simenrostad/Bachelor-Nordic_Semi/Misc/Pichures/Bilder av 3dprintene/bakknapKopi.jpg

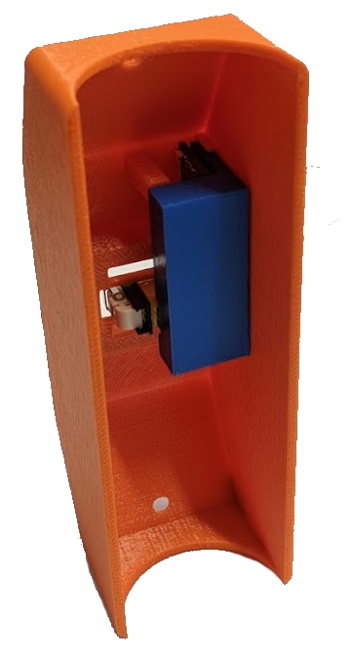
Misc/Pichures/Bilder av 3dprintene/bakknapKopi.jpg
