simenrostad/Bachelor-Nordic_Semi/Misc/readme.md

This folder contains all miscellaneous files and literature used during this project, 
including pictures of tests, 3D print files, flowcharts and links to various web pages that we found useful.
