simenrostad/Bachelor-Nordic_Semi/Hardware/Litteratur/Altium litratur/linker.txt

https://www.ece.ufl.edu/content/altium-designer-video-tutorials

https://altiumvideos.live.altium.com/#Detail/1226

youtube vidioer
-------------------------------------------------
https://www.youtube.com/watch?v=NXB1lSWvcCs

https://www.youtube.com/watch?v=Det_Jr88dBY

https://www.youtube.com/watch?v=TWcL0OF_eQI

https://www.youtube.com/watch?time_continue=5&v=ggVu_U-CsAk

vidioer
-------------------------------------------------
https://www.fedevel.com/academy/portfolio-items/tip-052-in-power-supply-placement-place-output-capacitors-close-to-the-power-output/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
