simenrostad/Bachelor-Nordic_Semi/Misc/Useful links/https.docx

https://devzone.nordicsemi.com/f/nordic-q-a/7597/nrf51-power-management-for-energy-harvesting-applications
