simenrostad/Bachelor-Nordic_Semi/Hardware/simulations/LTC simulering skarakteristikk for effektivitet.xlsx

Voltage mode | Load | Load Ohm |  | 5V | 6V | 7V | 8V | 9V | 10V
1.8V | 100mA | 18 Ohm | 1V8 | 65 | 48 | 39 | 33.6 | 29.2 | 26 | mA
2.5V | 100mA | 25 Ohm | 2V5 | 90 | 65 | 52.5 | 44.1 | 38.4 | 33.9 | mA
3.3V | 100mA | 33 Ohm | 3V3 | 0 | 87 | 68.4 | 56.8 | 49.2 | 43.2 | mA
3.6V | 100mA | 36 Ohm | 3V6 | 0 | 90 * | 74.4 | 62 | 53.2 | 46.8 | mA
 |  | * = not continius suply
