simenrostad/Bachelor-Nordic_Semi/Misc/Measurements and calculations/Energy/Design spesification and energy budget 1.2.xlsx

21 bytes
20ms advertising interval
DCDC
0dBm TX power
ble_app_beacon
BLE event PPK 10 event average values
Voltage | Time in ms | Average current in μA | Work in μWs | percent difference to OPP
2.85 | 25 | 500 | 35.6 | 95.42%
ble_app_pwr_profiler |  |  |  |  | ehsb_nordic_b
BLE event OPP |  |  |  |  | Estimated Work
Voltage | Time in ms | Average current in μA | Work in μWs |  | Work in μWs
1.7 | 25 | 739 | 31.4 |  | 24.0
1.8 | 25 | 713 | 32.1 |  | 24.5
1.9 | 25 | 684 | 32.5 |  | 24.8
2 | 25 | 661 | 33.0 |  | 25.2
2.1 | 25 | 640 | 33.6 |  | 25.6
2.2 | 25 | 621 | 34.2 |  | 26.1
2.3 | 25 | 603 | 34.7 |  | 26.5
2.4 | 25 | 586 | 35.2 |  | 26.8
2.5 | 25 | 570 | 35.6 |  | 27.2
2.6 | 25 | 555 | 36.1 |  | 27.5
2.7 | 25 | 542 | 36.6 |  | 27.9
2.8 | 25 | 530 | 37.1 |  | 28.3
2.85 | 25 | 524 | 37.3 |  | 28.5
2.9 | 25 | 519 | 37.6 |  | 28.7
3 | 25 | 508 | 38.1 |  | 29.1
3.1 | 25 | 497 | 38.5 |  | 29.4
3.2 | 25 | 485 | 38.8 |  | 29.6
3.3 | 25 | 478 | 39.4 |  | 30.1
3.4 | 25 | 471 | 40.0 |  | 30.6
3.5 | 25 | 465 | 40.7 |  | 31.0
3.6 | 25 | 460 | 41.4 |  | 31.6
 |  |  |  |  | percent change 2,85 to 1,8
 |  |  |  |  | 0.86
Best measurements are at DK voltage 2,85V
ehsb_nordic_b
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
