simenrostad/Bachelor-Nordic_Semi/Hardware/Litteratur/Impedanc calculator 1.PNG

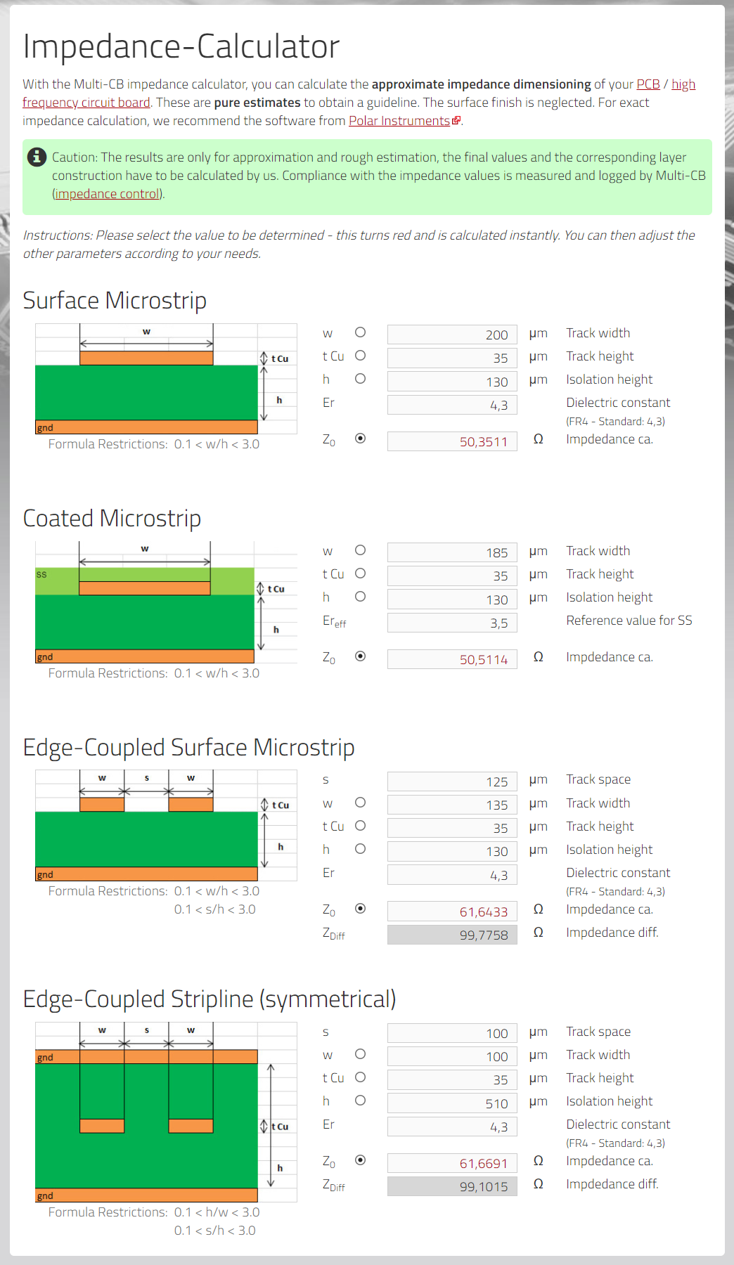
Hardware/Litteratur/Impedanc calculator 1.PNG
