simenrostad/Bachelor-Nordic_Semi/Hardware/Litteratur/Impedanc calculator 2.PNG

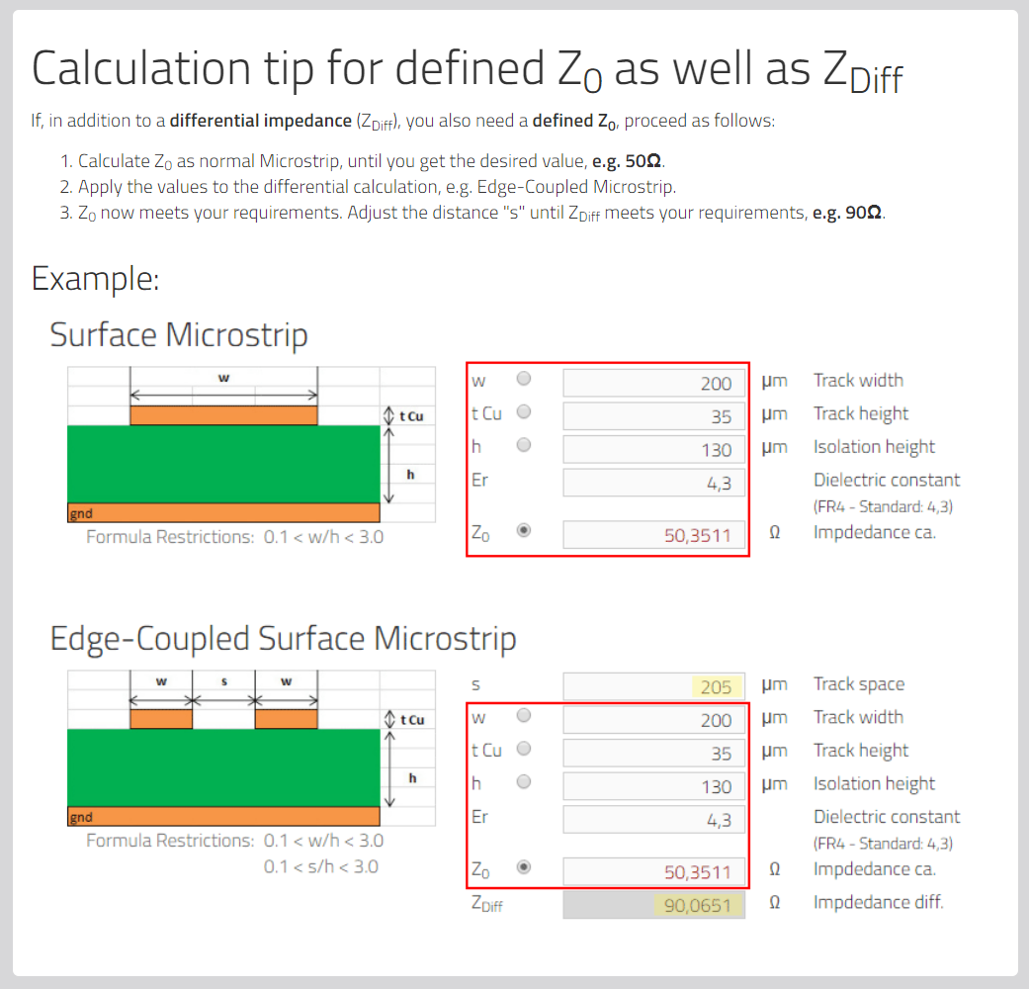
Hardware/Litteratur/Impedanc calculator 2.PNG
