simenrostad/Bachelor-Nordic_Semi/Hardware/System Block Diagram.png

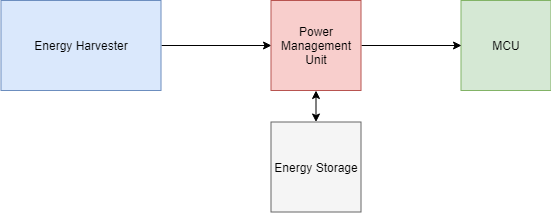
Hardware/System Block Diagram.png
