simenrostad/Bachelor-Nordic_Semi/Misc/Pichures/Bilder av 3dprintene/bakknap.jpg

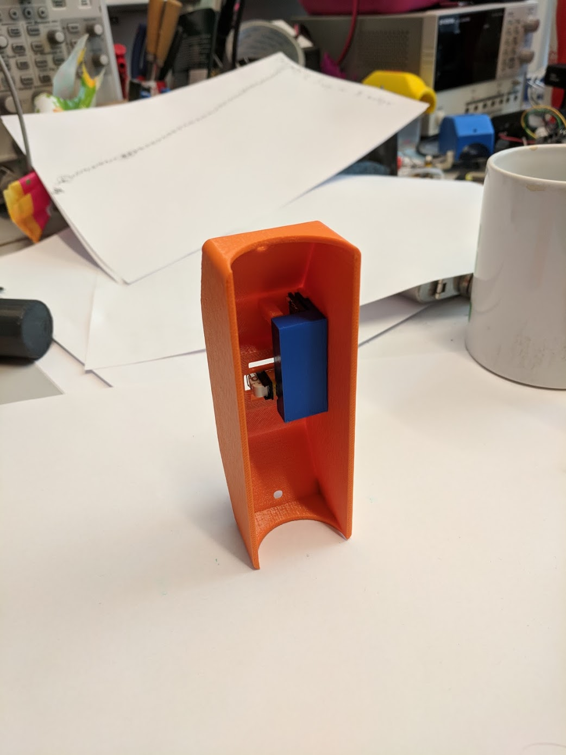
Misc/Pichures/Bilder av 3dprintene/bakknap.jpg
