simenrostad/Bachelor-Nordic_Semi/Misc/Pichures/Bilder av 3dprintene/blodknapp – Kopi.jpg

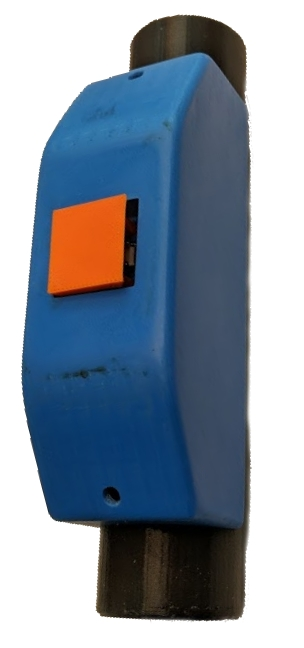
Misc/Pichures/Bilder av 3dprintene/blodknapp – Kopi.jpg
