simenrostad/Bachelor-Nordic_Semi/Misc/Pichures/Bilder av 3dprintene/blodknapp.jpg

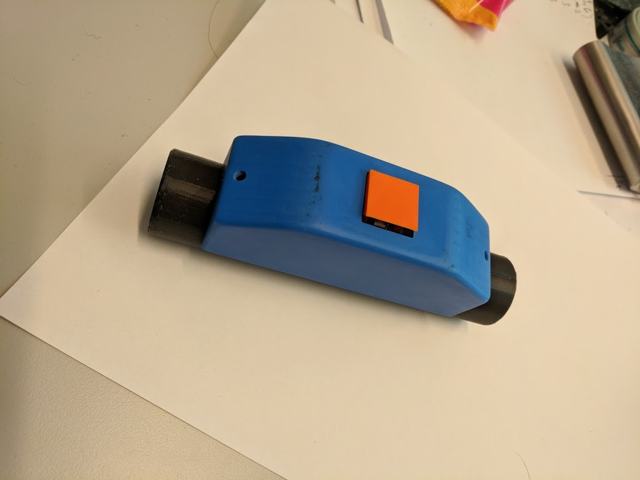
Misc/Pichures/Bilder av 3dprintene/blodknapp.jpg
