simenrostad/Bachelor-Nordic_Semi/Misc/Pichures/Bilder av 3dprintene/Realayer.jpg

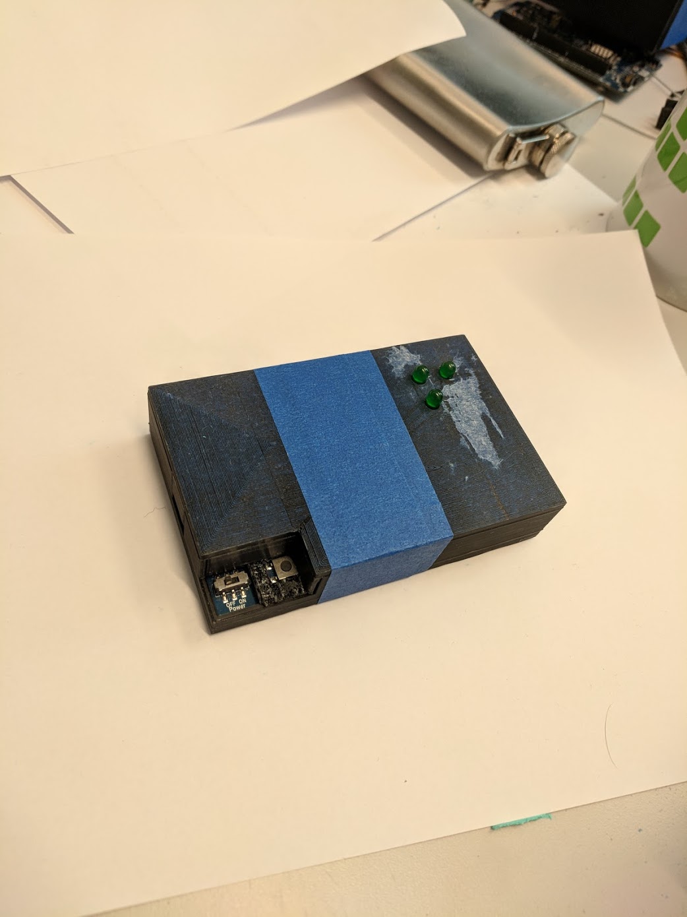
Misc/Pichures/Bilder av 3dprintene/Realayer.jpg
