simenrostad/Bachelor-Nordic_Semi/Misc/Pichures/Bilder av 3dprintene/RealayerKopi.jpg

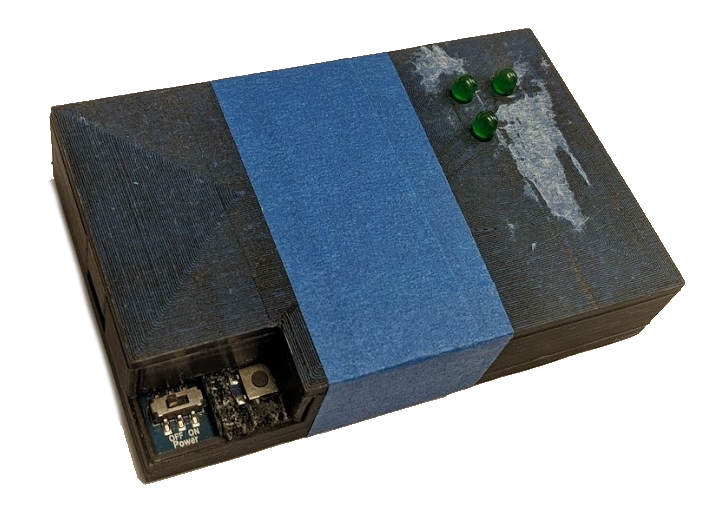
Misc/Pichures/Bilder av 3dprintene/RealayerKopi.jpg
