simenrostad/Bachelor-Nordic_Semi/Misc/Pichures/Bilder av 3dprintene/rodsknap.jpg

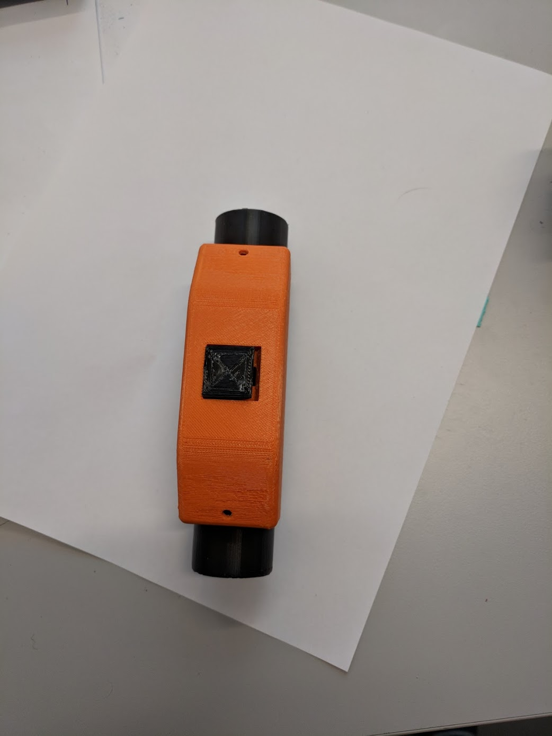
Misc/Pichures/Bilder av 3dprintene/rodsknap.jpg
