simenrostad/Bachelor-Nordic_Semi/Misc/Pichures/Bilder av 3dprintene/rodsknapKopi.jpg

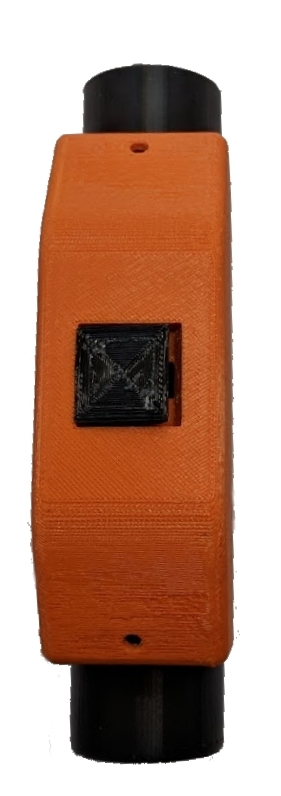
Misc/Pichures/Bilder av 3dprintene/rodsknapKopi.jpg
