simenrostad/Bachelor-Nordic_Semi/Misc/Pichures/Bilder av 3dprintene/STOPsighn.jpg

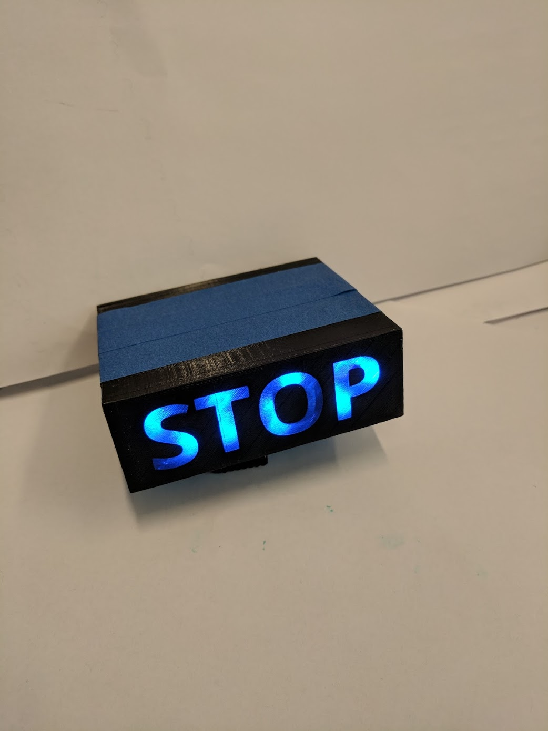
Misc/Pichures/Bilder av 3dprintene/STOPsighn.jpg
