simenrostad/Bachelor-Nordic_Semi/Misc/Pichures/Bilder av 3dprintene/STOPsighnKopi.jpg

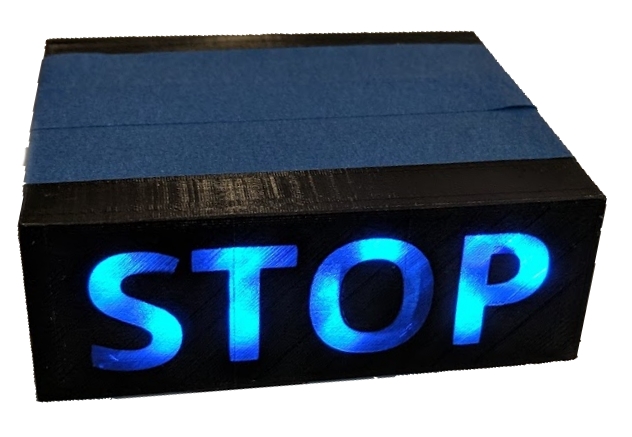
Misc/Pichures/Bilder av 3dprintene/STOPsighnKopi.jpg
