simenrostad/Bachelor-Nordic_Semi/Misc/Pichures/Bileter av 3D-ting/knapp_allerfyrste_front.png

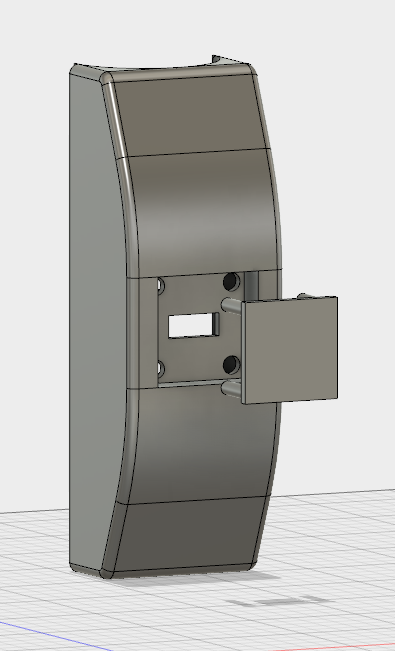
Misc/Pichures/Bileter av 3D-ting/knapp_allerfyrste_front.png
