simenrostad/Bachelor-Nordic_Semi/Misc/Pichures/Bileter av 3D-ting/knapp_denfyrste.png

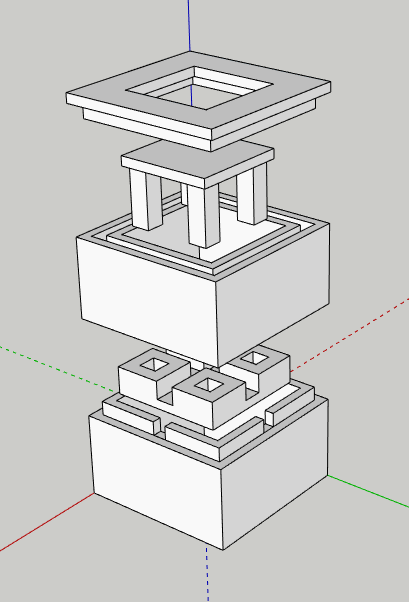
Misc/Pichures/Bileter av 3D-ting/knapp_denfyrste.png
