simenrostad/Bachelor-Nordic_Semi/Misc/Pichures/Bileter av 3D-ting/mini_1.png.PNG

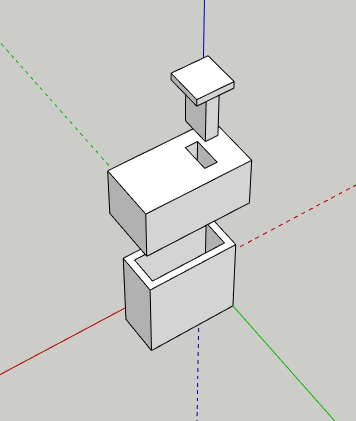
Misc/Pichures/Bileter av 3D-ting/mini_1.png.PNG
