simenrostad/Bachelor-Nordic_Semi/Misc/Pichures/Bileter av 3D-ting/mini_snapgreier.PNG

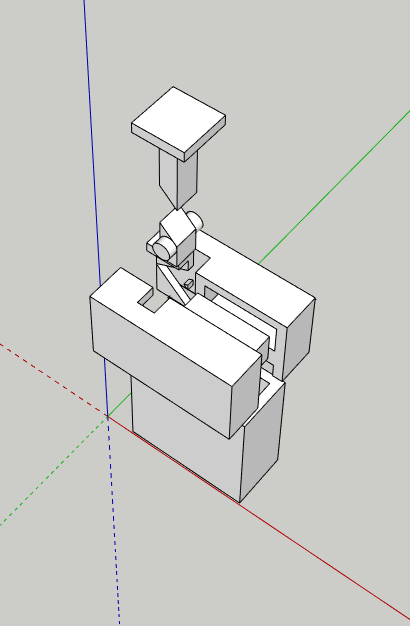
Misc/Pichures/Bileter av 3D-ting/mini_snapgreier.PNG
