simenrostad/Bachelor-Nordic_Semi/Misc/Pichures/Bileter av 3D-ting/mini_snurreting.PNG

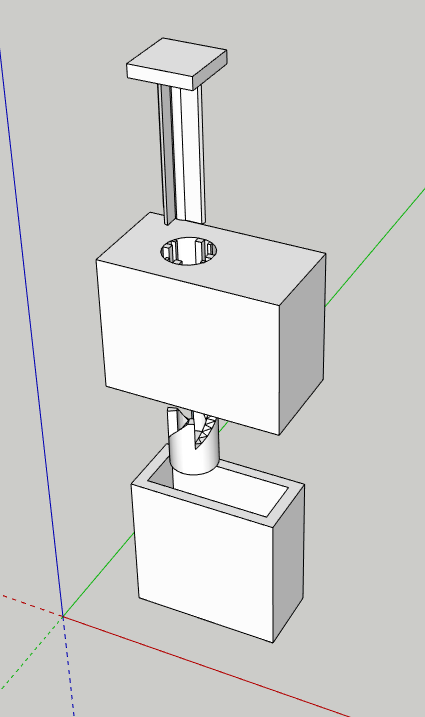
Misc/Pichures/Bileter av 3D-ting/mini_snurreting.PNG
