simenrostad/Bachelor-Nordic_Semi/Misc/Pichures/Bileter av 3D-ting/plass til gibbrett og batteri.PNG

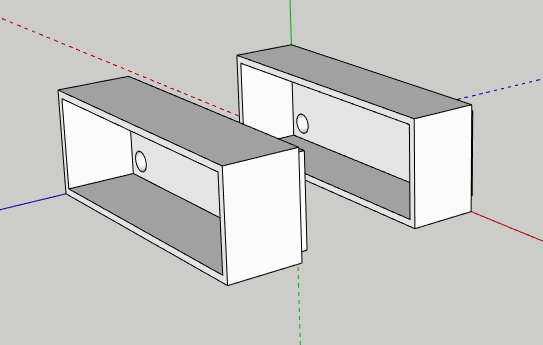
Misc/Pichures/Bileter av 3D-ting/plass til gibbrett og batteri.PNG
