simenrostad/Bachelor-Nordic_Semi/Misc/Pichures/gant1.PNG

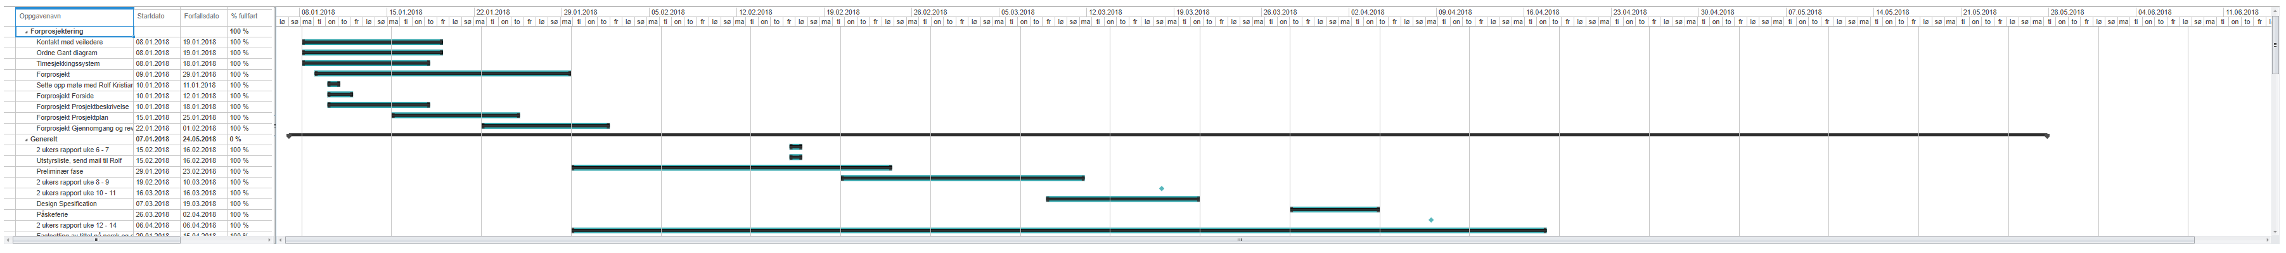
Misc/Pichures/gant1.PNG
