simenrostad/Bachelor-Nordic_Semi/Misc/Pictures/04mai_dc-dcanalycer molinger.PNG

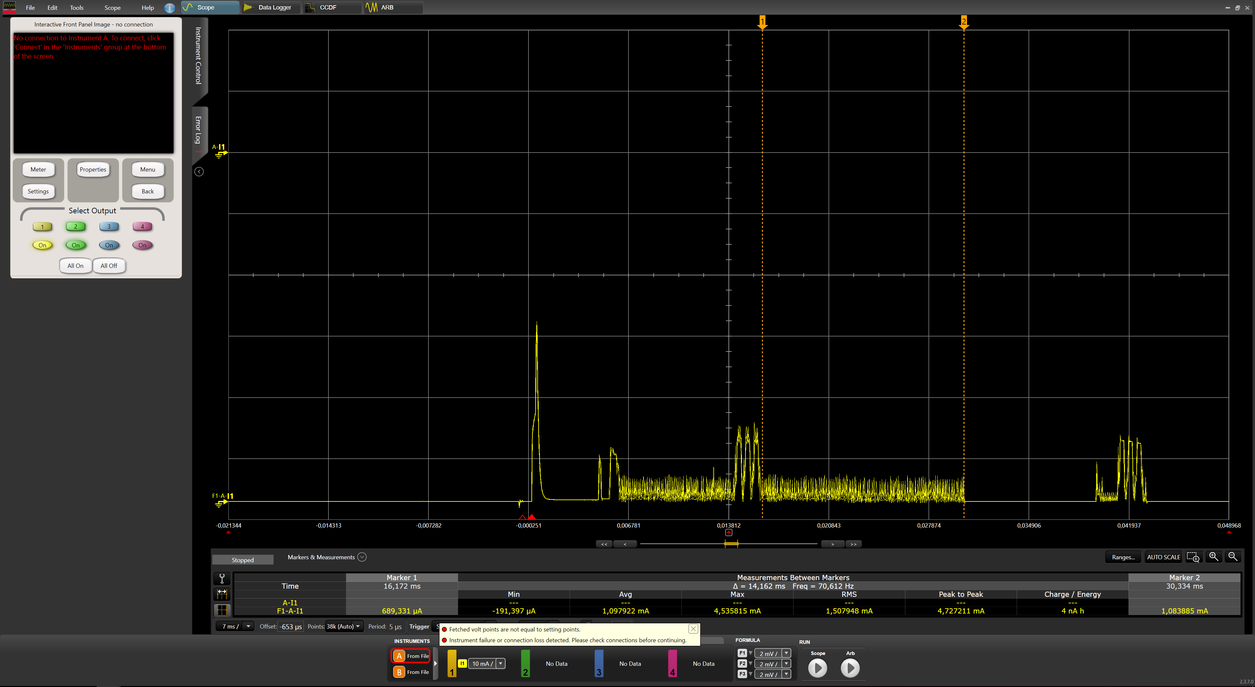
Misc/Pictures/04mai_dc-dcanalycer molinger.PNG
