simenrostad/Bachelor-Nordic_Semi/Misc/Pictures/5packages.png

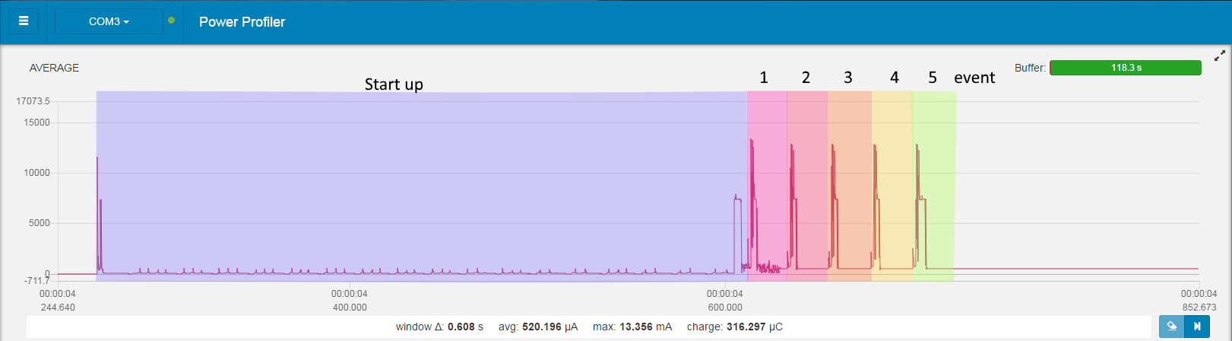
Misc/Pictures/5packages.png
