simenrostad/Bachelor-Nordic_Semi/Misc/Pictures/30926791_10215877826407681_405234090_o.png

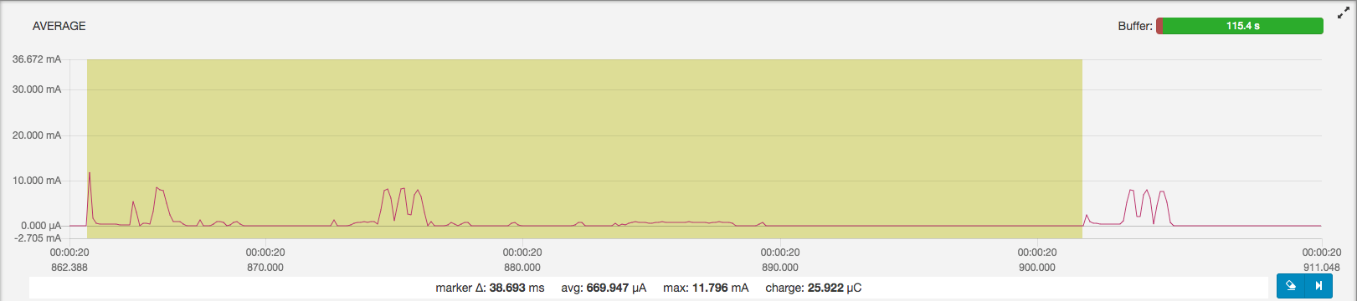
Misc/Pictures/30926791_10215877826407681_405234090_o.png
