simenrostad/Bachelor-Nordic_Semi/Misc/Pictures/31248437_10215877827527709_2145009376_o.png

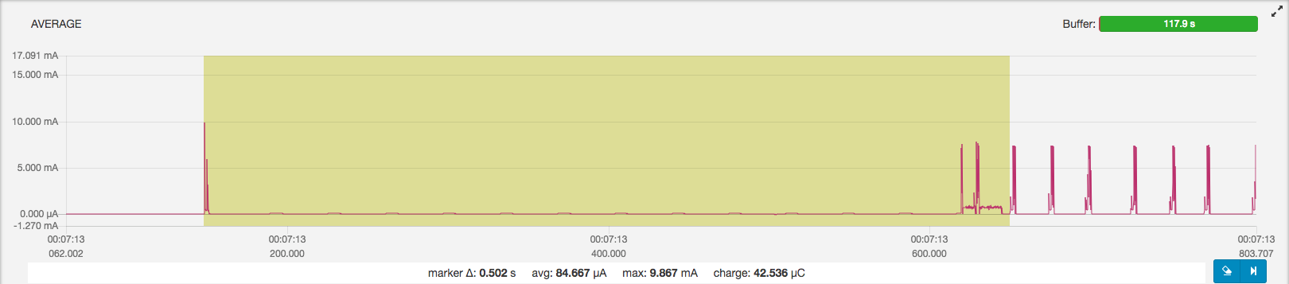
Misc/Pictures/31248437_10215877827527709_2145009376_o.png
