simenrostad/Bachelor-Nordic_Semi/Misc/Pictures/afigspoooulandf.PNG

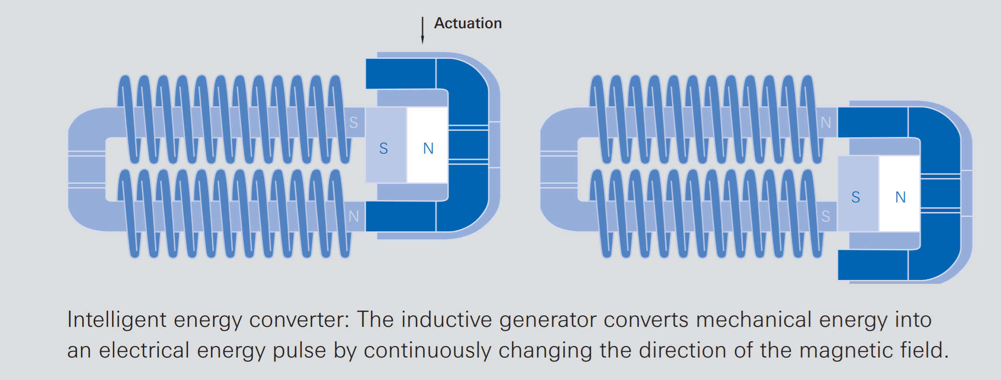
Misc/Pictures/afigspoooulandf.PNG
