simenrostad/Bachelor-Nordic_Semi/Misc/Pictures/afigspoooulandflow.PNG

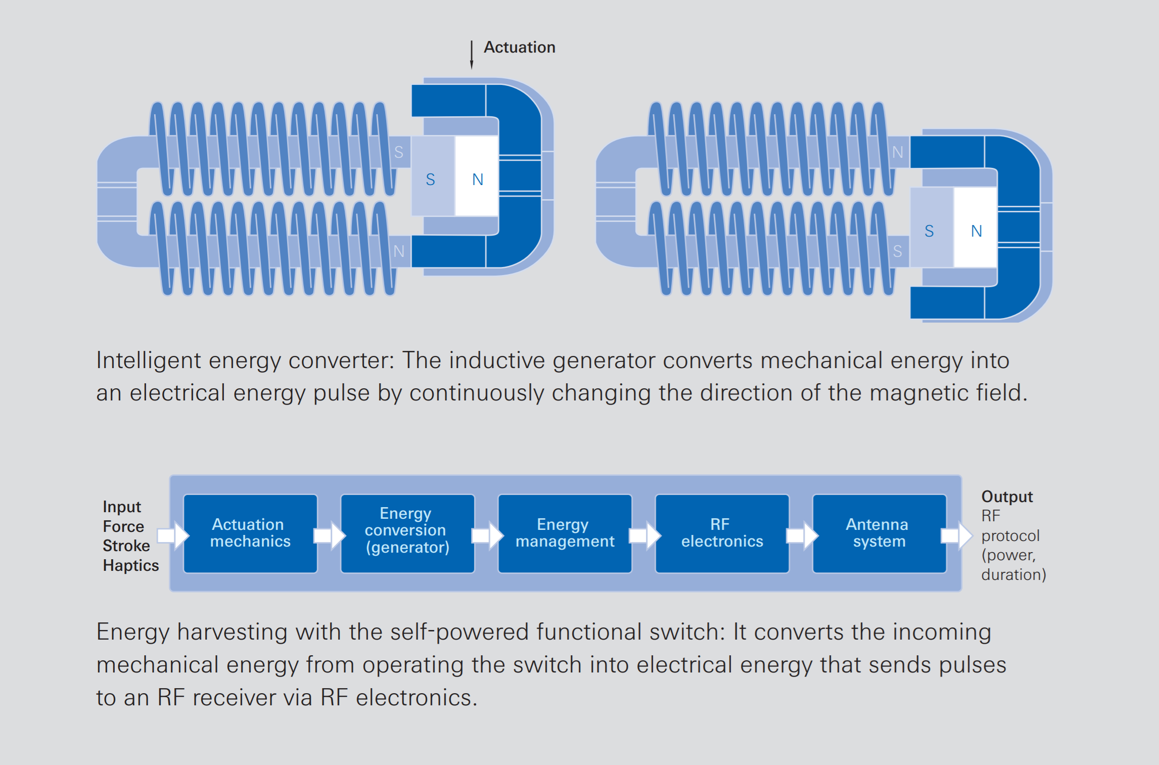
Misc/Pictures/afigspoooulandflow.PNG
