simenrostad/Bachelor-Nordic_Semi/Misc/Pictures/Bileter av 3D-ting/central_casing.png

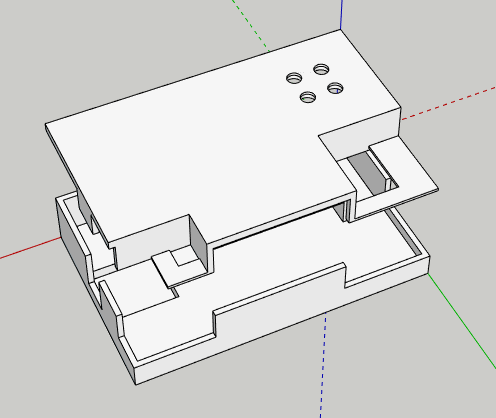
Misc/Pictures/Bileter av 3D-ting/central_casing.png
