simenrostad/Bachelor-Nordic_Semi/Misc/Pictures/Bileter av 3D-ting/CentralBoks_bunn.PNG

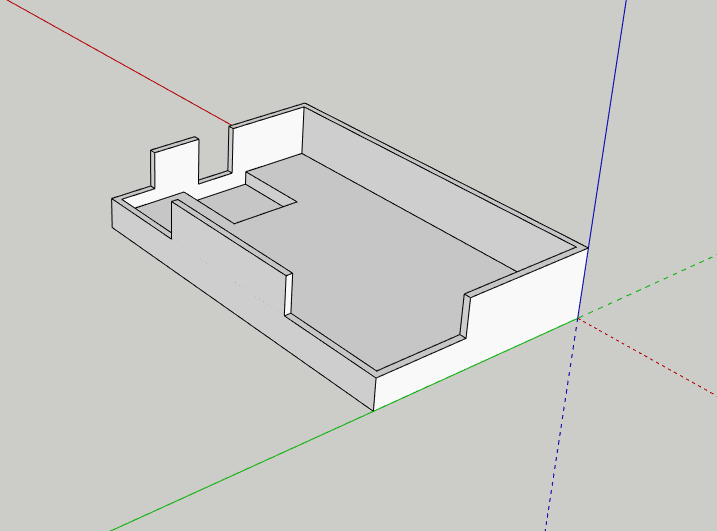
Misc/Pictures/Bileter av 3D-ting/CentralBoks_bunn.PNG
