simenrostad/Bachelor-Nordic_Semi/Misc/Pictures/Bileter av 3D-ting/CentralBoks_topp.PNG

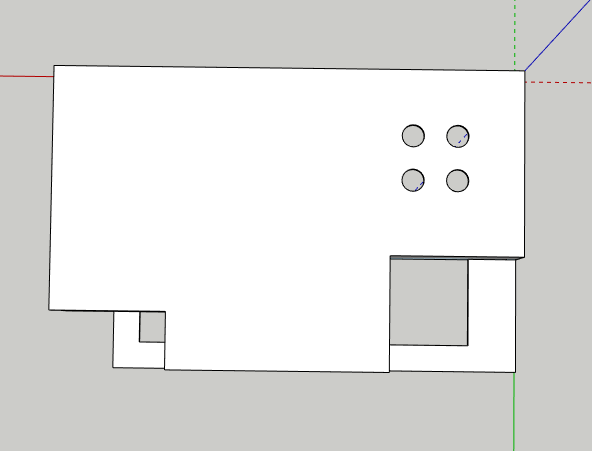
Misc/Pictures/Bileter av 3D-ting/CentralBoks_topp.PNG
