simenrostad/Bachelor-Nordic_Semi/Misc/Pictures/Bileter av 3D-ting/CentralBoks_topp_littfrasida.PNG

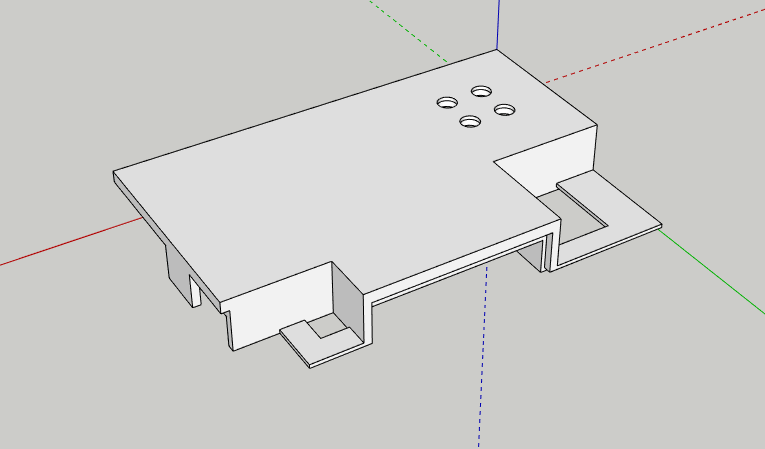
Misc/Pictures/Bileter av 3D-ting/CentralBoks_topp_littfrasida.PNG
