simenrostad/Bachelor-Nordic_Semi/Misc/Pictures/Bileter av 3D-ting/knapp_casing_final_front.PNG

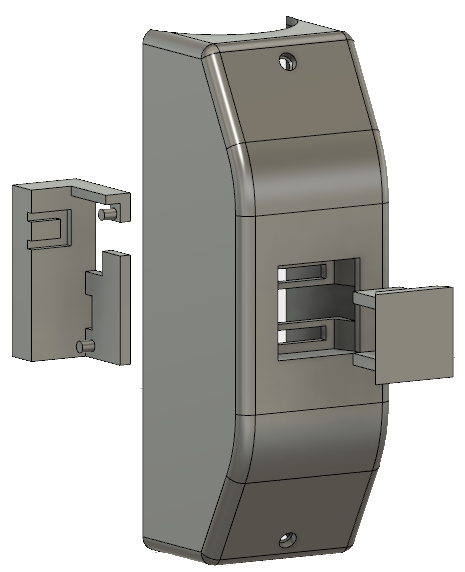
Misc/Pictures/Bileter av 3D-ting/knapp_casing_final_front.PNG
