simenrostad/Bachelor-Nordic_Semi/Misc/Pictures/Bileter av 3D-ting/knapp_casing_firstiteration_back.PNG

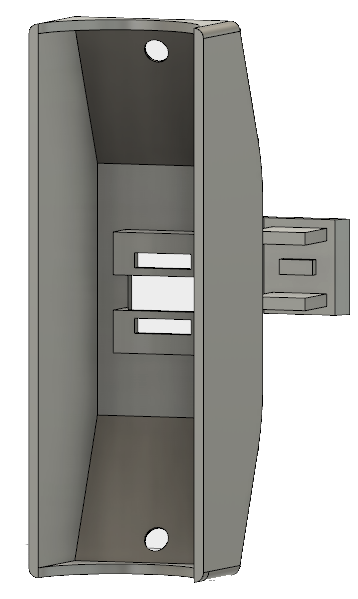
Misc/Pictures/Bileter av 3D-ting/knapp_casing_firstiteration_back.PNG
