simenrostad/Bachelor-Nordic_Semi/Misc/Pictures/Bileter av 3D-ting/Knapp_front.PNG

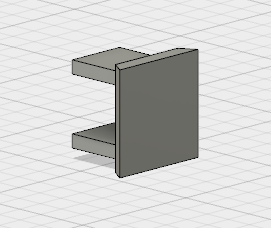
Misc/Pictures/Bileter av 3D-ting/Knapp_front.PNG
