simenrostad/Bachelor-Nordic_Semi/Misc/Pictures/Bileter av 3D-ting/KnappHus_frontoghøgre.PNG

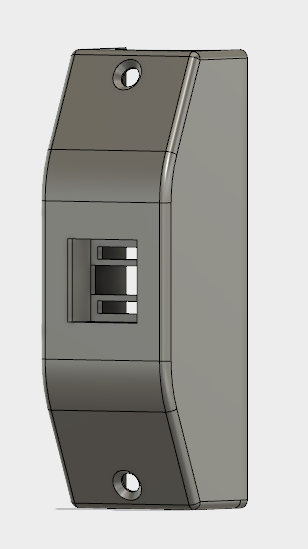
Misc/Pictures/Bileter av 3D-ting/KnappHus_frontoghøgre.PNG
