simenrostad/Bachelor-Nordic_Semi/Misc/Pictures/Bileter av 3D-ting/KnappHus_frontogvenstre.PNG

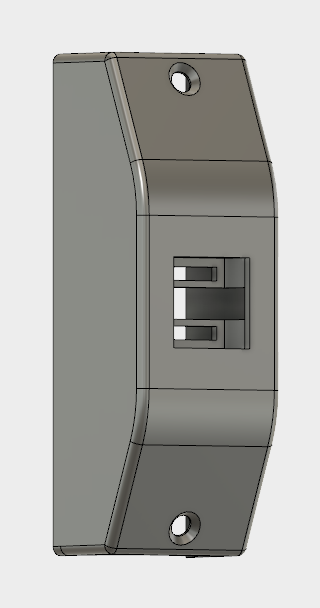
Misc/Pictures/Bileter av 3D-ting/KnappHus_frontogvenstre.PNG
