simenrostad/Bachelor-Nordic_Semi/Misc/Pictures/Bileter av 3D-ting/KnappHusmedTrykketing_front.PNG

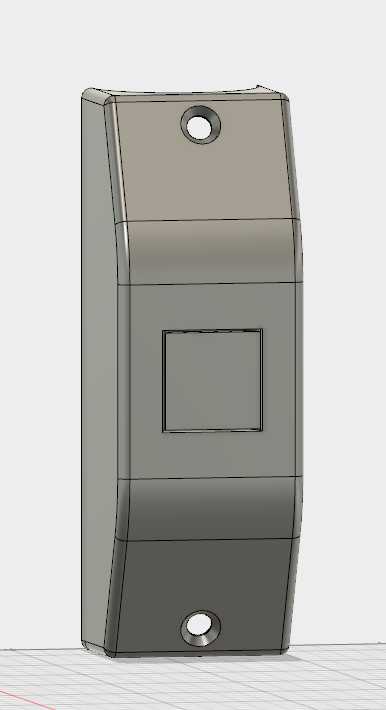
Misc/Pictures/Bileter av 3D-ting/KnappHusmedTrykketing_front.PNG
