simenrostad/Bachelor-Nordic_Semi/Misc/Pictures/Bileter av 3D-ting/KnappHusmedTrykketing_front_fargar.PNG

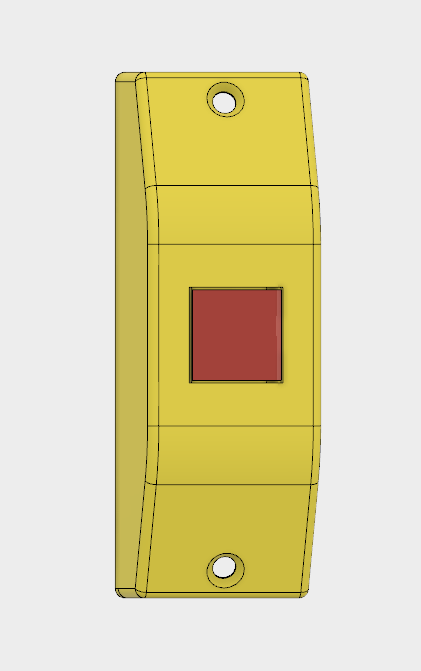
Misc/Pictures/Bileter av 3D-ting/KnappHusmedTrykketing_front_fargar.PNG
