simenrostad/Bachelor-Nordic_Semi/Misc/Pictures/Bileter av 3D-ting/relayer_casing.PNG

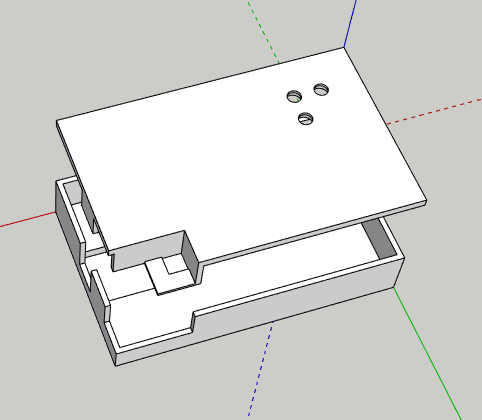
Misc/Pictures/Bileter av 3D-ting/relayer_casing.PNG
