simenrostad/Bachelor-Nordic_Semi/Misc/Pictures/Bileter av 3D-ting/RelayerBoks_bunn.PNG

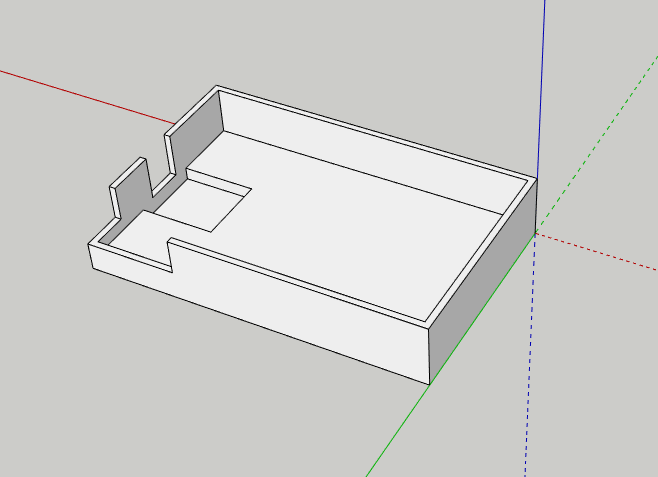
Misc/Pictures/Bileter av 3D-ting/RelayerBoks_bunn.PNG
