simenrostad/Bachelor-Nordic_Semi/Misc/Pictures/Bileter av 3D-ting/Stoppskilt_LED-plate.PNG

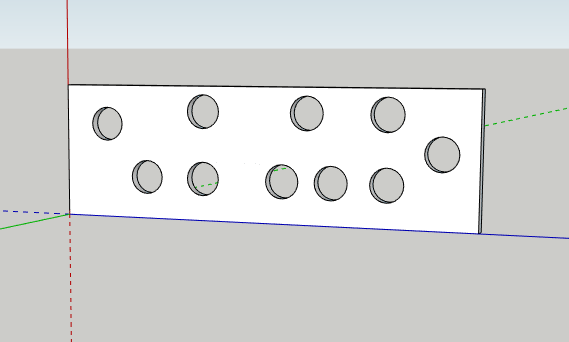
Misc/Pictures/Bileter av 3D-ting/Stoppskilt_LED-plate.PNG
