simenrostad/Bachelor-Nordic_Semi/Misc/Pictures/Bileter av 3D-ting/Stoppskilt_lokk_ut.PNG

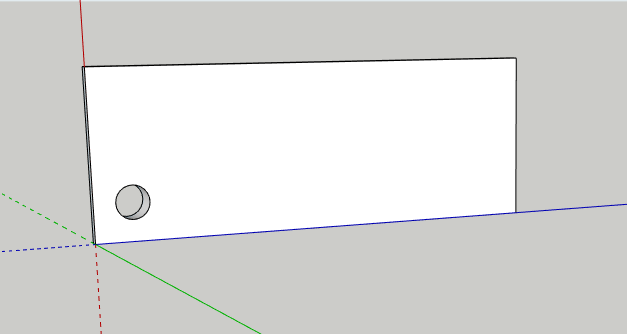
Misc/Pictures/Bileter av 3D-ting/Stoppskilt_lokk_ut.PNG
