simenrostad/Bachelor-Nordic_Semi/Misc/Pictures/Bileter av 3D-ting/Stoppskilt_plasstilGibbrettogBatteri_front.PNG

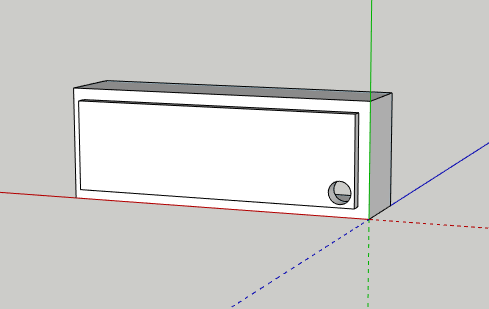
Misc/Pictures/Bileter av 3D-ting/Stoppskilt_plasstilGibbrettogBatteri_front.PNG
