simenrostad/Bachelor-Nordic_Semi/Misc/Pictures/BLE_event_1V8.PNG

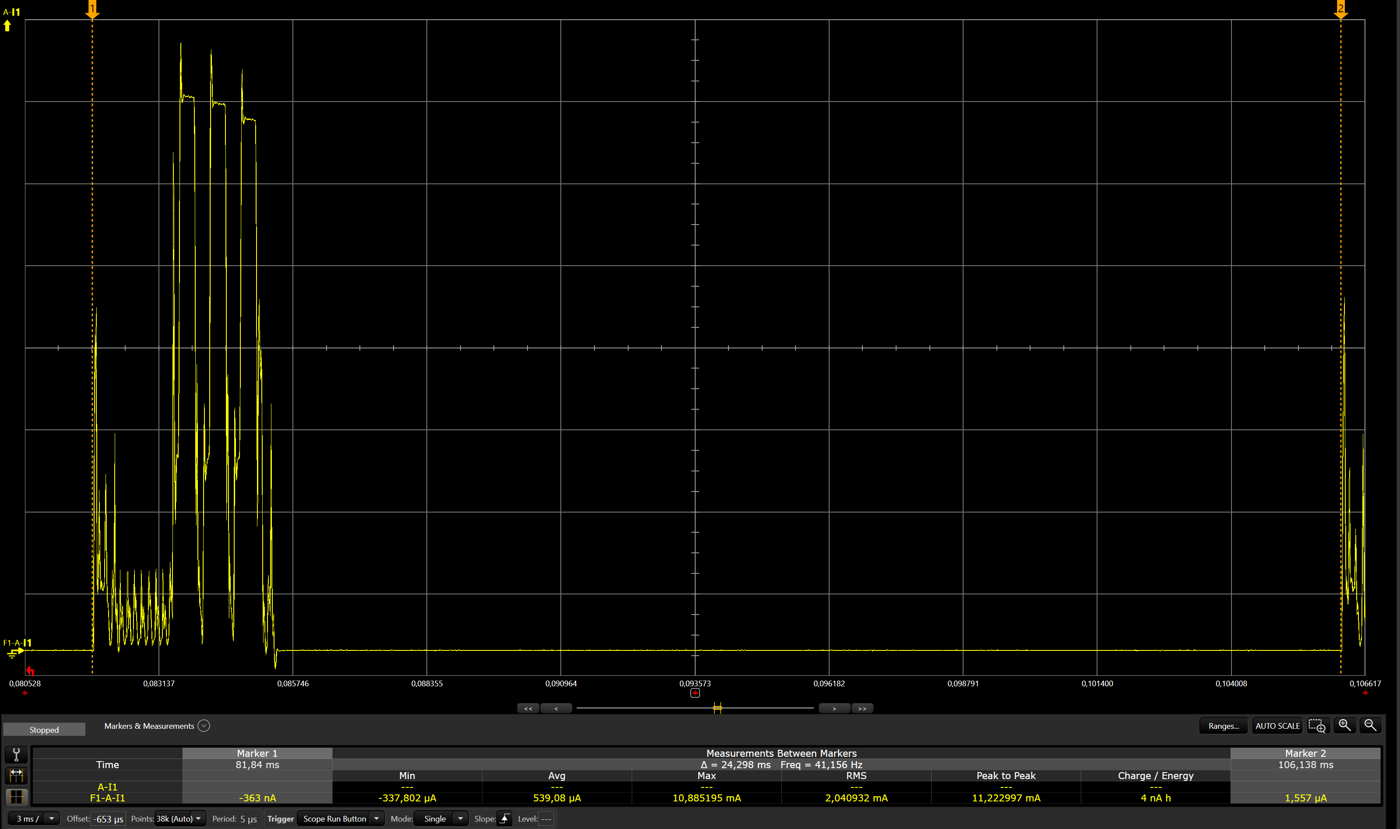
Misc/Pictures/BLE_event_1V8.PNG
