simenrostad/Bachelor-Nordic_Semi/Misc/Pictures/Efficiency_vs_VIN_for_100mA.PNG

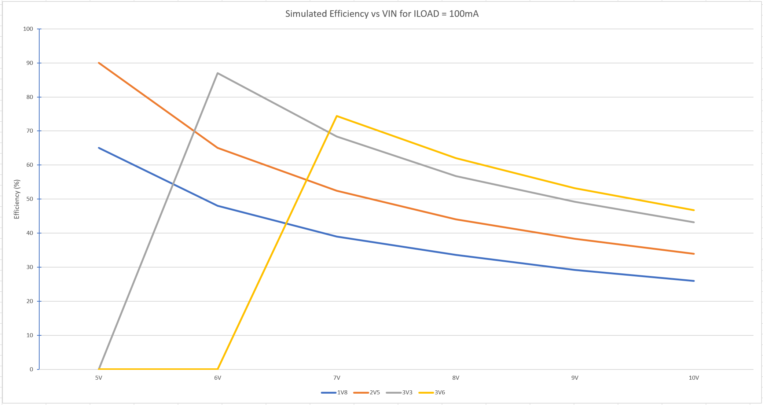
Misc/Pictures/Efficiency_vs_VIN_for_100mA.PNG
