simenrostad/Bachelor-Nordic_Semi/Misc/Pictures/Keysight_meshurments/1event_1V8_1.png

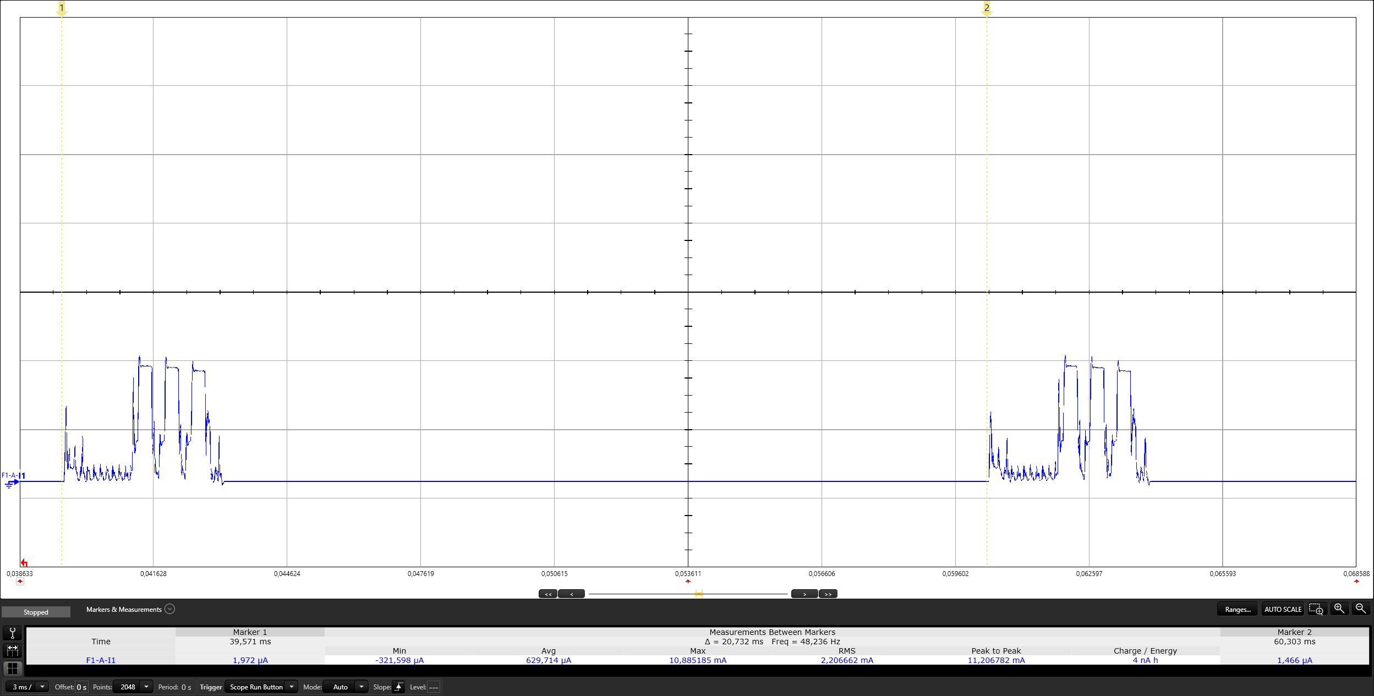
Misc/Pictures/Keysight_meshurments/1event_1V8_1.png
