simenrostad/Bachelor-Nordic_Semi/Misc/Pictures/Keysight_meshurments/Startup_1V8_2.png

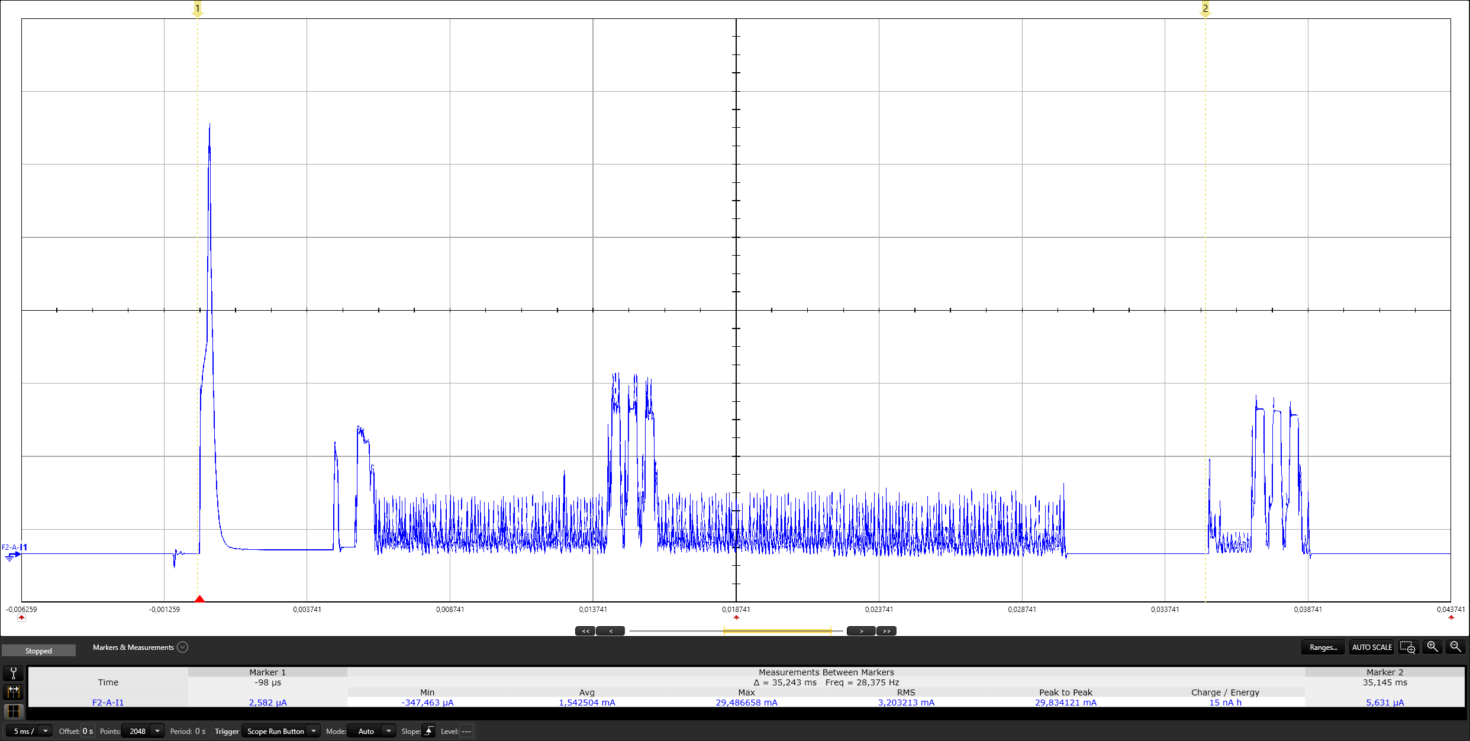
Misc/Pictures/Keysight_meshurments/Startup_1V8_2.png
