simenrostad/Bachelor-Nordic_Semi/Misc/Pictures/Keysight_meshurments/Starup_plus_1event_1V8_1.png

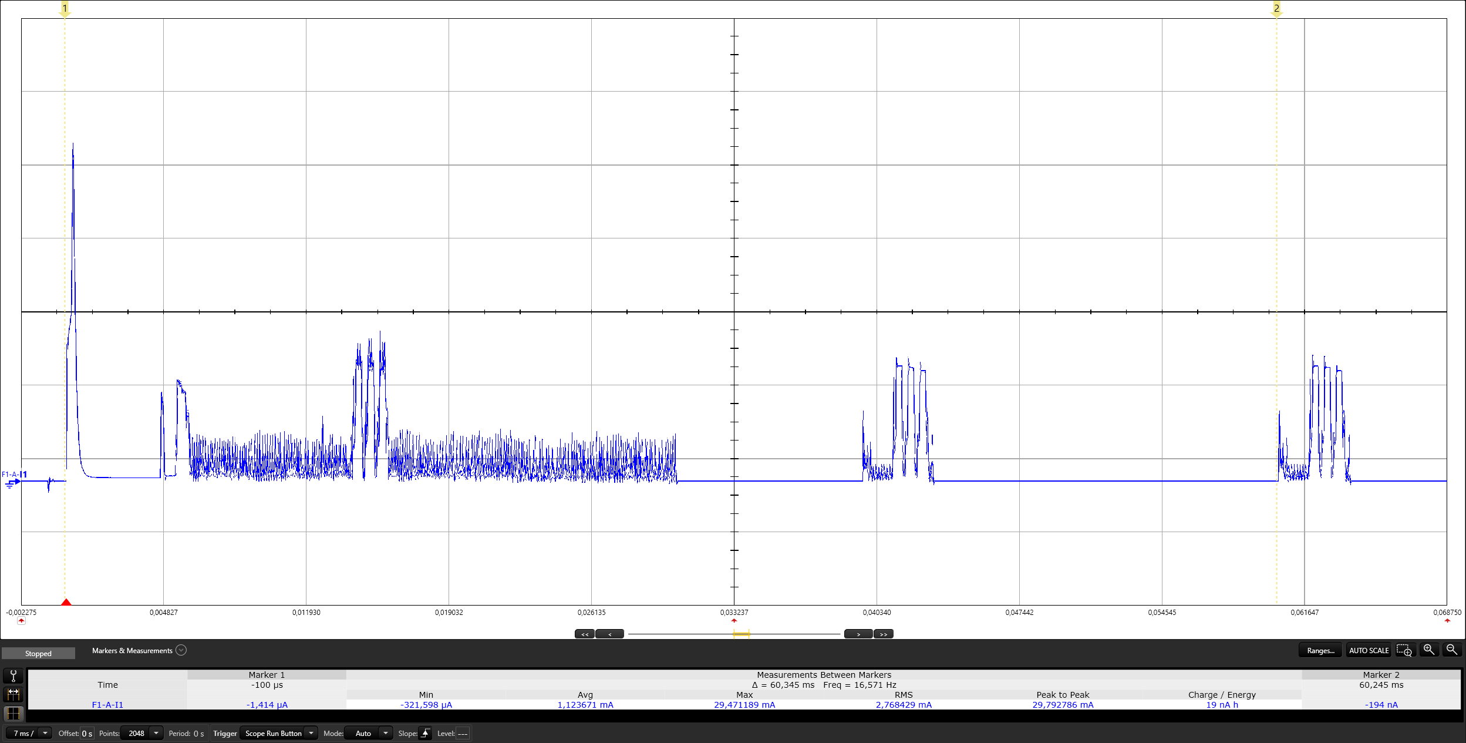
Misc/Pictures/Keysight_meshurments/Starup_plus_1event_1V8_1.png
