simenrostad/Bachelor-Nordic_Semi/Misc/Pictures/LTC_tiny2_2Drender.PNG

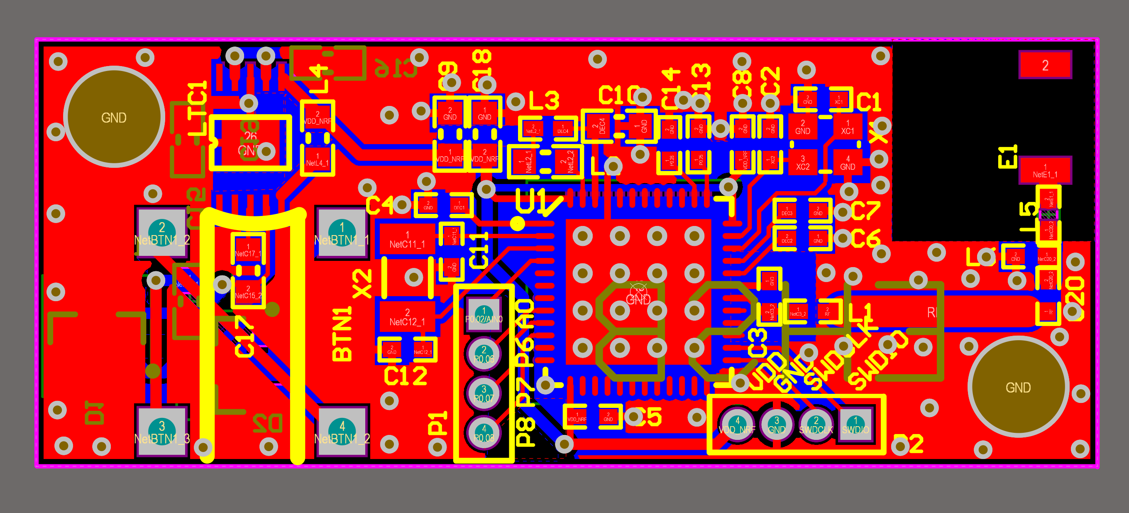
Misc/Pictures/LTC_tiny2_2Drender.PNG
