simenrostad/Bachelor-Nordic_Semi/Misc/Pictures/LTC_tiny2_3Drender.PNG

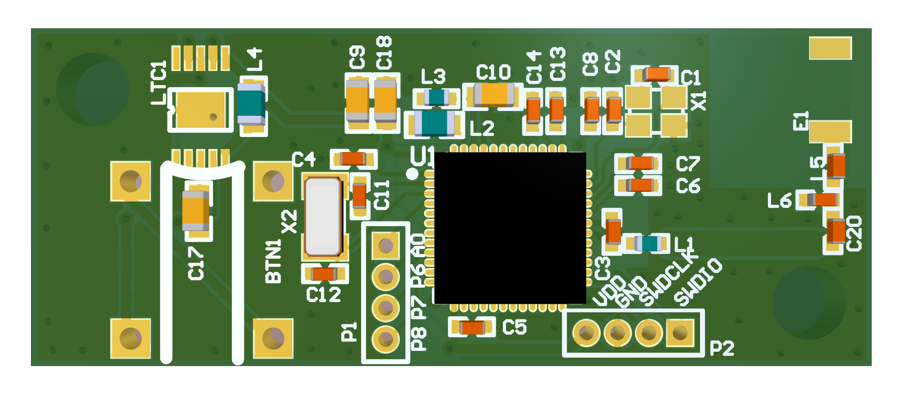
Misc/Pictures/LTC_tiny2_3Drender.PNG
