simenrostad/Bachelor-Nordic_Semi/Misc/Pictures/only central.png

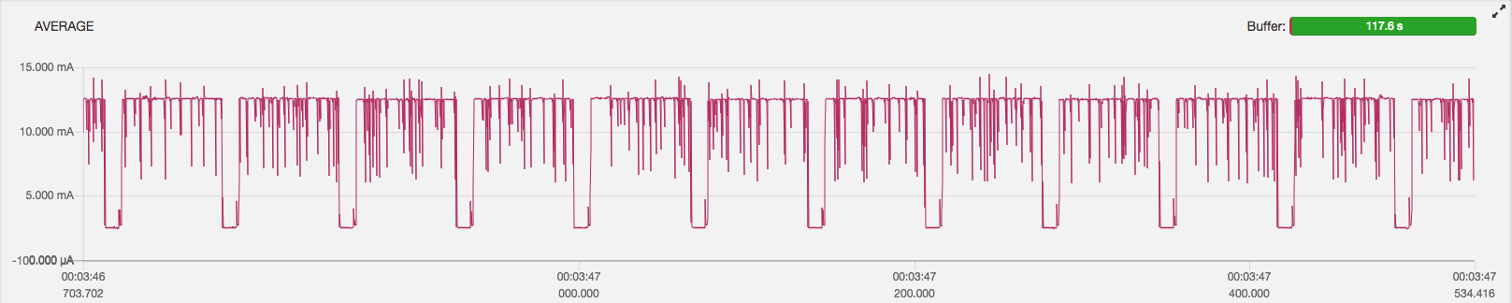
Misc/Pictures/only central.png
