simenrostad/Bachelor-Nordic_Semi/Misc/Pictures/only_central_edit.png

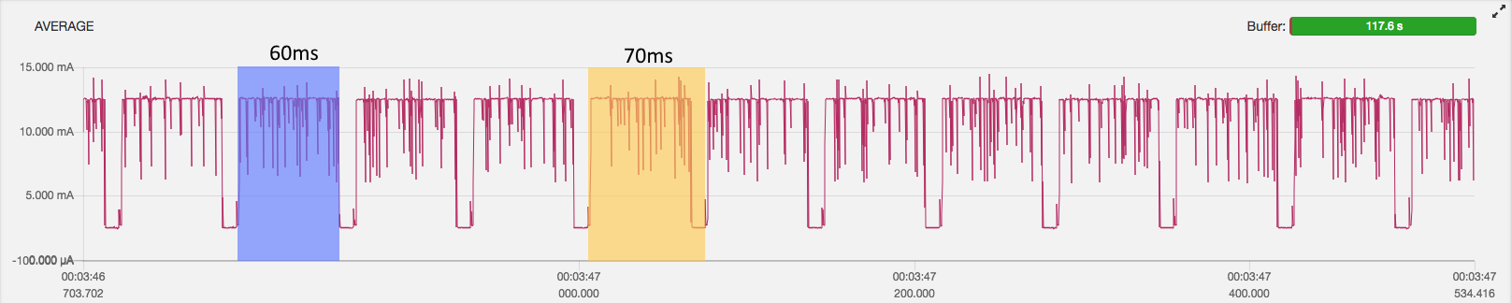
Misc/Pictures/only_central_edit.png
