simenrostad/Bachelor-Nordic_Semi/Misc/Pictures/pizo.PNG

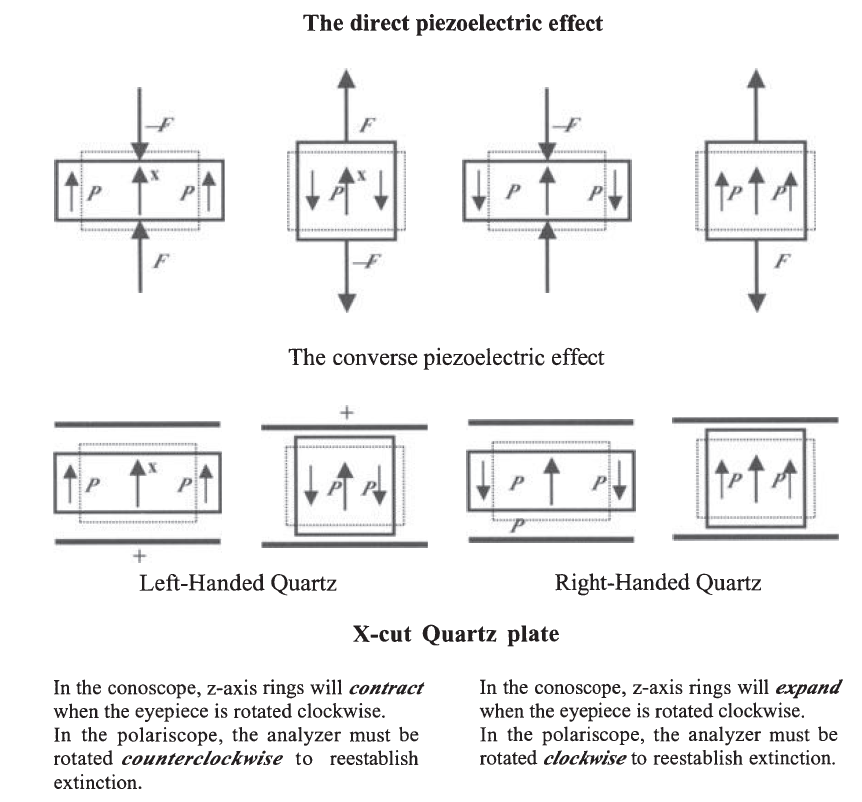
Misc/Pictures/pizo.PNG
