simenrostad/Bachelor-Nordic_Semi/Misc/Pictures/RC_startup.png

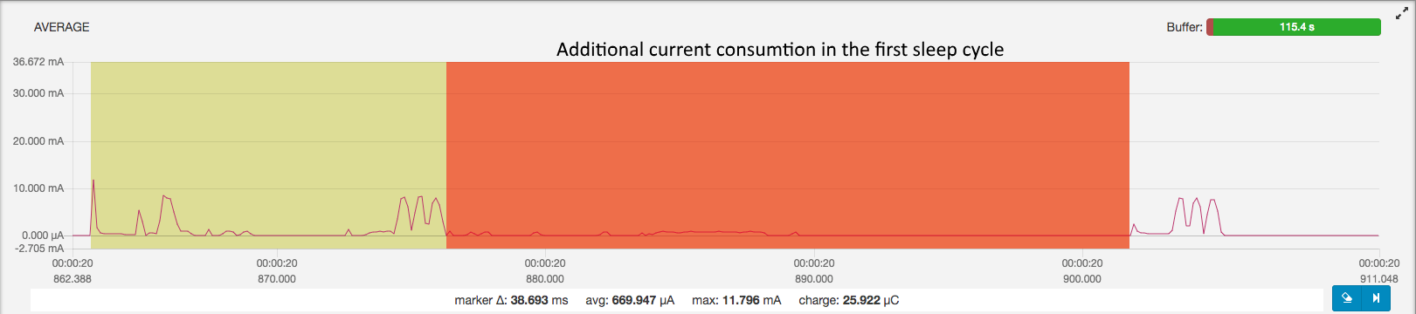
Misc/Pictures/RC_startup.png
