simenrostad/Bachelor-Nordic_Semi/Misc/Pictures/relayerconnected1.png

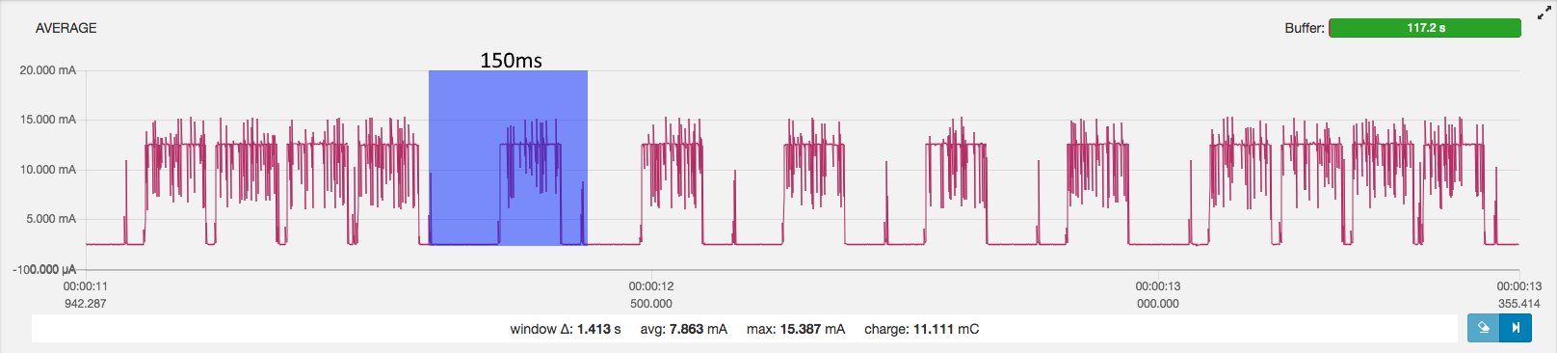
Misc/Pictures/relayerconnected1.png
