simenrostad/Bachelor-Nordic_Semi/Misc/Pictures/relayerconnected.png

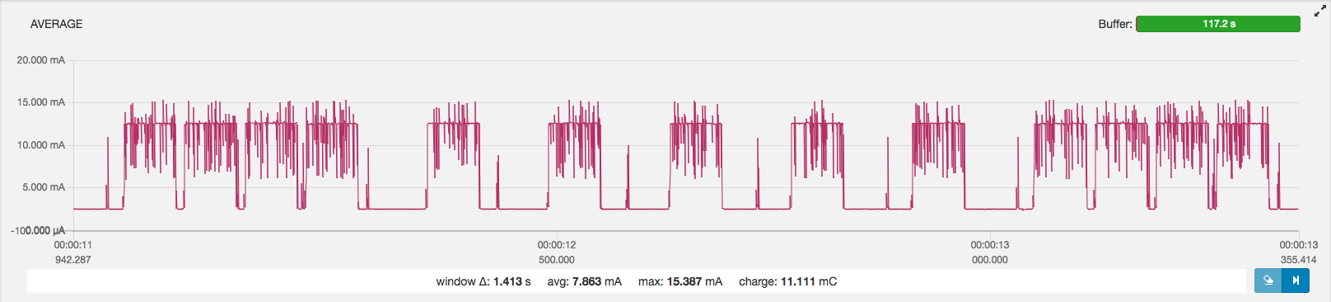
Misc/Pictures/relayerconnected.png
