simenrostad/Bachelor-Nordic_Semi/Misc/Pictures/relayerold.png

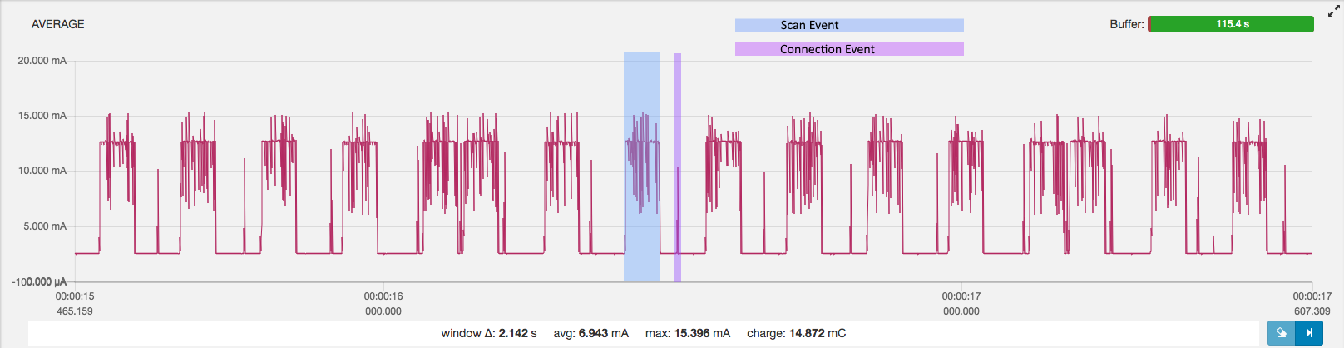
Misc/Pictures/relayerold.png
