simenrostad/Bachelor-Nordic_Semi/Misc/Pictures/startup_1v8.PNG

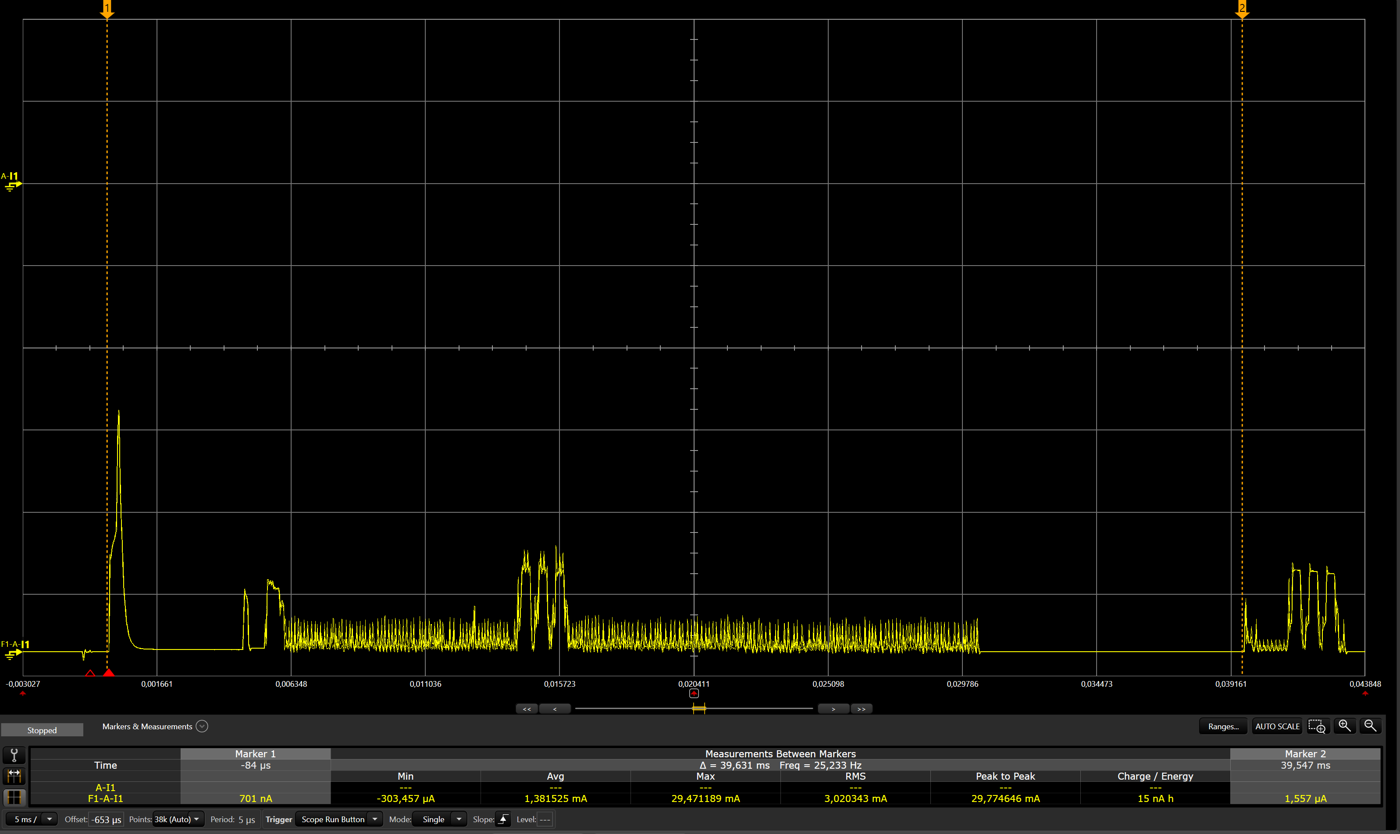
Misc/Pictures/startup_1v8.PNG
