simenrostad/Bachelor-Nordic_Semi/Misc/Pictures/VD_tiny2_2Drender.PNG

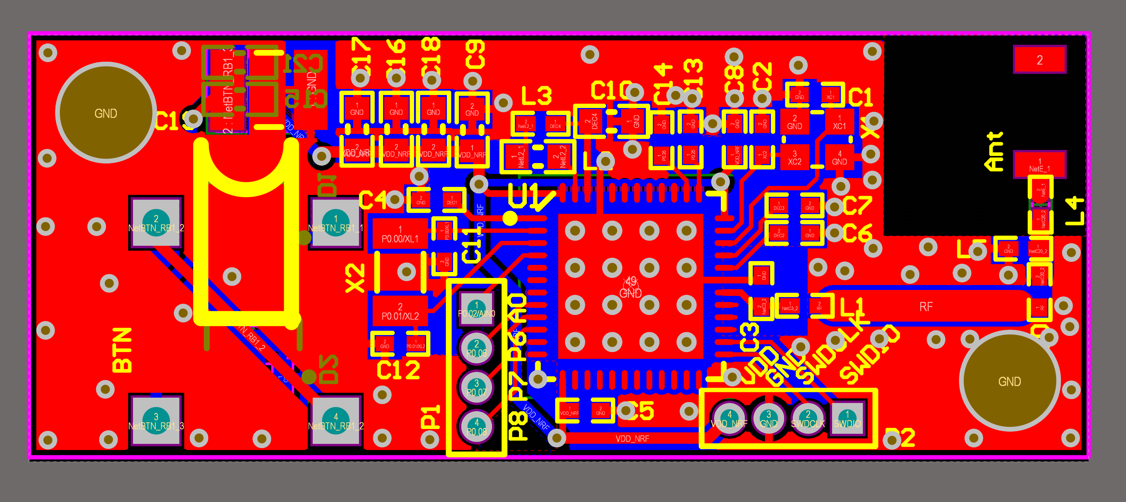
Misc/Pictures/VD_tiny2_2Drender.PNG
