simenrostad/Bachelor-Nordic_Semi/Misc/Pictures/xtal_startup.png

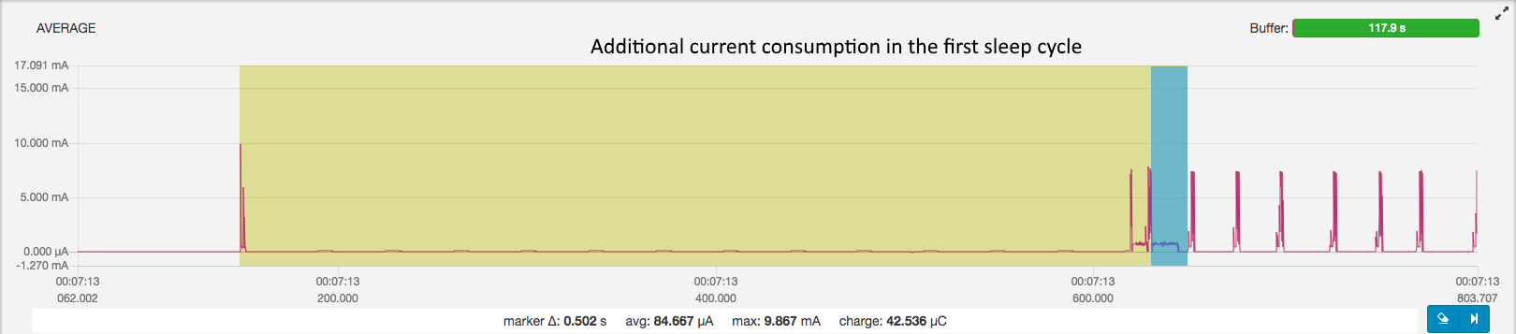
Misc/Pictures/xtal_startup.png
