simenrostad/Bachelor-Nordic_Semi/Misc/Measurements and calculations/Component prize cost per unit EHSB.xlsx

List of components
EHSB VD LTC |  |  |  | tot component count | 35
 | Amount | Footprint | Placment
100nF | 3 | 0402. | C4,C5 og C8
47uF | 2 | 0603. | C15 |  |  | mangler
4.7uF | 2 | 0603. | C9 og C16 |  |  | 15nH
1uF | 2 | 0603. | C10 og C17 |  |  | 3.9nH
100pF | 1 | 0402. | C7
12pF | 6 | 0402. | C1,C2 og C11,C12,C13,C14
0.8pF | 1 | 0402. | C3
22uF | 1 | 0603. | C22
1pF | 1 | 0402. | C20
3.9nH | 2 | 0402. | L1 and L5
10uH | 1 | 0603. | L2
15nH | 1 | 0402. | L3
100uH | 1 | 0603. | L4
2.7nH | 1 | 0402. | L6
32kHZ | 1 | XTAL_3215 | X2
32MHz | 1 | BT-XTAL_2016 | X1
MHDR1x4 | 2 |  | P1 and P2
LTC3588 | 1 | MSE PACKAGE | LTC 1
AFIG0007 | 1 | custom | BTN1
nRF52 | 1 | qfn | U1
antenna | 1 | custom | A1
Diode 1N4004 | 2 | SOT-23_N | D1 and D2
Estemated component price = 33.90 $
EHSB VD |  |  |  | tot component count | 33
 | Amount | Footprint | Placment
100nF | 3 | 0402. | C4,C5 and C8
56uF | 1 | 0603. | C15
4.7uF | 1 | 0603. | C9
1uF | 1 | 0603. | C10
100pF | 1 | 0402. | C7
12pF | 6 | 0402. | C1,C2,C11,C12C13,C14
0.8pF | 1 | 0402. | C3
10uF | 3 | 0603. | C16 , C17 and C18
220uF | 1 | 1210. | C19
1pF | 1 | 0402. | C20
3.9nH | 2 | 0402. | L1 andL4
10uH | 1 | 0603. | L2
15nH | 1 | 0402. | L3
2.7nH | 1 | 0402. | L5
32kHZ | 1 | XTAL_3215 | X2
32MHz | 1 | BT-XTAL_2016 | X1
MH1x4 | 2 |  | P1 and P2
AFIG0007 | 1 | custom | BTN1
nRF52 | 1 | qfn | U1
antenna | 1 | custom | A1
Diode 1N4004 | 2 | SOT-23_N | D1 and D2
Estemated component price = 29.96 $
