simenrostad/Bachelor-Nordic_Semi/Hardware/Components/Komponent liste (undersøk).xlsx

Digekey
Energy harvesting
 | PMIC-Power Management-Specialized |  |  |  |  | PIMC - Battery Chargers |  | PMIC - Voltage Regulators - Special Purpose
name | Digikey part nuber | current suply | Volt - suply | Package/Case | Name | Digikey part nuber | Name | Digikey part nuber
LTC3588 | LTC3588IMSE-1#TRPBF-ND (https://www.digikey.no/product-detail/en/linear-technology-analog-devices/LTC3588IMSE-1-TRPBF/LTC3588IMSE-1-TRPBF-ND/2216348) | 950nA | 2.7 V ~ 20 V | 10-TFSOP, 10-MSOP (0.118", 3.00mm Width) Exposed Pad | ADP5090 | ADP5090ACPZ-2-R7TR-ND (https://www.digikey.no/product-detail/en/analog-devices-inc/ADP5090ACPZ-2-R7/ADP5090ACPZ-2-R7TR-ND/6057010) | LTC3105 | LTC3105EMS#PBF-ND (https://www.digikey.no/product-detail/en/linear-technology-analog-devices/LTC3105EMS-PBF/LTC3105EMS-PBF-ND/2601181)
LTC3588 | LTC3588IDD-1#TRPBF-ND (https://www.digikey.no/product-detail/en/linear-technology-analog-devices/LTC3588IDD-1-TRPBF/LTC3588IDD-1-TRPBF-ND/2216347) | 950nA | 2.7 V ~ 20 V | 10-WFDFN Exposed Pad | ADP5090 | ADP5090ACPZ-2-R7CT-ND (https://www.digikey.no/product-detail/en/analog-devices-inc/ADP5090ACPZ-2-R7/ADP5090ACPZ-2-R7CT-ND/7422296) | LTC3105 | LTC3105EDD#PBF-ND (https://www.digikey.no/product-detail/en/linear-technology-analog-devices/LTC3105EDD-PBF/LTC3105EDD-PBF-ND/2601179)
LTC3588 | LTC3588IDD-1#PBF-ND (https://www.digikey.no/product-detail/en/linear-technology-analog-devices/LTC3588IDD-1-PBF/LTC3588IDD-1-PBF-ND/2216346) | 950nA | 2.7 V ~ 20 V | 10-WFDFN Exposed Pad | ADP5090 | ADP5090ACPZ-2-R7DKR-ND (https://www.digikey.no/product-detail/en/analog-devices-inc/ADP5090ACPZ-2-R7/ADP5090ACPZ-2-R7DKR-ND/7422299)
LTC3588 | LTC3588EMSE-1#TRPBF-ND (https://www.digikey.no/product-detail/en/linear-technology-analog-devices/LTC3588EMSE-1-TRPBF/LTC3588EMSE-1-TRPBF-ND/2216345) | 950nA | 2.7 V ~ 20 V | 10-TFSOP, 10-MSOP (0.118", 3.00mm Width) Exposed Pad
LTC3588 | LTC3588EDD-1#TRPBF-ND (https://www.digikey.no/product-detail/en/linear-technology-analog-devices/LTC3588EDD-1-TRPBF/LTC3588EDD-1-TRPBF-ND/2216344) | 950nA | 2.7 V ~ 20 V | 10-WFDFN Exposed Pad
LTC3588 | LTC3588IMSE-1#PBF-ND (https://www.digikey.no/product-detail/en/linear-technology-analog-devices/LTC3588IMSE-1-PBF/LTC3588IMSE-1-PBF-ND/2213930) | 950nA | 2.7 V ~ 20 V | 10-TFSOP, 10-MSOP (0.118", 3.00mm Width) Exposed Pad
LTC3588 | LTC3588EDD-1#PBF-ND (https://www.digikey.no/product-detail/en/linear-technology-analog-devices/LTC3588EDD-1-PBF/LTC3588EDD-1-PBF-ND/2213927) | 950nA | 2.7 V ~ 20 V | 10-WFDFN Exposed Pad
LTC3588 | LTC3588EMSE-1#PBF-ND (https://www.digikey.no/product-detail/en/linear-technology-analog-devices/LTC3588EMSE-1-PBF/LTC3588EMSE-1-PBF-ND/2213929) | 950nA | 2.7 V ~ 20 V | 10-TFSOP, 10-MSOP (0.118", 3.00mm Width) Exposed Pad
MB39C811 | 1534-1029-6-ND (https://www.digikey.no/product-detail/en/cypress-semiconductor-corp/MB39C811QN-G-EFE2/1534-1029-6-ND/4969432) | 1.9µA | 2.6 V ~ 18 V
MB39C811 | 1534-1029-1-ND (https://www.digikey.no/product-detail/en/cypress-semiconductor-corp/MB39C811QN-G-EFE2/1534-1029-1-ND/4969430) | 1.9µA | 2.6 V ~ 18 V |  |  | PMIC - Voltage Regulator - Linear |  | Miscellaneous
MB39C811 | 1534-1029-2-ND (https://www.digikey.no/product-detail/en/cypress-semiconductor-corp/MB39C811QN-G-EFE2/1534-1029-2-ND/4969428) | 1.9µA | 2.6 V ~ 18 V |  | Name | DigiKey part nuber | Name | DigiKey part nuber
MB39C811 | 1534-1011-6-ND (https://www.digikey.no/product-detail/en/cypress-semiconductor-corp/MB39C811QN-G-ERE2/1534-1011-6-ND/4931416) | 1.9µA | 2.6 V ~ 18 V |  | MP20043 | MP20043DGT-B-LF-Z-ND (https://www.digikey.no/product-detail/en/monolithic-power-systems-inc/MP20043DGT-B-LF-Z/MP20043DGT-B-LF-Z-ND/5291816) | AFIG-0007 | CH721-ND (https://www.digikey.no/product-detail/en/zf-electronics/AFIG-0007/CH721-ND/5250515) | Elektro mekanical button
MB39C811 | 1534-1011-1-ND (https://www.digikey.no/product-detail/en/cypress-semiconductor-corp/MB39C811QN-G-ERE2/1534-1011-1-ND/4931415) | 1.9µA | 2.6 V ~ 18 V |  | RT9032 | RT9032BGQW-ND (https://www.digikey.no/product-detail/en/richtek-usa-inc/RT9032BGQW/RT9032BGQW-ND/2546498)
MB39C811 | 1534-1011-2-ND (https://www.digikey.no/product-detail/en/cypress-semiconductor-corp/MB39C811QN-G-ERE2/1534-1011-2-ND/4931414) | 1.9µA | 2.6 V ~ 18 V
LTC3331 | LTC3331IUH#TRPBF-ND (https://www.digikey.no/product-detail/en/linear-technology-analog-devices/LTC3331IUH-TRPBF/LTC3331IUH-TRPBF-ND/4895644) | 950nA | 1.8 V ~ 5.5 V, 3 V ~ 19 V
LTC3331 | LTC3331EUH#TRPBF-ND (https://www.digikey.no/product-detail/en/linear-technology-analog-devices/LTC3331EUH-TRPBF/LTC3331EUH-TRPBF-ND/4895643) | 950nA | 1.8 V ~ 5.5 V, 3 V ~ 19 V
LTC3331 | LTC3331IUH#PBF-ND (https://www.digikey.no/product-detail/en/linear-technology-analog-devices/LTC3331IUH-PBF/LTC3331IUH-PBF-ND/4895695) | 950nA | 1.8 V ~ 5.5 V, 3 V ~ 19 V |  |  | Schottky Diodes
LTC3331 | LTC3331EUH#PBF-ND (https://www.digikey.no/product-detail/en/linear-technology-analog-devices/LTC3331EUH-PBF/LTC3331EUH-PBF-ND/4895694) | 950nA | 1.8 V ~ 5.5 V, 3 V ~ 19 V |  | Name | DigiKey Part Number
 |  |  |  |  | DB3X209 | DB3X209K0LCT-ND
