simenrostad/Bachelor-Nordic_Semi/Misc/Measurements and calculations/Distance and redundancy/Redundancy in bus/redundancy in bus initial.xlsx

 |  | 5 advertising events, 15 packages in total. | underestimated
 |  | realyer placed in the middle
 |  | Central in front
1 through 10 | Middle |  | Central | Central and relayer
11 through 40 | Back |  | central from button | from button | from relayer
 |  | 1 | x
 |  | 2 | x
 |  | 3 | x
 |  | 4 | x
 |  | 5 | x
 |  | 6 | x
 |  | 7 | x
 |  | 8 | x
 |  | 9 | x
 |  | 10 | x
 |  | 11 | x | x | x
 |  | 12 | x | x | x
 |  | 13 | x | x | x
 |  | 14 | x | 0 | 0
 |  | 15 | x | 0 | x
 |  | 16 | x | 0 | 0
 |  | 17 | x | x | x
 |  | 18 | x | x | x
 |  | 19 | x | x | x
 |  | 20 | x | x | x
 |  | 21 | x | 0 | 0
 |  | 22 | x | 0 | 0
 |  | 23 | x | x | x
 |  | 24 | x | x | x
 |  | 25 | x | x | x
 |  | 26 | x | x | x
 |  | 27 | x | x | x
 |  | 28 | x | 0 | 0
 |  | 29 | x | x | x
 |  | 30 | x | x | x
 |  | 31 | x | 0 | x
 |  | 32 | x | 0 | x
 |  | 33 | x | 0 | 0
 |  | 34 | x | 0 | 0
 |  | 35 | x | x | x
 |  | 36 | x | x | x
 |  | 37 | x | x | x
 |  | 38 | x | x | x
 |  | 39 | x | 0 | 0
 |  | 40 | x | x | x
 |  |  | 40/40 | 22/30
