simenrostad/Bachelor-Nordic_Semi/Hardware/simulations/cuircuit components measurments/LTC krets/LTC_krets_jlcPCB/LTC_jlc_motstand/to trykk/ep_knapinn_tid.txt

00000000	-136.804E-03
0.002496	-36.301E-03
0.004992	-51.377E-03
0.007488	-71.477E-03
0.009984	-56.402E-03
0.012480	-71.477E-03
0.014976	+3.900E-03
0.017472	-71.477E-03
0.019968	-56.402E-03
0.022464	-76.502E-03
0.024960	+44.101E-03
0.027456	-71.477E-03
0.029952	+3.900E-03
0.032448	+3.900E-03
0.034944	-16.201E-03
0.037440	+3.900E-03
0.039936	-36.301E-03
0.042432	+3.900E-03
0.044928	+3.900E-03
0.047424	+3.900E-03
0.049920	-76.502E-03
0.052416	-36.301E-03
0.054912	+64.201E-03
0.057408	-71.477E-03
0.059904	-76.502E-03
0.062400	+3.900E-03
0.064896	-51.377E-03
0.067392	+3.900E-03
0.069888	-56.402E-03
0.072384	-36.301E-03
0.074880	+3.900E-03
0.077376	+84.302E-03
0.079872	-76.502E-03
0.082368	-31.276E-03
0.084864	-51.377E-03
0.087360	+84.302E-03
0.089856	-11.176E-03
0.092352	-76.502E-03
0.094848	+3.900E-03
0.097344	-76.502E-03
0.099840	-11.176E-03
0.102336	-76.502E-03
0.104832	-51.377E-03
0.107328	+84.302E-03
0.109824	-56.402E-03
0.112320	-31.276E-03
0.114816	-51.377E-03
0.117312	+8.925E-03
0.119808	+24.000E-03
0.122304	-36.301E-03
0.124800	-76.502E-03
0.127296	+3.900E-03
0.129792	-56.402E-03
0.132288	+44.101E-03
0.134784	-16.201E-03
0.137280	-76.502E-03
0.139776	+49.126E-03
0.142272	-76.502E-03
0.144768	-111.678E-03
0.147264	-76.502E-03
0.149760	+24.000E-03
0.152256	-36.301E-03
0.154752	-76.502E-03
0.157248	+3.900E-03
0.159744	-11.176E-03
0.162240	-31.276E-03
0.164736	-51.377E-03
0.167232	+3.900E-03
0.169728	-56.402E-03
0.172224	-156.904E-03
0.174720	-16.201E-03
0.177216	+3.900E-03
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
4.947072	-96.603E-03
4.949568	-71.477E-03
4.952064	-76.502E-03
4.954560	+49.126E-03
4.957056	-51.377E-03
4.959552	+3.900E-03
4.962048	+24.000E-03
4.964544	-76.502E-03
4.967040	-76.502E-03
4.969536	-71.477E-03
4.972032	-11.176E-03
4.974528	-31.276E-03
4.977024	+29.025E-03
4.979520	+3.900E-03
