simenrostad/Bachelor-Nordic_Semi/Hardware/Altium/Handle og komponent liste til pcb.xlsx

Antenne delerer
LTC krest deler
VD konponenter
Handleliste |  | Komponent | antall | format\footprint | Digekeay link
 |  | LTC-3588 | 10
 |  | AFIG-0007 | 4
 |  | RF antenne | 10 |  | https://www.digikey.no/product-detail/en/johanson-technology-inc/2450AT18B100E/712-1006-1-ND/1560835
 |  |  |  |  |  |  |  |  | Antall komponeter for ferdig VD EHSB (ikke ferdig)
 |  | 1x4 header pins Male | 20 |  |  |  |  |  | hva |  | antall | footprint
 |  | 1x4 header pins Female | 20 |  |  |  |  | chek | Condis | 100nF | 3 | 0402. | C4,C5 og C8 | https://www.digikey.com/product-detail/en/taiyo-yuden/TMK105BJ104KV-F/587-1456-1-ND/1004087
 |  |  |  |  |  |  |  | chek |  | 56uF | 1 | 0603. | C15 | https://www.digikey.com/product-detail/en/tdk-corporation/C3225X5R0J686M200AC/445-3954-1-ND/1944451
 |  | spole 2,7nH | 10 |  | https://www.digikey.no/product-detail/en/johanson-technology-inc/L-07C2N7SV6T/712-1415-1-ND/1840093 |  |  | chek |  | 4.7uF | 1 | 0603. | C9 | https://www.digikey.com/product-detail/en/samsung-electro-mechanics/CL10A475KL8NRNC/1276-6794-1-ND/5961653
 |  | spole 3,3nH | 10 |  | https://www.digikey.no/product-detail/en/johanson-technology-inc/L-07C3N3SV6T/712-1416-1-ND/1840094 |  |  | chek |  | 1uF | 1 | 0603. | C10 | https://www.digikey.com/product-detail/en/taiyo-yuden/UMK107ABJ105MAHT/587-4958-1-ND/6563801
 |  | spole 10 uH | 20 | 0603 |  |  |  | chek |  | 100pF | 1 | 0402. | C7 | https://www.digikey.com/product-detail/en/tdk-corporation/CGA2B2C0G2A101J050BA/445-15510-1-ND/4278683
 |  | spole 22 uH | 20 | 0603 |  |  |  | chek |  | 12pF | 6 | 0402. | C1,C2 og C11,C12,C13,C14 | https://www.digikey.com/product-detail/en/murata-electronics-north-america/GRM1555C2A120JA01D/490-7300-1-ND/4213221
 |  | spole 100 uH | 20 | 0603 |  |  |  | chek |  | 0.8pF | 1 | 0402. | C3 | https://www.digikey.com/product-detail/en/murata-electronics-north-america/GRM1555C2AR80BA01D/490-7277-1-ND/4213346
 |  |  |  |  |  |  |  | chek |  | 10uF | 3 | 0603. | C18 | https://www.digikey.com/scripts/DkSearch/dksus.dll?Detail&itemSeq=260184054&uq=636613683072925453
 |  | kondis Keramisk 1,2PF | 10 |  | https://www.digikey.no/product-detail/en/johanson-technology-inc/500R07S1R2BV4T/712-1268-1-ND/1786730 |  |  | chek |  | 220uF | 1 | 1210. |  | https://www.digikey.com/product-detail/en/taiyo-yuden/JMK325ABJ227MM-P/587-5448-1-ND/7067124
 |  | kondis 47uF | 5 | 0603 | https://www.digikey.com/product-detail/en/murata-electronics-north-america/GRM188R60J476ME15D/490-13247-1-ND/5877455 |  |  | chek |  | 1pF | 1 | 0402. | C20 | https://www.digikey.com/product-detail/en/murata-electronics-north-america/GRM1555C2A1R0CA01D/490-7279-1-ND/4213359
 |  | kondis 56uF | 5 | 0603 |  |  |  | chek | Spolet | 3.9nH | 2 | 0402. |  | https://www.digikey.com/product-detail/en/wurth-electronics-inc/744765039A/732-1711-1-ND/1994291
 |  | kondis 220uF | 5 | 0603 |  |  |  | chek |  | 10uH | 1 | 0603. |  | https://www.digikey.com/product-detail/en/tdk-corporation/GLFR1608T100M-LR/445-3608-1-ND/1856576
 |  |  |  |  |  |  |  | chek |  | 15nH | 1 | 0402. |  | https://www.digikey.com/product-detail/en/murata-electronics-north-america/LQG15WZ15NJ02D/490-15252-1-ND/6799917
 |  |  |  |  |  |  |  |  |  |  |  | 0603. |  | https://www.digikey.com/products/en/inductors-coils-chokes/fixed-inductors/71?k=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
 |  |  |  |  |  |  |  | chek |  | 2.7nH | 1 | 0402. |  | https://www.digikey.com/product-detail/en/murata-electronics-north-america/LQG15HS2N7S02D/490-2615-1-ND/662895
 |  |  |  |  |  |  |  | chek | Pinnheders | MH1x4 | 2 |  |  | https://www.digikey.com/product-detail/en/samtec-inc/TMS-104-01-L-S/SAM10243-ND/6678980
 |  |  |  |  |  |  |  | chek | Ehgen | AFIG0007 | 1
 |  |  |  |  |  |  |  |  | SOC | nRF52 | 1
 |  |  |  |  |  |  |  | chek | antenne |  | 1
 |  |  |  |  |  |  |  |  | diode |  | 2
 |  |  |  |  |  |  |  |  |  | summ | 31
 |  |  |  |  |  |  |  |  | Antall komponeter for ferdig LTC EHSB
 | krets _LTC pcb | capasitans | footprint |  |  | krets _VD
 |  |  |  |  |  |  |  |  | hva |  | antall | footprint | komponent nr
 | C1 | 12pF | 0402 | https://www.digikey.com/product-detail/en/murata-electronics-north-america/GRM1555C1H120GA01D/490-6197-1-ND/3845394 |  | C1 | s | chek | Condis | 100nF | 3 | 0402. | C4,C5 og C8 | https://www.digikey.com/product-detail/en/taiyo-yuden/TMK105BJ104KV-F/587-1456-1-ND/1004087
 | C2 | 12pF | 0402 | https://www.digikey.com/product-detail/en/murata-electronics-north-america/GRM1555C1H120GA01D/490-6197-1-ND/3845394 |  | C2 | s | chek |  | 47uF | 1 | 0603. | C15 | https://www.digikey.com/product-detail/en/samsung-electro-mechanics/CL10A476MQENRBE/1276-6823-1-ND/5961682
 | C3 | 0.8pF | 0402 | https://www.digikey.com/product-detail/en/american-technical-ceramics/600L0R8AT200T/1284-1093-1-ND/3905457 |  | C3 | s | chek |  | 4.7uF | 2 | 0603. | C9 og C16 | https://www.digikey.com/product-detail/en/samsung-electro-mechanics/CL10A475KL8NRNC/1276-6794-1-ND/5961653
 | C4 | 100nF | 0402 | https://www.digikey.com/product-detail/en/murata-electronics-north-america/GCM155R71C104KA55D/490-4759-1-ND/1641678 |  | C4 | s | chek |  | 1uF | 2 | 0603. | C10 og C17 | https://www.digikey.com/product-detail/en/taiyo-yuden/UMK107ABJ105MAHT/587-4958-1-ND/6563801
 | C5 | 100nF | 0402 | https://www.digikey.com/product-detail/en/murata-electronics-north-america/GCM155R71C104KA55D/490-4759-1-ND/1641678 |  | C5 | s | chek |  | 100pF | 1 | 0402. | C7 | https://www.digikey.com/product-detail/en/tdk-corporation/CGA2B2C0G2A101J050BA/445-15510-1-ND/4278683
 | C6 | nc | 0402 |  |  | C6 | s | chek |  | 12pF | 6 | 0402. | C1,C2 og C11,C12,C13,C14 | https://www.digikey.com/product-detail/en/murata-electronics-north-america/GRM1555C2A120JA01D/490-7300-1-ND/4213221
 | C7 | 100pF | 0402 | https://www.digikey.com/product-detail/en/kemet/CBR04C101F3GAC/399-11246-1-ND/4376873 |  | C7 | s | chek |  | 0.8pF | 1 | 0402. | C3 | https://www.digikey.com/product-detail/en/murata-electronics-north-america/GRM1555C2AR80BA01D/490-7277-1-ND/4213346
 | C8 | 100nF | 0402 | https://www.digikey.com/product-detail/en/murata-electronics-north-america/GCM155R71C104KA55D/490-4759-1-ND/1641678 |  | C8 | s | chek |  | 22uF | 1 | 0603. | C22 | https://www.digikey.com/product-detail/en/samsung-electro-mechanics/CL10A226MO7JZNC/1276-7076-1-ND/7320718
 | C9 | 4.7uF | 0603 | https://www.digikey.com/product-detail/en/murata-electronics-north-america/GRM188R61C475KAAJD/490-10481-1-ND/5026399 |  | C9 | s | chek |  | 220uF | 1 | 1210. | C19 | https://www.digikey.com/product-detail/en/taiyo-yuden/JMK325ABJ227MM-P/587-5448-1-ND/7067124
 | C10 | 1uF | 0603 | https://www.digikey.com/product-detail/en/tdk-corporation/CGA3E1X7R1E105K080AC/445-6931-1-ND/2672949 |  | C10 | s | chek |  | 1pF | 1 | 0402. | C20 | https://www.digikey.com/product-detail/en/murata-electronics-north-america/GRM1555C2A1R0CA01D/490-7279-1-ND/4213359
 | C11 | 12pF | 0402 | https://www.digikey.com/product-detail/en/murata-electronics-north-america/GRM1555C1H120GA01D/490-6197-1-ND/3845394 |  | C11 | s | chek | Spolet | 3.9nH | 2 | 0402. |  | https://www.digikey.com/product-detail/en/wurth-electronics-inc/744765039A/732-1711-1-ND/1994291
 | C12 | 12pF | 0402 | https://www.digikey.com/product-detail/en/murata-electronics-north-america/GRM1555C1H120GA01D/490-6197-1-ND/3845394 |  | C12 | s | chek |  | 10uH | 1 | 0603. |  | https://www.digikey.com/product-detail/en/tdk-corporation/GLFR1608T100M-LR/445-3608-1-ND/1856576
 | C13 | 12pF | 0402 | https://www.digikey.com/product-detail/en/murata-electronics-north-america/GRM1555C1H120GA01D/490-6197-1-ND/3845394 |  | C13 | s | chek |  | 15nH | 1 | 0402. |  | https://www.digikey.com/product-detail/en/murata-electronics-north-america/LQG15WZ15NJ02D/490-15252-1-ND/6799917
 | C14 | 12pF | 0402 | https://www.digikey.com/product-detail/en/murata-electronics-north-america/GRM1555C1H120GA01D/490-6197-1-ND/3845394 |  | C14 | s | chek |  | 100uH | 1 | 0603. |  | https://www.digikey.com/products/en/inductors-coils-chokes/fixed-inductors/71?k=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
VD | C15 | 47uF | 0603 | https://www.digikey.com/product-detail/en/murata-electronics-north-america/GRM188R60J476ME15D/490-13247-1-ND/5877455 |  | C15 | 56uF | chek |  | 2.7nH | 1 | 0402. |  | https://www.digikey.com/product-detail/en/murata-electronics-north-america/LQG15HS2N7S02D/490-2615-1-ND/662895
ltc | C16 | 4.7uF | 0603 | https://www.digikey.com/product-detail/en/murata-electronics-north-america/GRM188R61C475KAAJD/490-10481-1-ND/5026399 |  | C16 | 10uF | chek | Pinnheders | MH1x4 | 2 |  |  | https://www.digikey.com/product-detail/en/samtec-inc/TMS-104-01-L-S/SAM10243-ND/6678980
ltc | C17 | 1uF | 0603 | https://www.digikey.com/product-detail/en/tdk-corporation/CGA3E1X7R1E105K080AC/445-6931-1-ND/2672949 |  | C17 | 10uF | chek | Ehchip | LTC3588 | 1
ltc | C18 | 22uF | 0603 | https://www.digikey.com/product-detail/en/tdk-corporation/C1608JB1A226M080AC/445-11208-1-ND/3952874 |  | C18 | 10uF | chek | Ehgen | AFIG0007 | 1
 |  |  |  |  |  |  |  |  | SOC | nRF52 | 1
VD | C19 | 220uF | 0603 | finner ike i riktig futprint |  | C19 | 220uF | chek | antenne |  | 1 |  |  | https://www.digikey.com/product-detail/en/johanson-technology-inc/2450AT18A100E/712-1005-1-ND/1560834
 |  |  | 1210 | https://www.digikey.com/product-detail/en/samsung-electro-mechanics/CL32A227MQVNNNE/1276-3375-1-ND/3891461 |  |  |  | chek | Diode |  | 2 |  |  | https://www.digikey.com/scripts/DkSearch/dksus.dll?Detail&itemSeq=260159396&uq=636613537731172407
 | C20 | 1pF |  |  |  | C20 | s
 |  |  |  |  |  |  |  |  |  | summ | 33
 | L1 | 3.9nH | 0402 |  |  | L1 | s |  |  | pris | 28,47USD + nrf52 og pcb
 | L2 | 10uH | 0603 |  |  | L2 | s
 | L3 | 15nH | 0402 |  |  | L3 | s
ltc | L4 | 100uH | 0603 |  |  | L4 | 3.9nH
 | L5 | 3.3nH |  |  |  | L5 | 2.7NH
 | L6 | 2.7NH
