simenrostad/Bachelor-Nordic_Semi/Hardware/Components/Afig spole settup.PNG

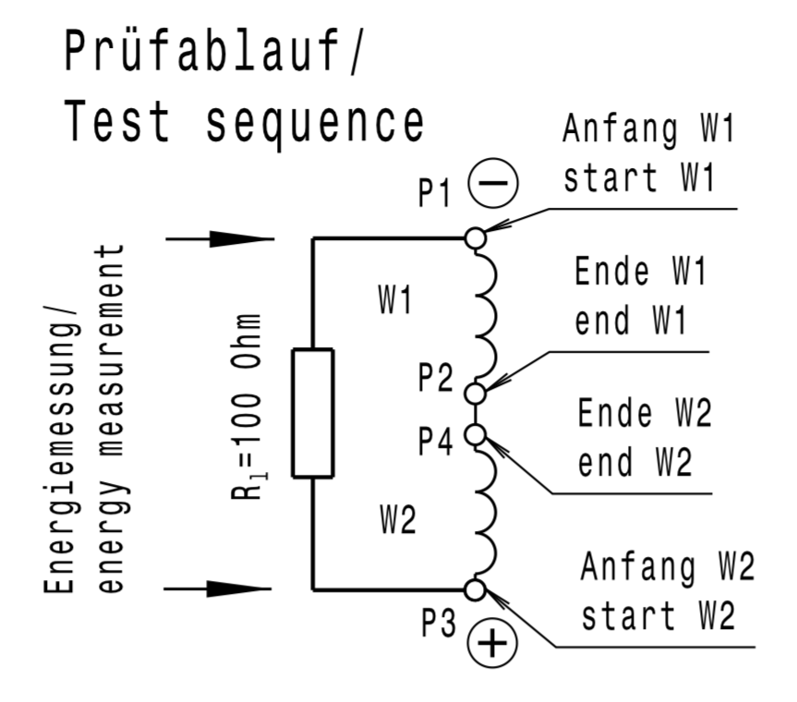
Hardware/Components/Afig spole settup.PNG
