simenrostad/Bachelor-Nordic_Semi/Hardware/Components/Afig spole settup_edit.png

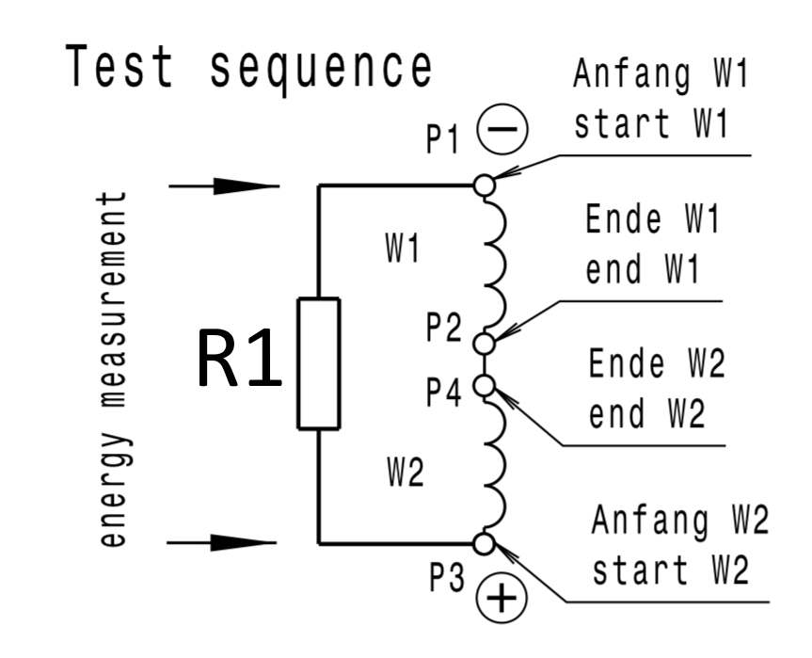
Hardware/Components/Afig spole settup_edit.png
