simenrostad/Bachelor-Nordic_Semi/Hardware/simulations/cuircuit components measurments/Electro Mecanical Generaor/2/genknap_2.png

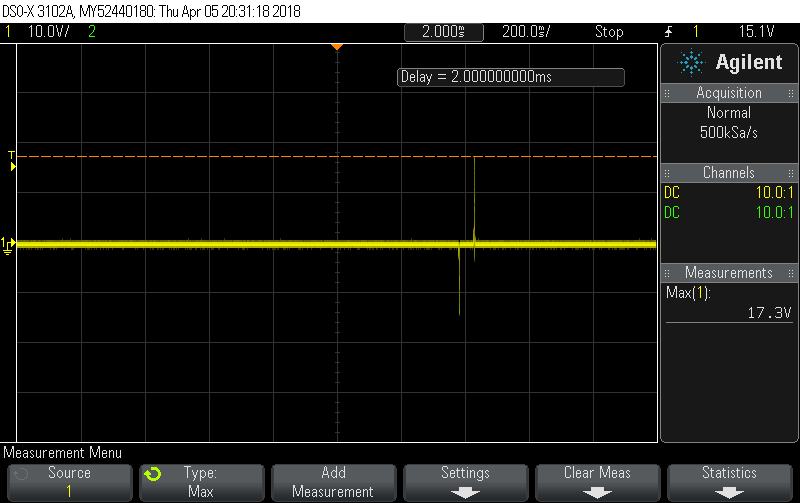
Hardware/simulations/cuircuit components measurments/Electro Mecanical Generaor/2/genknap_2.png
