simenrostad/Bachelor-Nordic_Semi/Hardware/simulations/cuircuit components measurments/Electro Mecanical Generaor/Knapp med 230ohm/gibb_03.png

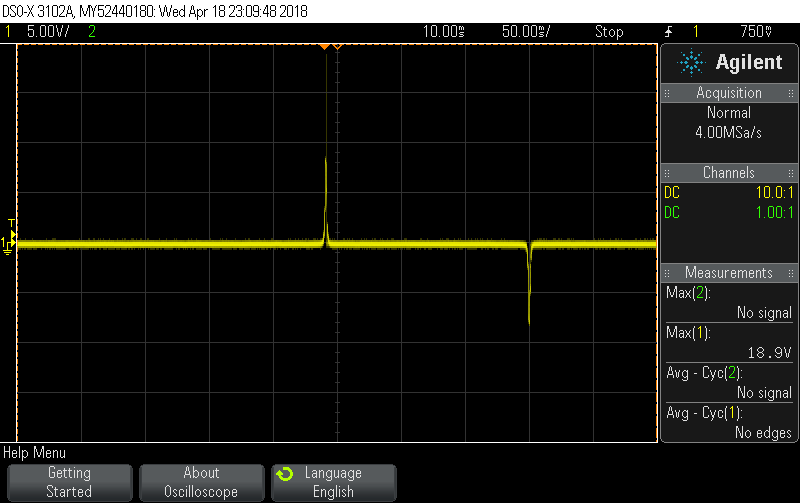
Hardware/simulations/cuircuit components measurments/Electro Mecanical Generaor/Knapp med 230ohm/gibb_03.png
