simenrostad/Bachelor-Nordic_Semi/Hardware/simulations/cuircuit components measurments/Electro Mecanical Generaor/mg.png

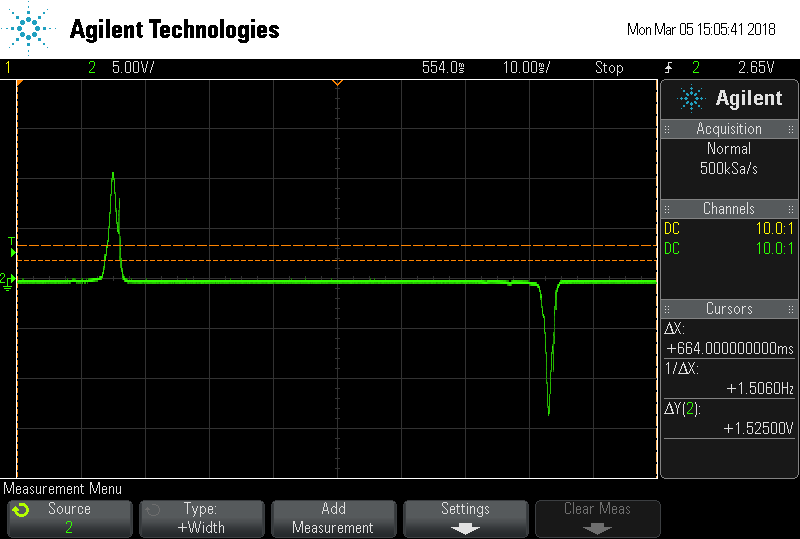
Hardware/simulations/cuircuit components measurments/Electro Mecanical Generaor/mg.png
