simenrostad/Bachelor-Nordic_Semi/Hardware/simulations/cuircuit components measurments/Electro Mecanical Generaor/singel puls/2k6 ohm/001_knp_in.png

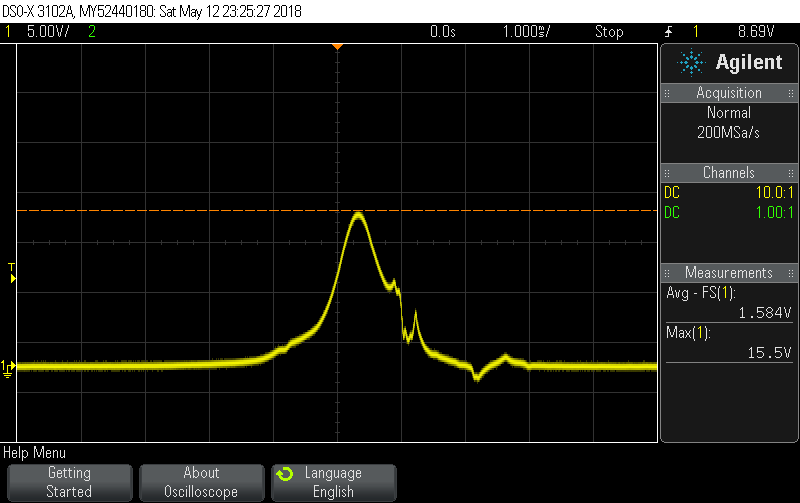
Hardware/simulations/cuircuit components measurments/Electro Mecanical Generaor/singel puls/2k6 ohm/001_knp_in.png
