simenrostad/Bachelor-Nordic_Semi/Hardware/simulations/cuircuit components measurments/Electro Mecanical Generaor/singel puls/2k6 ohm/comperig cuircuits/1v8_samenligning1.png

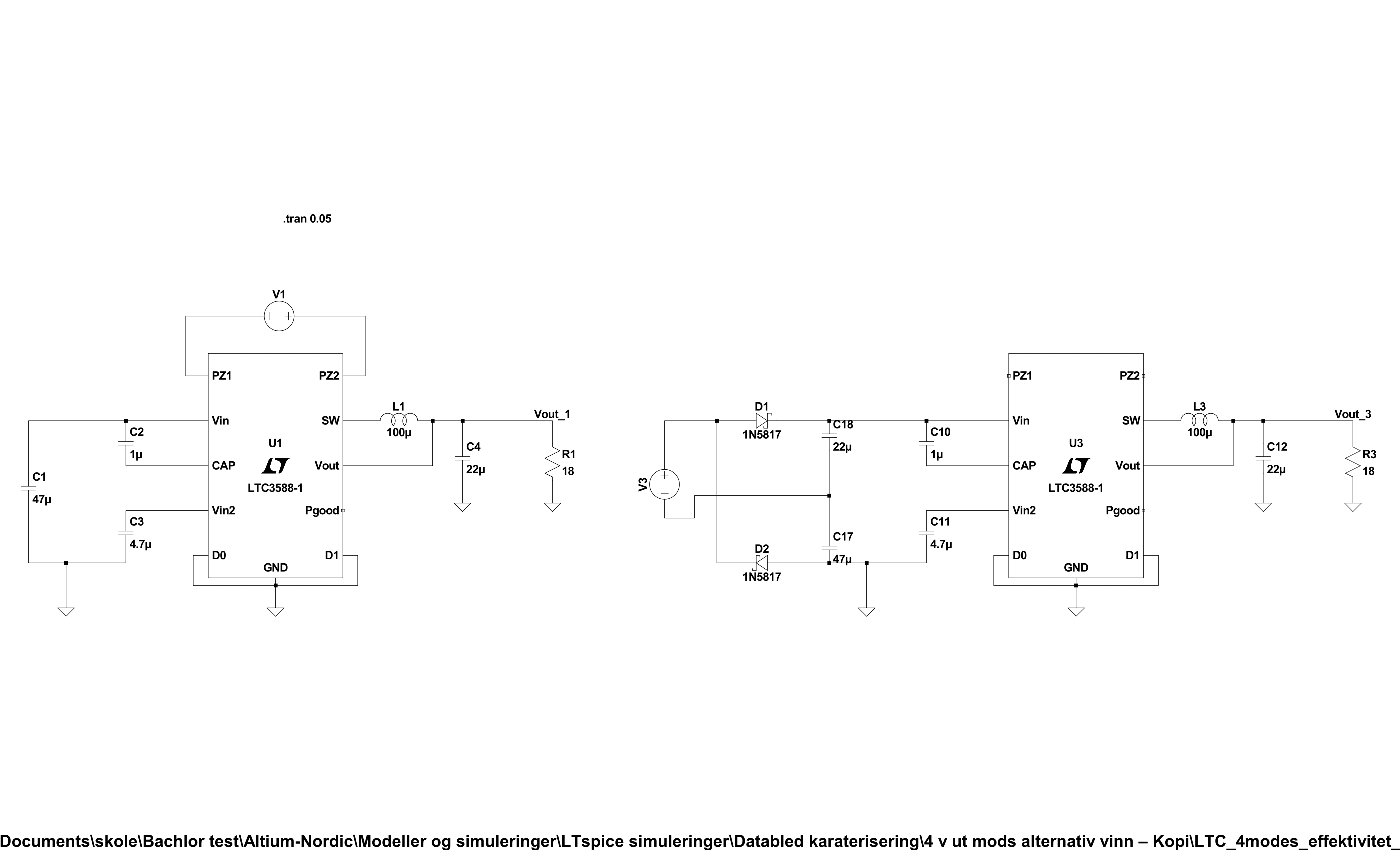
Hardware/simulations/cuircuit components measurments/Electro Mecanical Generaor/singel puls/2k6 ohm/comperig cuircuits/1v8_samenligning1.png
