simenrostad/Bachelor-Nordic_Semi/Hardware/simulations/cuircuit components measurments/Electro Mecanical Generaor/singel puls/2k6 ohm/comperig cuircuits/plot_1v8_samenlingin1.png

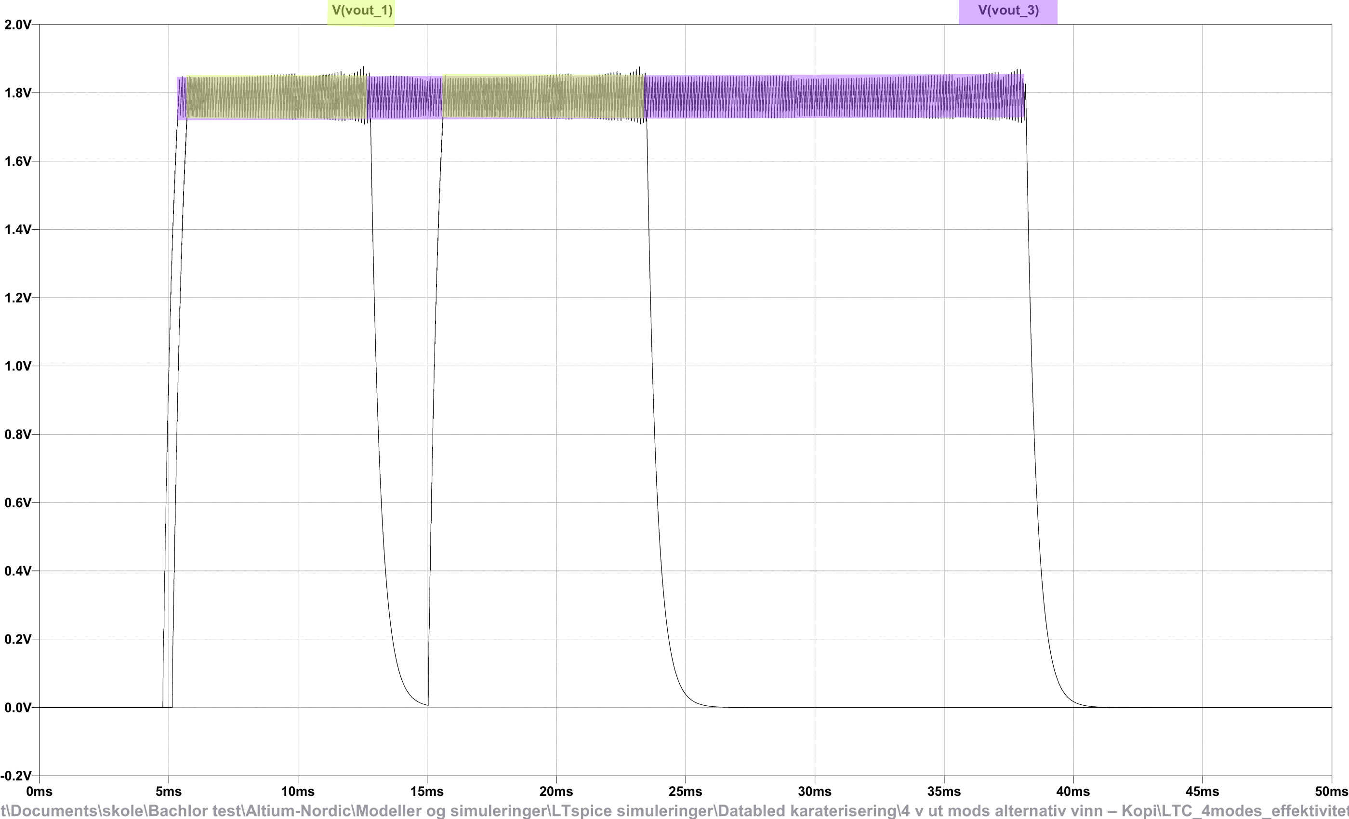
Hardware/simulations/cuircuit components measurments/Electro Mecanical Generaor/singel puls/2k6 ohm/comperig cuircuits/plot_1v8_samenlingin1.png
