simenrostad/Bachelor-Nordic_Semi/Hardware/simulations/cuircuit components measurments/Electro Mecanical Generaor/singel puls/2k6 ohm/Current_LTC_constant _dc_v_out_all-1.png

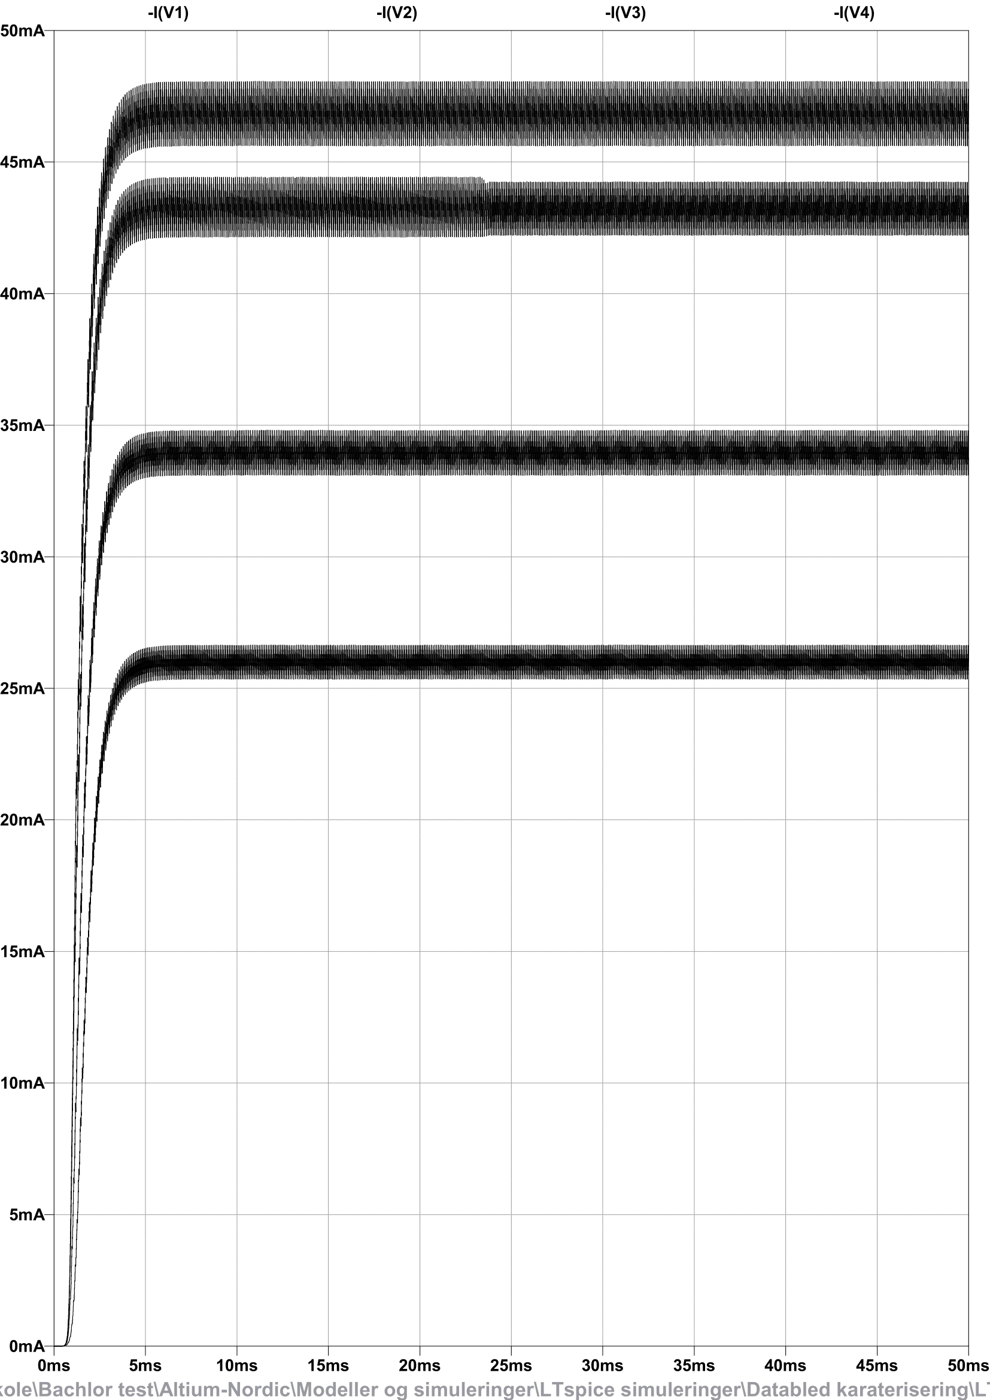
Hardware/simulations/cuircuit components measurments/Electro Mecanical Generaor/singel puls/2k6 ohm/Current_LTC_constant _dc_v_out_all-1.png
