simenrostad/Bachelor-Nordic_Semi/Hardware/simulations/cuircuit components measurments/Electro Mecanical Generaor/singel puls/2k6 ohm/LTC_altsolution_Vinn sim/curcuit_ltc_vinn_alt/curcuit_ltc_vinn_alt-1.png

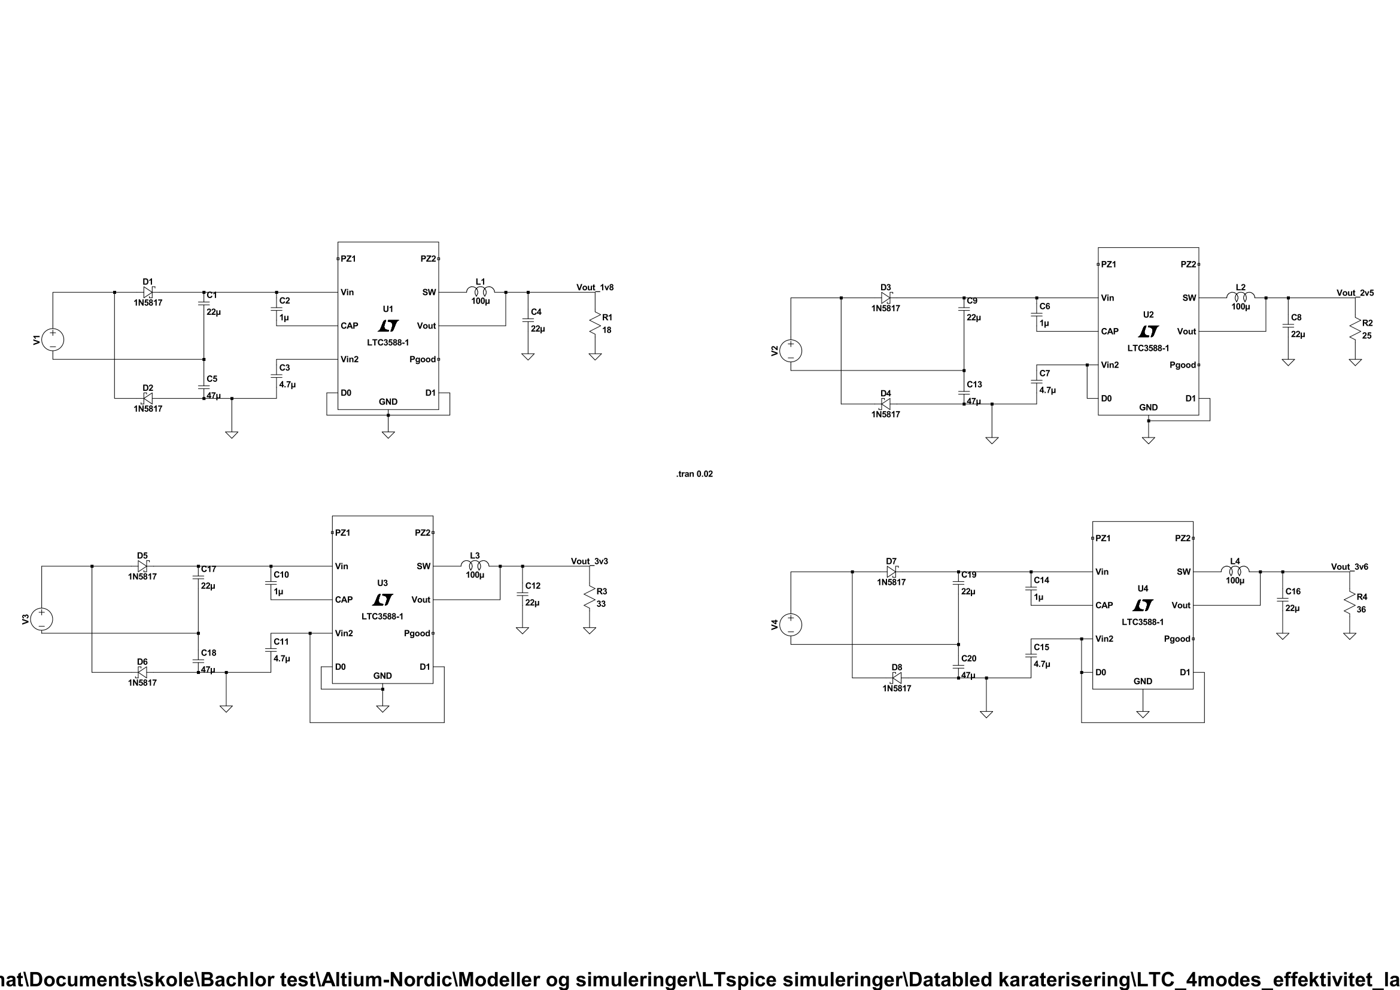
Hardware/simulations/cuircuit components measurments/Electro Mecanical Generaor/singel puls/2k6 ohm/LTC_altsolution_Vinn sim/curcuit_ltc_vinn_alt/curcuit_ltc_vinn_alt-1.png
