simenrostad/Bachelor-Nordic_Semi/Hardware/simulations/cuircuit components measurments/Electro Mecanical Generaor/singel puls/300 ohm/000_knp_in.png

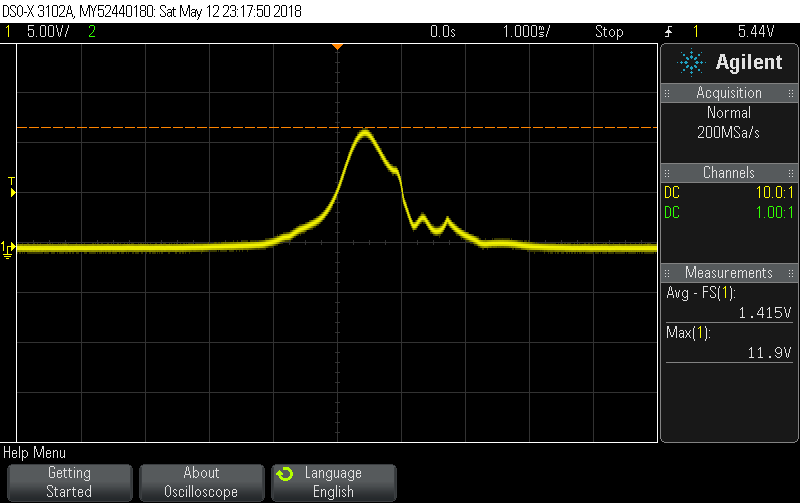
Hardware/simulations/cuircuit components measurments/Electro Mecanical Generaor/singel puls/300 ohm/000_knp_in.png
