simenrostad/Bachelor-Nordic_Semi/Hardware/simulations/cuircuit components measurments/FullWave Bridge Rectifier/1.png

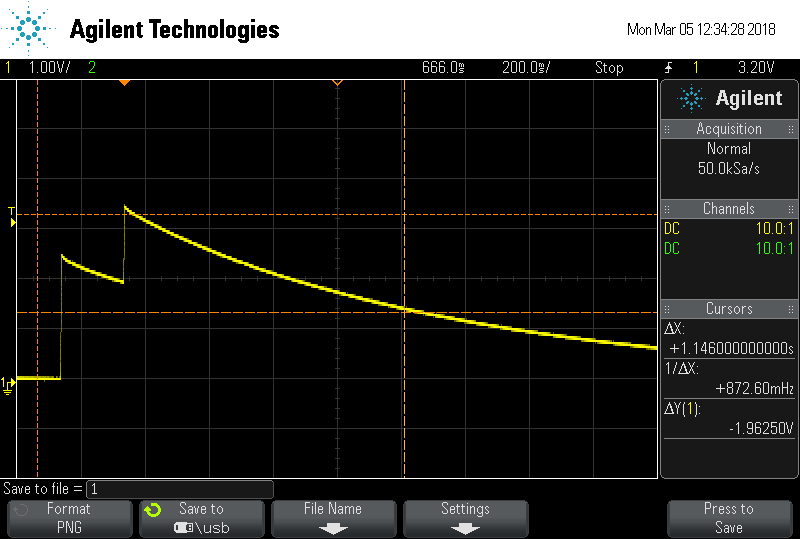
Hardware/simulations/cuircuit components measurments/FullWave Bridge Rectifier/1.png
