simenrostad/Bachelor-Nordic_Semi/Hardware/simulations/cuircuit components measurments/FullWave Bridge Rectifier/Full likeretter driver devkitt/funk_1.png

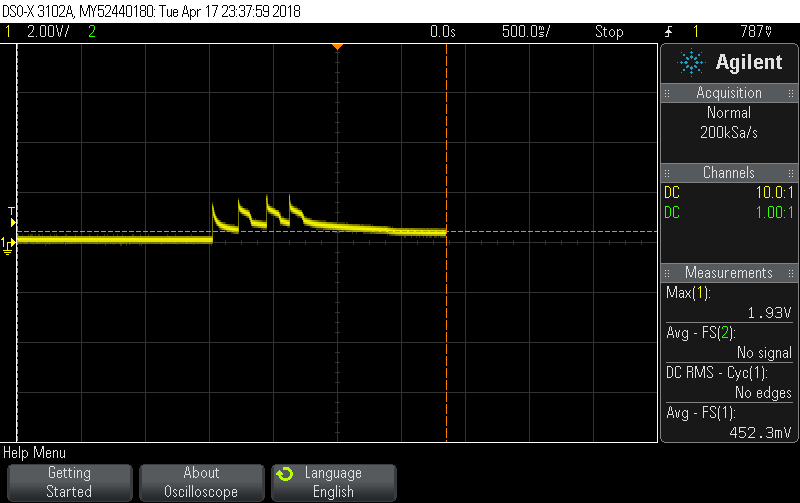
Hardware/simulations/cuircuit components measurments/FullWave Bridge Rectifier/Full likeretter driver devkitt/funk_1.png
