simenrostad/Bachelor-Nordic_Semi/Hardware/simulations/cuircuit components measurments/FullWave Bridge Rectifier/Full likeretter driver devkitt/funk_2.png

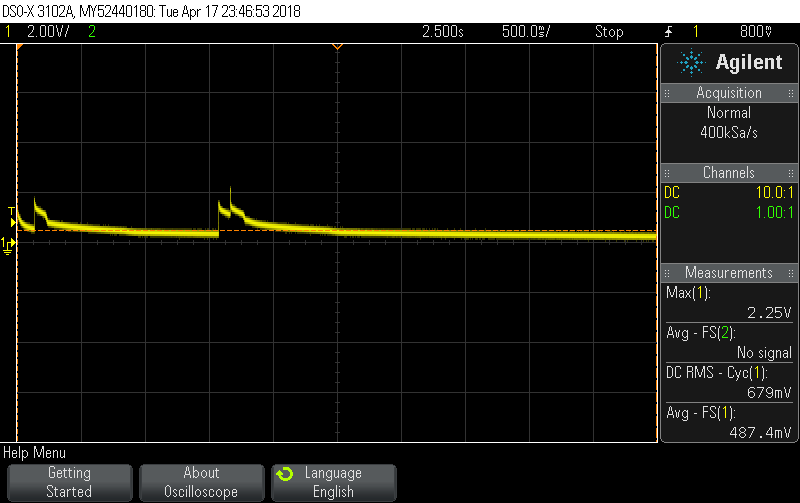
Hardware/simulations/cuircuit components measurments/FullWave Bridge Rectifier/Full likeretter driver devkitt/funk_2.png
