simenrostad/Bachelor-Nordic_Semi/Hardware/simulations/cuircuit components measurments/FullWave Bridge Rectifier/fwrb1.png

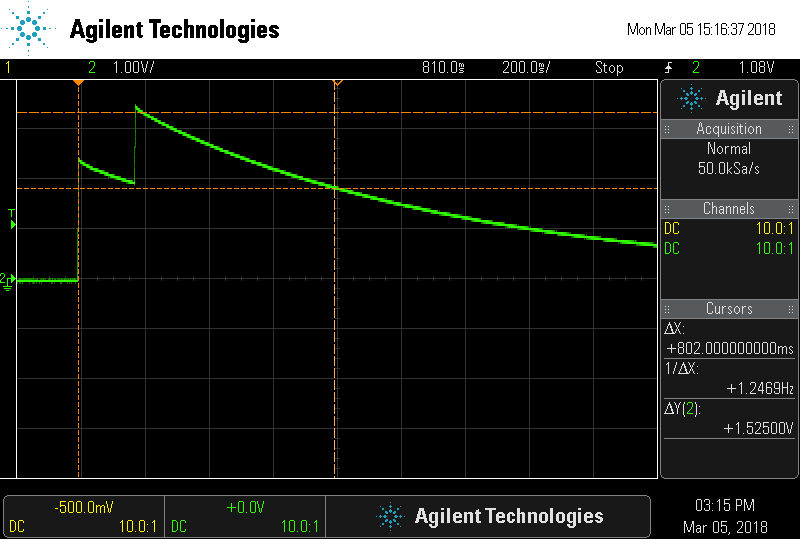
Hardware/simulations/cuircuit components measurments/FullWave Bridge Rectifier/fwrb1.png
