simenrostad/Bachelor-Nordic_Semi/Hardware/simulations/cuircuit components measurments/FullWave Voltage dobler/2.png

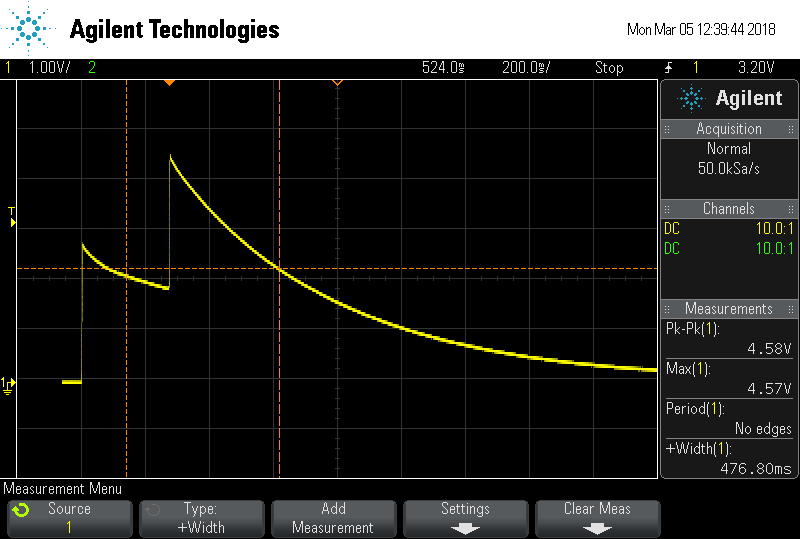
Hardware/simulations/cuircuit components measurments/FullWave Voltage dobler/2.png
