simenrostad/Bachelor-Nordic_Semi/Hardware/simulations/cuircuit components measurments/FullWave Voltage dobler/fwvd.png

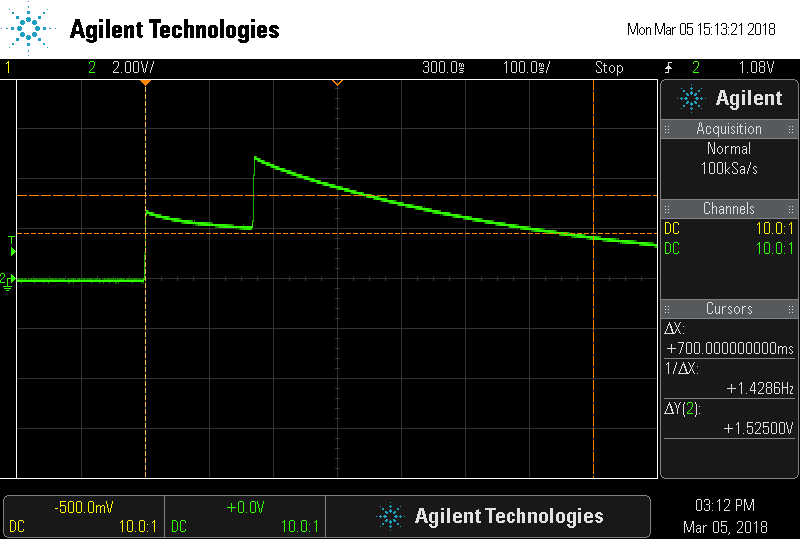
Hardware/simulations/cuircuit components measurments/FullWave Voltage dobler/fwvd.png
