simenrostad/Bachelor-Nordic_Semi/Hardware/simulations/cuircuit components measurments/Funk/funk_4.png

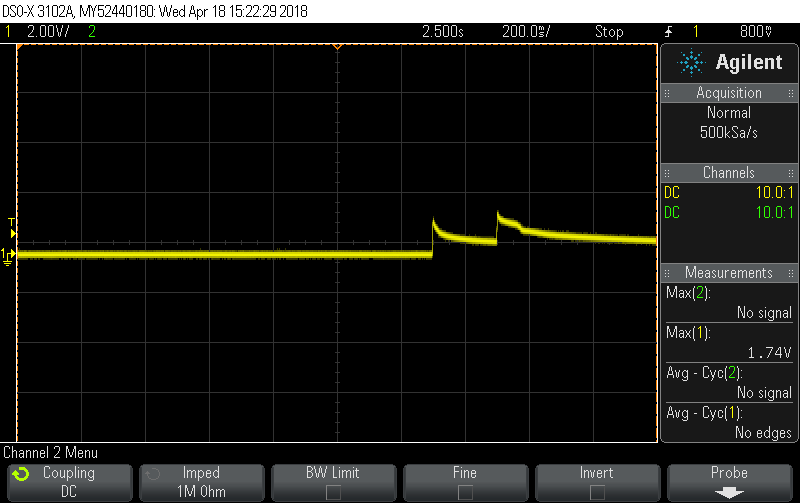
Hardware/simulations/cuircuit components measurments/Funk/funk_4.png
