simenrostad/Bachelor-Nordic_Semi/Hardware/simulations/cuircuit components measurments/HalfWave Voltae dobler/hwvd1.png

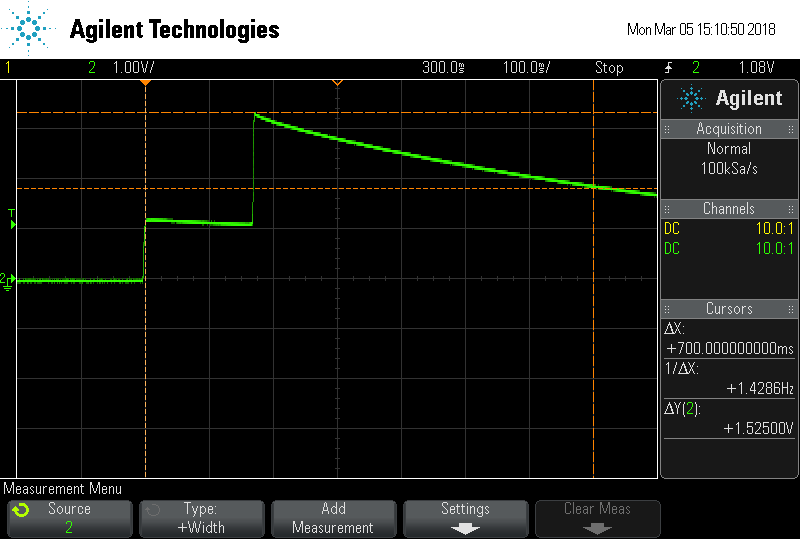
Hardware/simulations/cuircuit components measurments/HalfWave Voltae dobler/hwvd1.png
