simenrostad/Bachelor-Nordic_Semi/Hardware/simulations/cuircuit components measurments/HalfWave Voltae dobler/scope_8.png

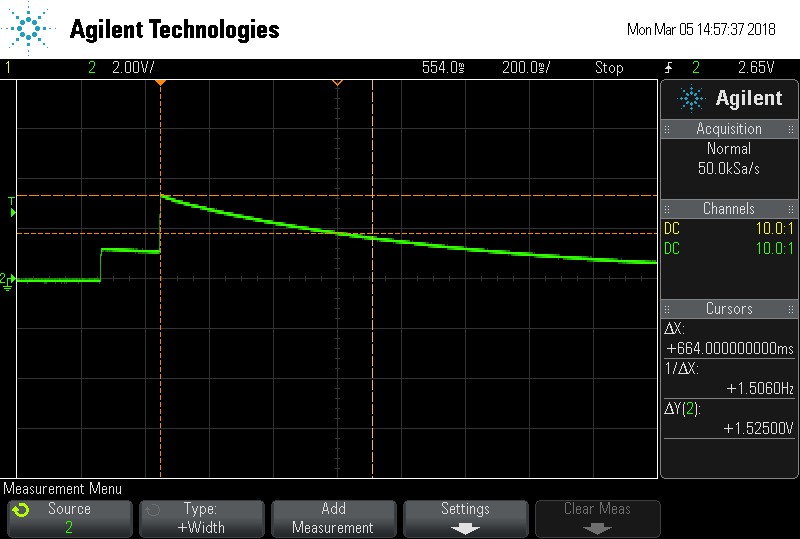
Hardware/simulations/cuircuit components measurments/HalfWave Voltae dobler/scope_8.png
