simenrostad/Bachelor-Nordic_Semi/Hardware/simulations/cuircuit components measurments/LTC krets/ltc_a1.png

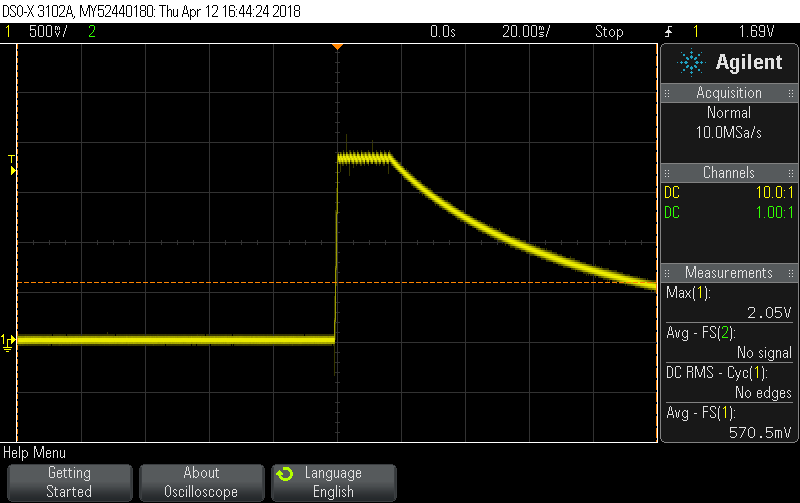
Hardware/simulations/cuircuit components measurments/LTC krets/ltc_a1.png
