simenrostad/Bachelor-Nordic_Semi/Hardware/simulations/cuircuit components measurments/LTC krets/LTC_knap_devkit/ltc___9d.png

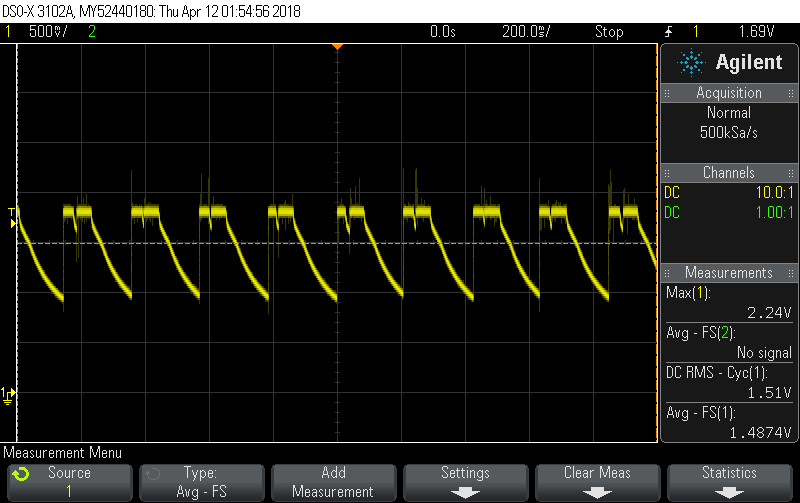
Hardware/simulations/cuircuit components measurments/LTC krets/LTC_knap_devkit/ltc___9d.png
