simenrostad/Bachelor-Nordic_Semi/Hardware/simulations/cuircuit components measurments/LTC krets/LTC_knapp data/LTC_1/ltc___1.png

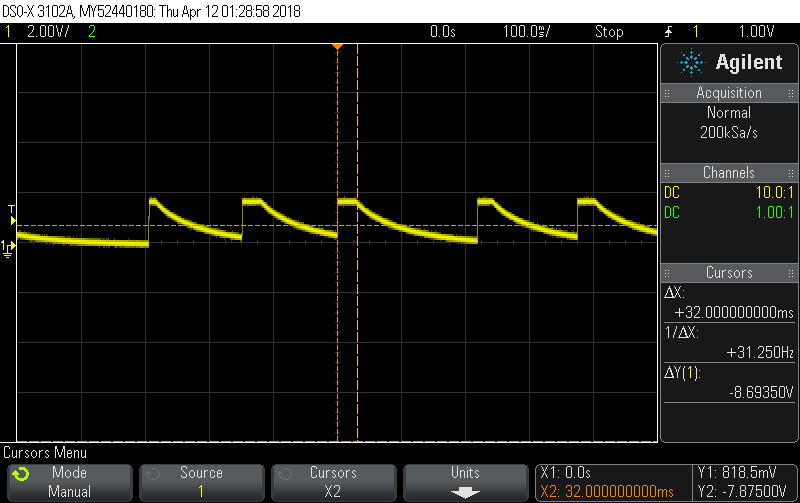
Hardware/simulations/cuircuit components measurments/LTC krets/LTC_knapp data/LTC_1/ltc___1.png
