simenrostad/Bachelor-Nordic_Semi/Hardware/simulations/cuircuit components measurments/LTC krets/LTC_knapp data/LTC_3/ltc___3.png

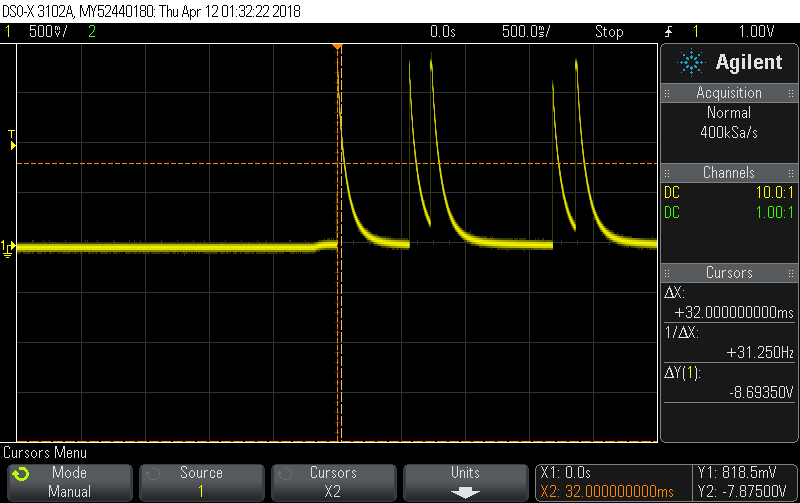
Hardware/simulations/cuircuit components measurments/LTC krets/LTC_knapp data/LTC_3/ltc___3.png
