simenrostad/Bachelor-Nordic_Semi/Hardware/simulations/cuircuit components measurments/LTC krets/LTC_knapp data/LTC_4/ltc___4.png

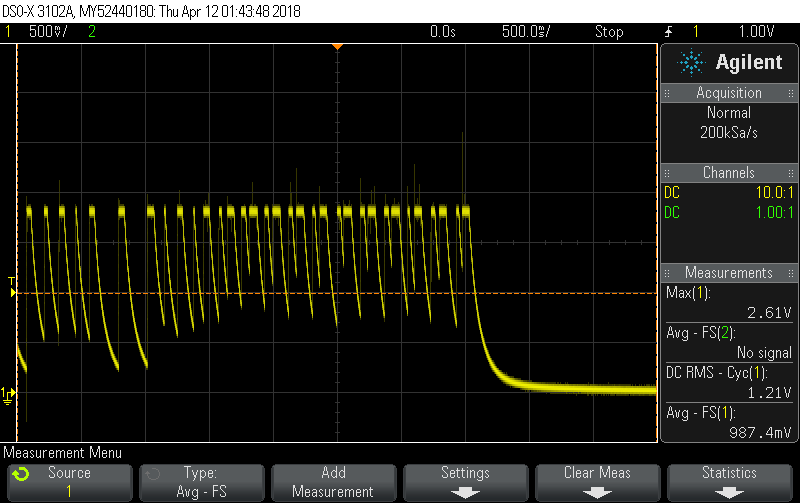
Hardware/simulations/cuircuit components measurments/LTC krets/LTC_knapp data/LTC_4/ltc___4.png
