simenrostad/Bachelor-Nordic_Semi/Hardware/simulations/cuircuit components measurments/LTC krets/LTC_knapp data/LTC_mod_2,5 eller3,6/ltc4pin_3_1k.png

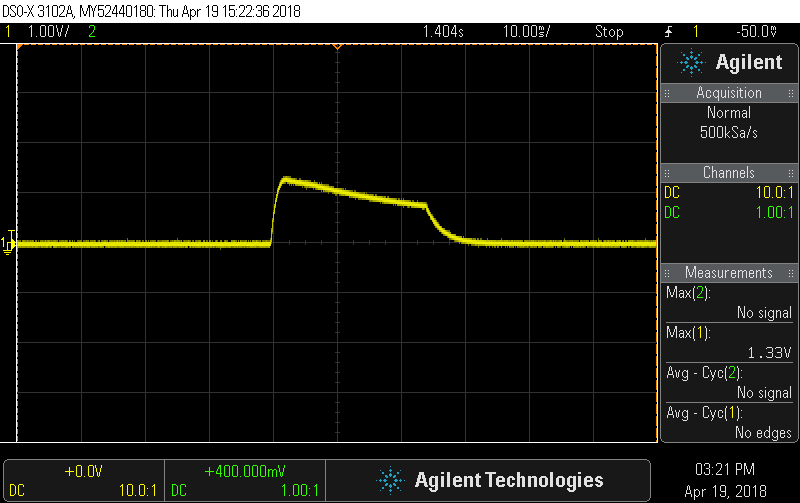
Hardware/simulations/cuircuit components measurments/LTC krets/LTC_knapp data/LTC_mod_2,5 eller3,6/ltc4pin_3_1k.png
