simenrostad/Bachelor-Nordic_Semi/Hardware/simulations/cuircuit components measurments/LTC krets/LTC_krets_jlcPCB/LTC_jlc_devkit/ltc_funk_2.png

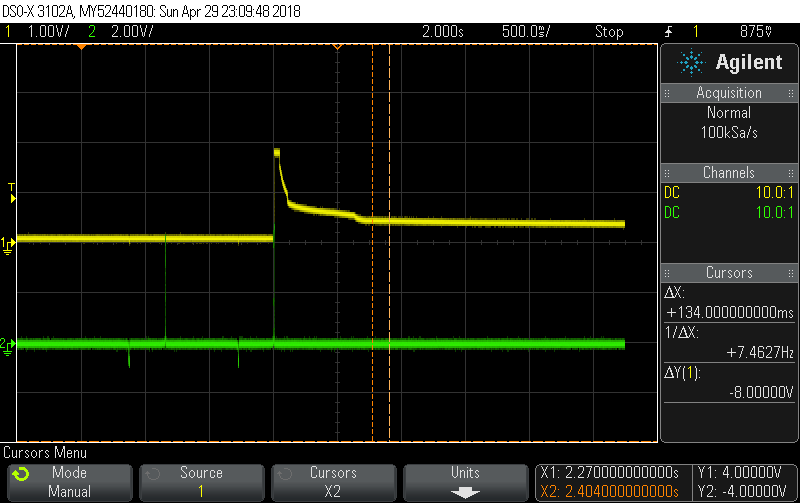
Hardware/simulations/cuircuit components measurments/LTC krets/LTC_krets_jlcPCB/LTC_jlc_devkit/ltc_funk_2.png
