simenrostad/Bachelor-Nordic_Semi/Hardware/simulations/cuircuit components measurments/LTC krets/LTC_krets_jlcPCB/LTC_jlc_motstand/Ett trykk/ltc_funk_1.png

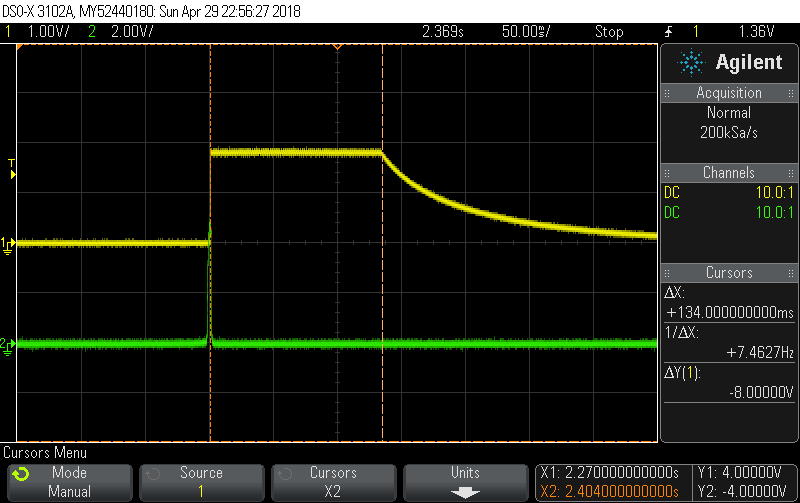
Hardware/simulations/cuircuit components measurments/LTC krets/LTC_krets_jlcPCB/LTC_jlc_motstand/Ett trykk/ltc_funk_1.png
