simenrostad/Bachelor-Nordic_Semi/Hardware/simulations/cuircuit components measurments/LTC krets/LTC_krets_jlcPCB/LTC_jlc_motstand/mange trykk/ltc_funk_1b.png

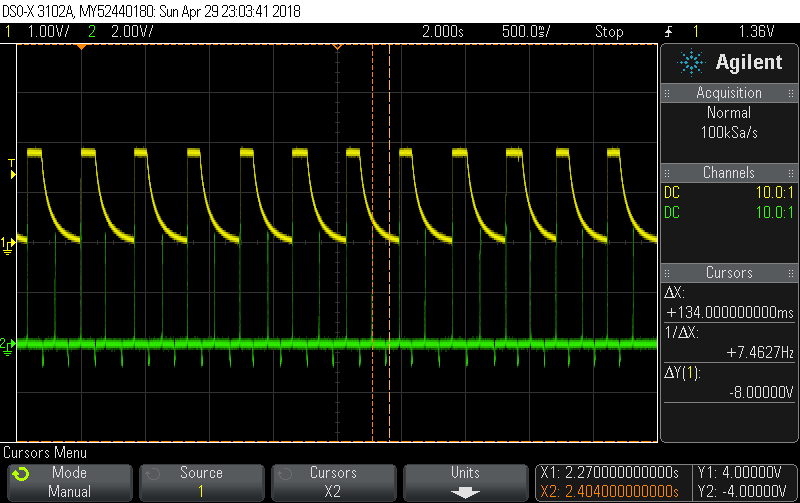
Hardware/simulations/cuircuit components measurments/LTC krets/LTC_krets_jlcPCB/LTC_jlc_motstand/mange trykk/ltc_funk_1b.png
