simenrostad/Bachelor-Nordic_Semi/Hardware/simulations/cuircuit components measurments/Pizo generator/Pizo gen raw/pizo_1z.png

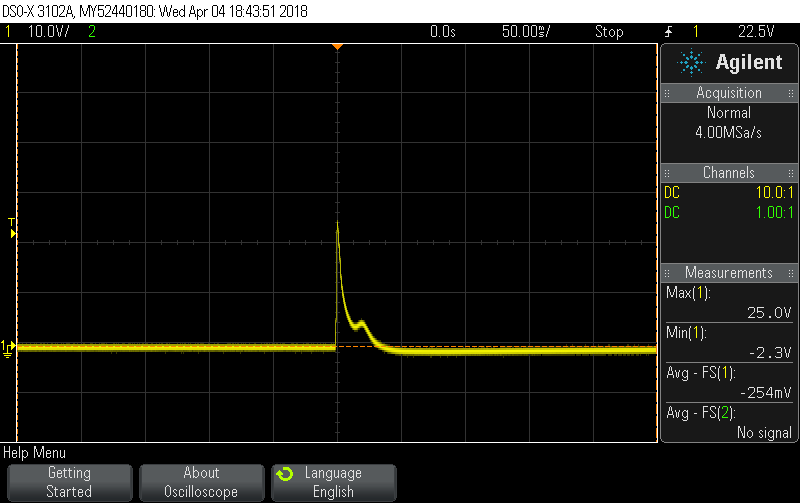
Hardware/simulations/cuircuit components measurments/Pizo generator/Pizo gen raw/pizo_1z.png
