simenrostad/Bachelor-Nordic_Semi/Misc/3D-models/casing central lid farg/casing central lid FARGFUI.obj

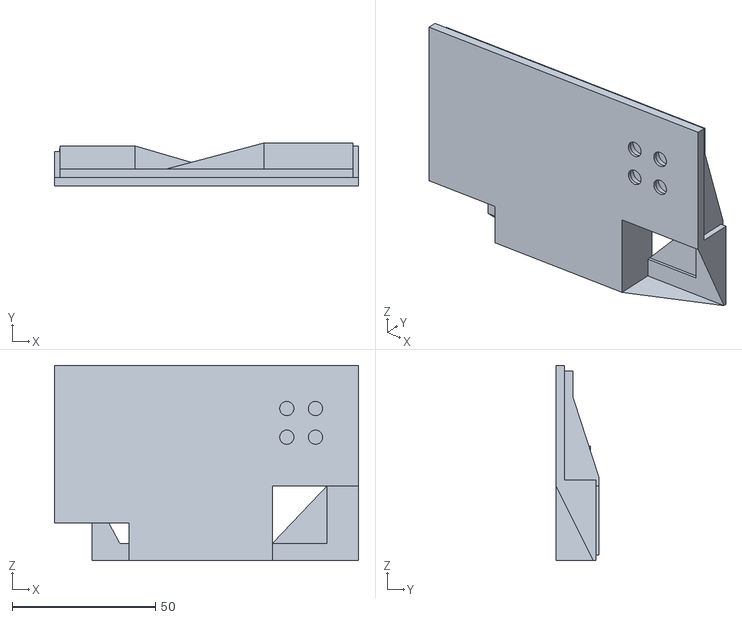
[picture p126: CAD file, 2018-05-28]
Misc/3D-models/casing central lid farg/casing central lid FARGFUI.obj
106.0 x 15.0 x 68.0
