simenrostad/Bachelor-Nordic_Semi/Misc/3D-models/casing relayer lid farge.obj

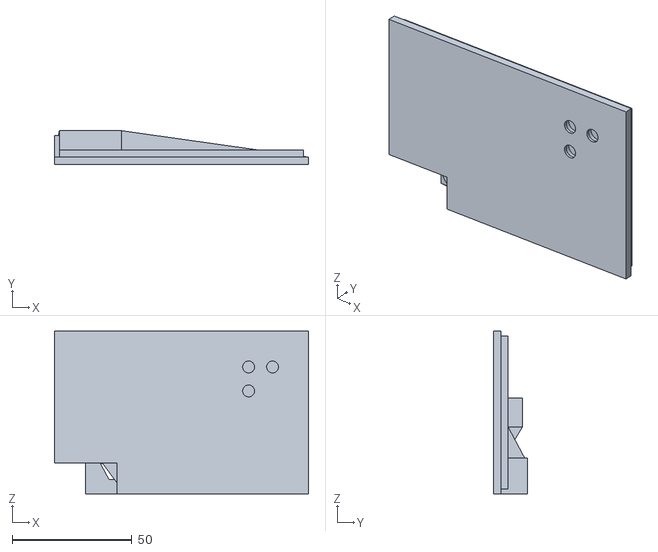
[picture p127: CAD file, 2018-05-28]
Misc/3D-models/casing relayer lid farge.obj
106.0 x 14.0 x 68.0
