simenrostad/Bachelor-Nordic_Semi/Misc/3D-models/casing relayer farg.obj

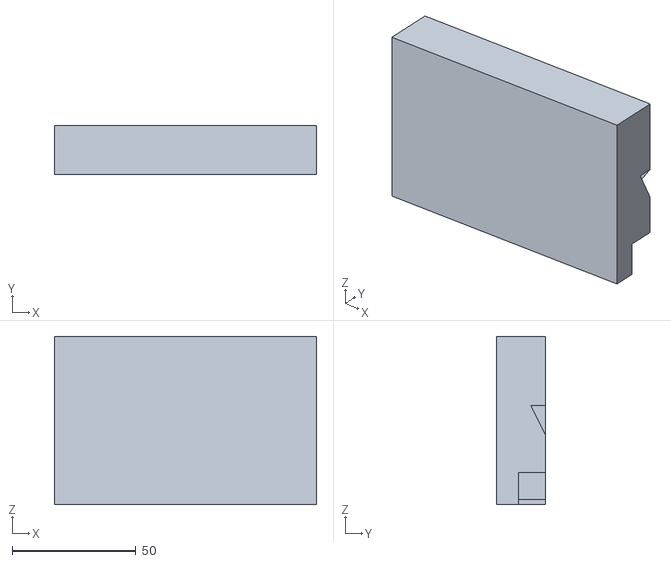
[picture p129: CAD file, 2018-05-28]
Misc/3D-models/casing relayer farg.obj
106.0 x 20.0 x 68.0
