simenrostad/Bachelor-Nordic_Semi/(list of files, cad)

Other CAD files:
Misc/3D-models/casing central lid test 2.obj
Misc/3D-models/casing central lid farg.obj
Misc/3D-models/casing central lid farg/casing central lid.obj
Misc/3D-models/casing central lid.skp
Misc/3D-models/casing central.skp
Misc/3D-models/casing relayer lid.skp
Misc/3D-models/casing relayer.skp
