simenrostad/Bachelor-Nordic_Semi/Misc/Measurements and calculations/Distance and redundancy/Code flow and overview/Application LOG_printout.xlsx

 |  | 5 packages | underestimated
 |  | relayer placed in back
 |  | central in front
1 to 10 | front |  | crowded |  |  | not crowded
10 to 20 | frontmiddle |  | central from button | central from relayer | central from relayer and button | central from button | central from relayer | central from relayer and button
20 to 30 | middle | 1
30 to 40 | middleback | 2
40 to 50 | back | 3
 |  | 4
 |  | 5
 |  | 6
 |  | 7
 |  | 8
 |  | 9
 |  | 10
 |  | 11
 |  | 12
 |  | 13
 |  | 14
 |  | 15
 |  | 16
 |  | 17
 |  | 18
 |  | 19
 |  | 20
 |  | 21
 |  | 22
 |  | 23
 |  | 24
 |  | 25
 |  | 26
 |  | 27
 |  | 28
 |  | 29
 |  | 30
 |  | 31
 |  | 32
 |  | 33
 |  | 34
 |  | 35
 |  | 36
 |  | 37
 |  | 38
 |  | 39
 |  | 40
 |  | 41
 |  | 42
 |  | 43
 |  | 44
 |  | 45
 |  | 46
 |  | 47
 |  | 48
 |  | 49
 |  | 50
