simenrostad/Bachelor-Nordic_Semi/Misc/Measurements and calculations/ZF button Caratersisation energy.xlsx

 | Caraterizinv the ZF butten genrator
 | resisten isn butttone generator = 51 Ohm
Inn push
 | Resistor Load | Volt Avrage | Time (delta) ms | system resistance | rms | Electrical Energy calculated from Volt avrage |  | EE calculated from rms and total resistance
data shett value | 100 | 1.1558 | 10 | 33.77 | 2.17 | 3.955799941e-05 |  | 0.0001394403317
TI tests | 300 | 1.4922 | 10 | 49.84 | 3.19 | 4.467618058e-05 |  | 0.0002041753612
avrage nrf 1 | 2200 | 1.42 | 10 | 43.58 | 3.88 | 4.62689307e-05 |  | 0.0003454428637
avrage nrf 2 | 2600 | 1.52 | 10 | 50 | 4.01 | 4.6208e-05 |  | 0.000321602
Out realese
 | Resistor Load | Volt Avrage | Time (delta) ms | system resistance | rms | Electrical Energy calculated from Volt avrage |  | EE calculated from rms and total resistance
data shett value | 100 | 1.209 | 10 | 33.77 | 2.12 | 4.328341723e-05 |  | 0.0001330885401
TI tests | 300 | 1.579 | 10 | 49.84 | 3.11 | 8.310803333e-06 |  | 0.0001940630016
avrage nrf 1 | 2200 | 1.78 | 10 | 43.58 | 3.98 | 1.440181818e-06 |  | 0.0003634786599
avrage nrf 2 | 2600 | 1.793 | 10 | 50 | 3.89 | 1.236480385e-06 |  | 0.000302642
Total PUSH and REALESE
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
