simenrostad/Bachelor-Nordic_Semi/Hardware/simulations/cuircuit components measurments/Electro Mecanical Generaor/2/genknap_2 – test 2.txt

+0.0E+00	-804.02E-03
+1.00E-03	-226.13E-03
+2.00E-03	-326.63E-03
+3.00E-03	-402.01E-03
+4.00E-03	-125.63E-03
+5.00E-03	-226.13E-03
+6.00E-03	-402.01E-03
+7.00E-03	-402.01E-03
+8.00E-03	+0.0E+00
+9.00E-03	-402.01E-03
+10.00E-03	-402.01E-03
+11.00E-03	+0.0E+00
+12.00E-03	-527.64E-03
+13.00E-03	-226.13E-03
+14.00E-03	-100.50E-03
+15.00E-03	-351.76E-03
+16.00E-03	-402.01E-03
+17.00E-03	-402.01E-03
+18.00E-03	-50.25E-03
+19.00E-03	+0.0E+00
+20.00E-03	-402.01E-03
+21.00E-03	-226.13E-03
+22.00E-03	-728.64E-03
+23.00E-03	-351.76E-03
+24.00E-03	-125.63E-03
+25.00E-03	+0.0E+00
+26.00E-03	-402.01E-03
+27.00E-03	-402.01E-03
+28.00E-03	-527.64E-03
+29.00E-03	-150.75E-03
+30.00E-03	-326.63E-03
+31.00E-03	-301.51E-03
+32.00E-03	-125.63E-03
+33.00E-03	-150.75E-03
+34.00E-03	-50.25E-03
+35.00E-03	-402.01E-03
+36.00E-03	-251.26E-03
+37.00E-03	-301.51E-03
+38.00E-03	+0.0E+00
+39.00E-03	-402.01E-03
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
