simenrostad/Bachelor-Nordic_Semi/Hardware/simulations/cuircuit components measurments/Electro Mecanical Generaor/2/genknap_2 – test – Kopi.txt

0.001000	-653.27E-03
0.002000	-226.13E-03
0.003000	-402.01E-03
0.004000	-351.76E-03
0.005000	-402.01E-03
0.006000	-552.76E-03
0.007000	-50.25E-03
0.008000	-427.14E-03
0.009000	-125.63E-03
0.010000	-402.01E-03
0.011000	-326.63E-03
0.012000	-402.01E-03
0.013000	+0.0E+00
0.014000	-402.01E-03
0.015000	-50.25E-03
0.016000	-25.13E-03
0.017000	-125.63E-03
0.018000	-150.75E-03
0.019000	-728.64E-03
0.020000	-402.01E-03
0.021000	-125.63E-03
0.022000	+0.0E+00
0.023000	-402.01E-03
0.024000	-402.01E-03
0.025000	-125.63E-03
0.026000	-326.63E-03
0.027000	+0.0E+00
0.028000	-351.76E-03
0.029000	+0.0E+00
0.030000	+0.0E+00
0.031000	-326.63E-03
0.032000	-402.01E-03
0.033000	-527.64E-03
0.034000	+0.0E+00
0.035000	+0.0E+00
0.036000	-402.01E-03
0.037000	+0.0E+00
0.038000	-150.75E-03
0.039000	-326.63E-03
0.040000	-351.76E-03
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
