simenrostad/Bachelor-Nordic_Semi/Hardware/Components/Simulations and tests/energystorage_.PNG

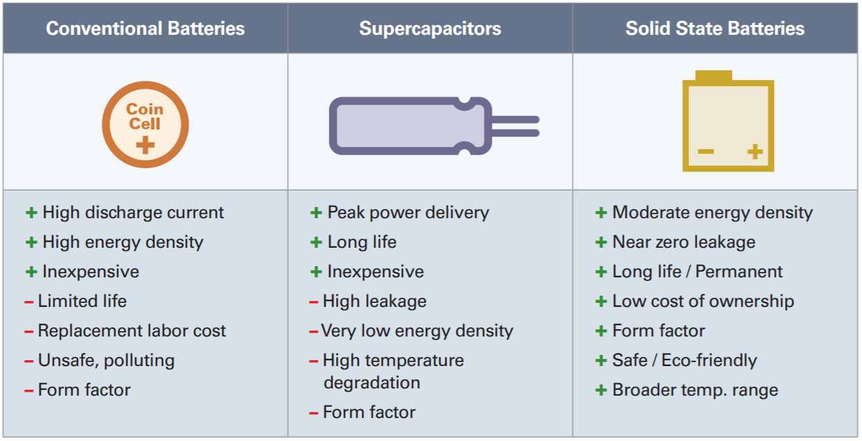
Hardware/Components/Simulations and tests/energystorage_.PNG
