simenrostad/Bachelor-Nordic_Semi/Hardware/Components/Simulations and tests/Simulering LT-spice1.PNG

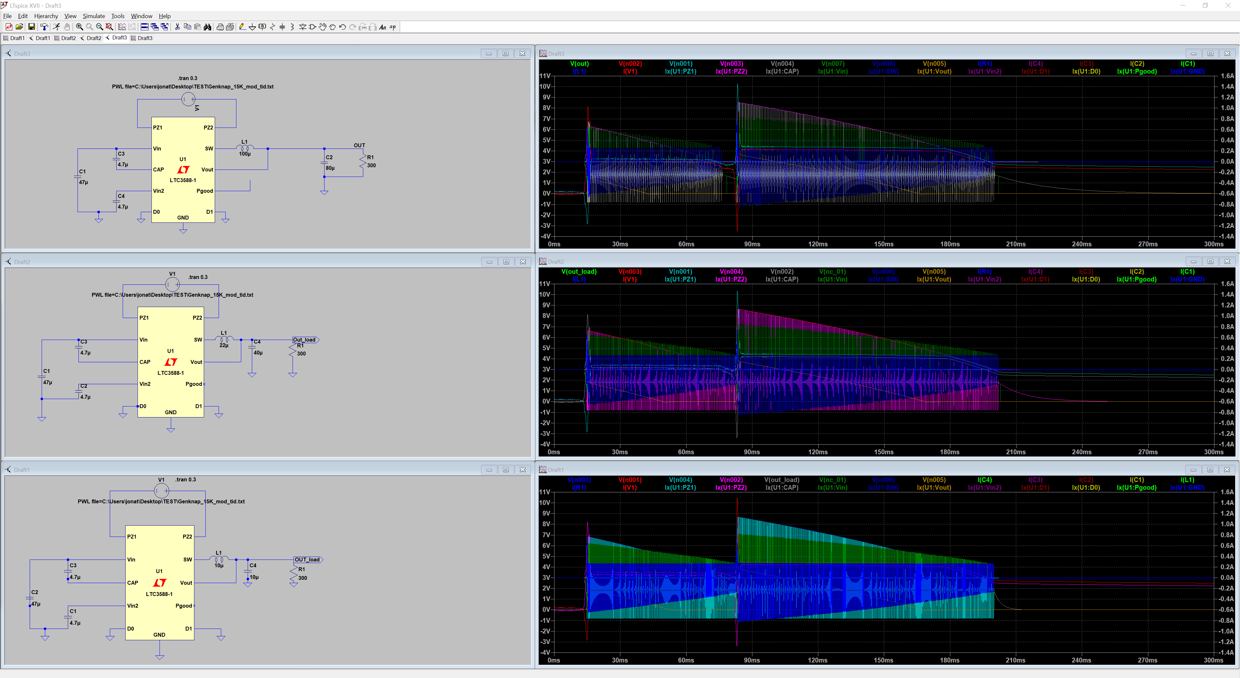
Hardware/Components/Simulations and tests/Simulering LT-spice1.PNG
