simenrostad/Bachelor-Nordic_Semi/Hardware/Components/Simulations and tests/Simulering LT-spice2.PNG

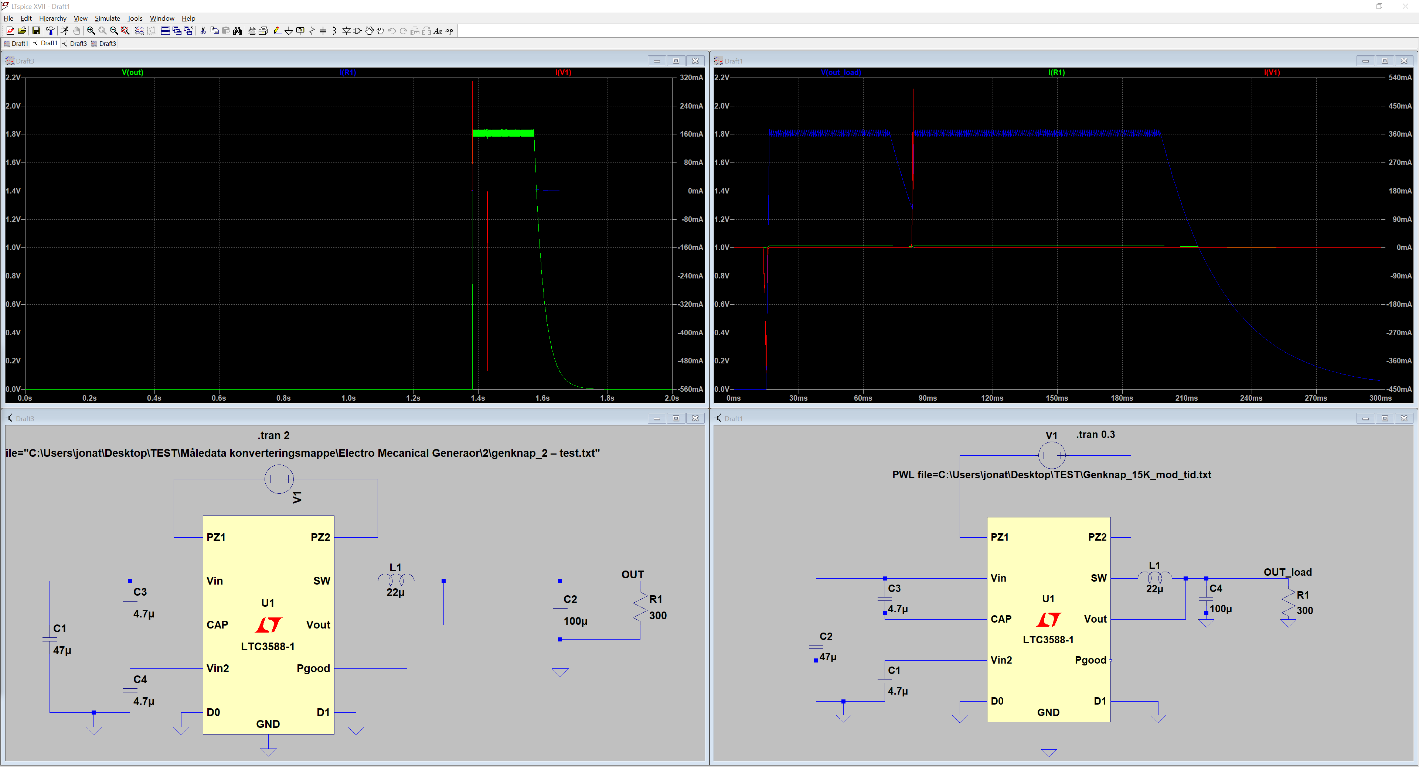
Hardware/Components/Simulations and tests/Simulering LT-spice2.PNG
