simenrostad/Bachelor-Nordic_Semi/Hardware/Components/Simulations and tests/Simulink tests fore difrent cuircuits.PNG

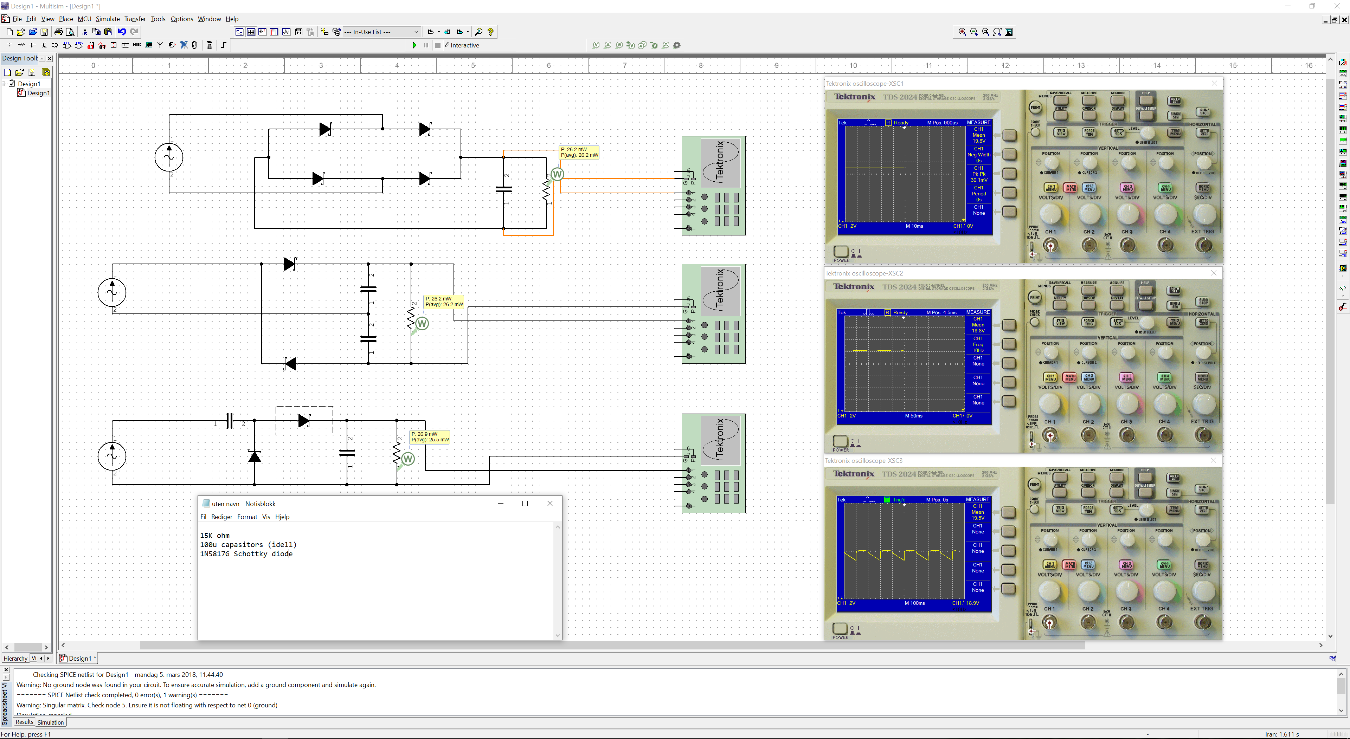
Hardware/Components/Simulations and tests/Simulink tests fore difrent cuircuits.PNG
