simenrostad/Bachelor-Nordic_Semi/Hardware/simulations/cuircuit components measurments/Electro Mecanical Generaor/singel puls/2k6 ohm/Komponent testing/1v8_LTC_spool/spoll_curcuit_ltc/spoll_curcuit_ltc-1.jpg

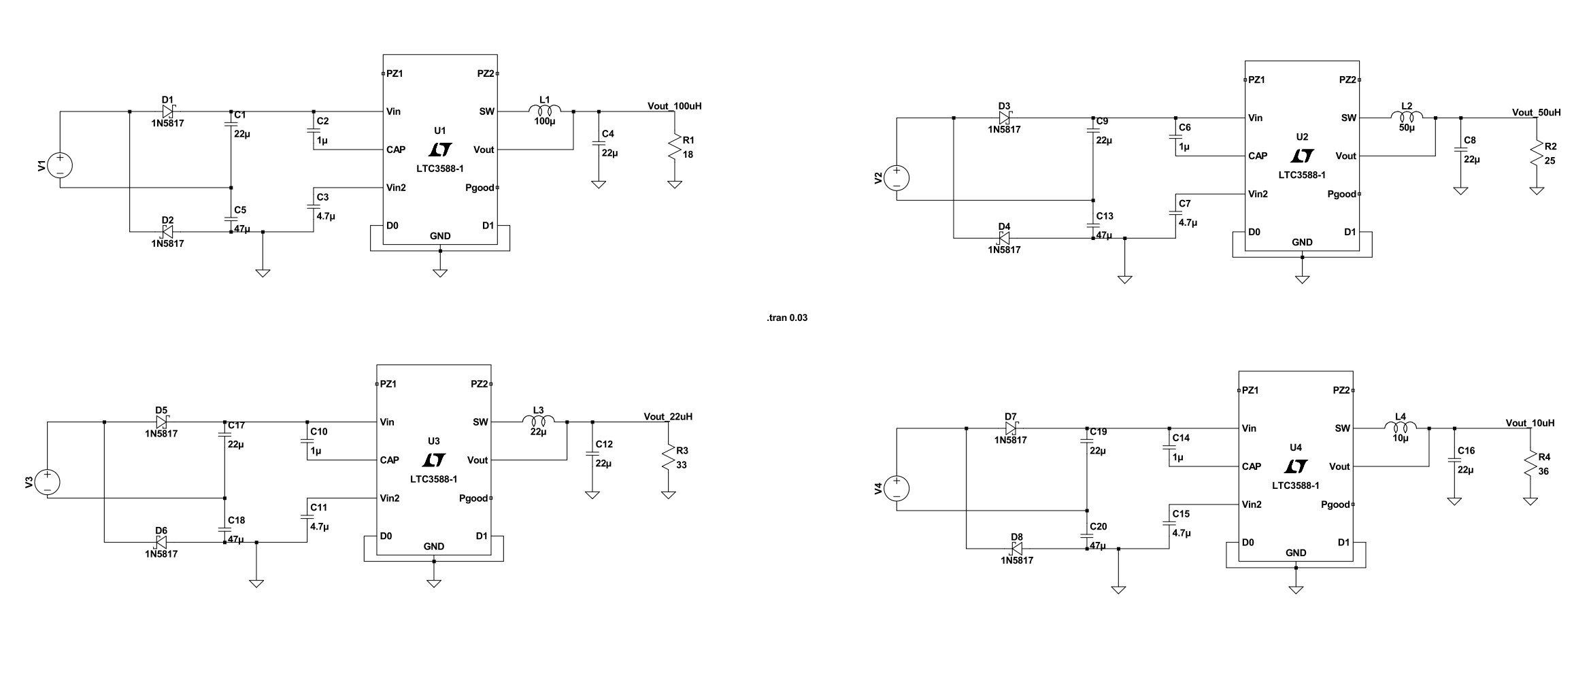
Hardware/simulations/cuircuit components measurments/Electro Mecanical Generaor/singel puls/2k6 ohm/Komponent testing/1v8_LTC_spool/spoll_curcuit_ltc/spoll_curcuit_ltc-1.jpg
