simenrostad/Bachelor-Nordic_Semi/Hardware/simulations/cuircuit components measurments/Electro Mecanical Generaor/singel puls/2k6 ohm/LTC_Pz cuircuit sim/one puls/LTC-cuircuit_test_1V8_2V5_3V3_3V6_from one puls-1.png

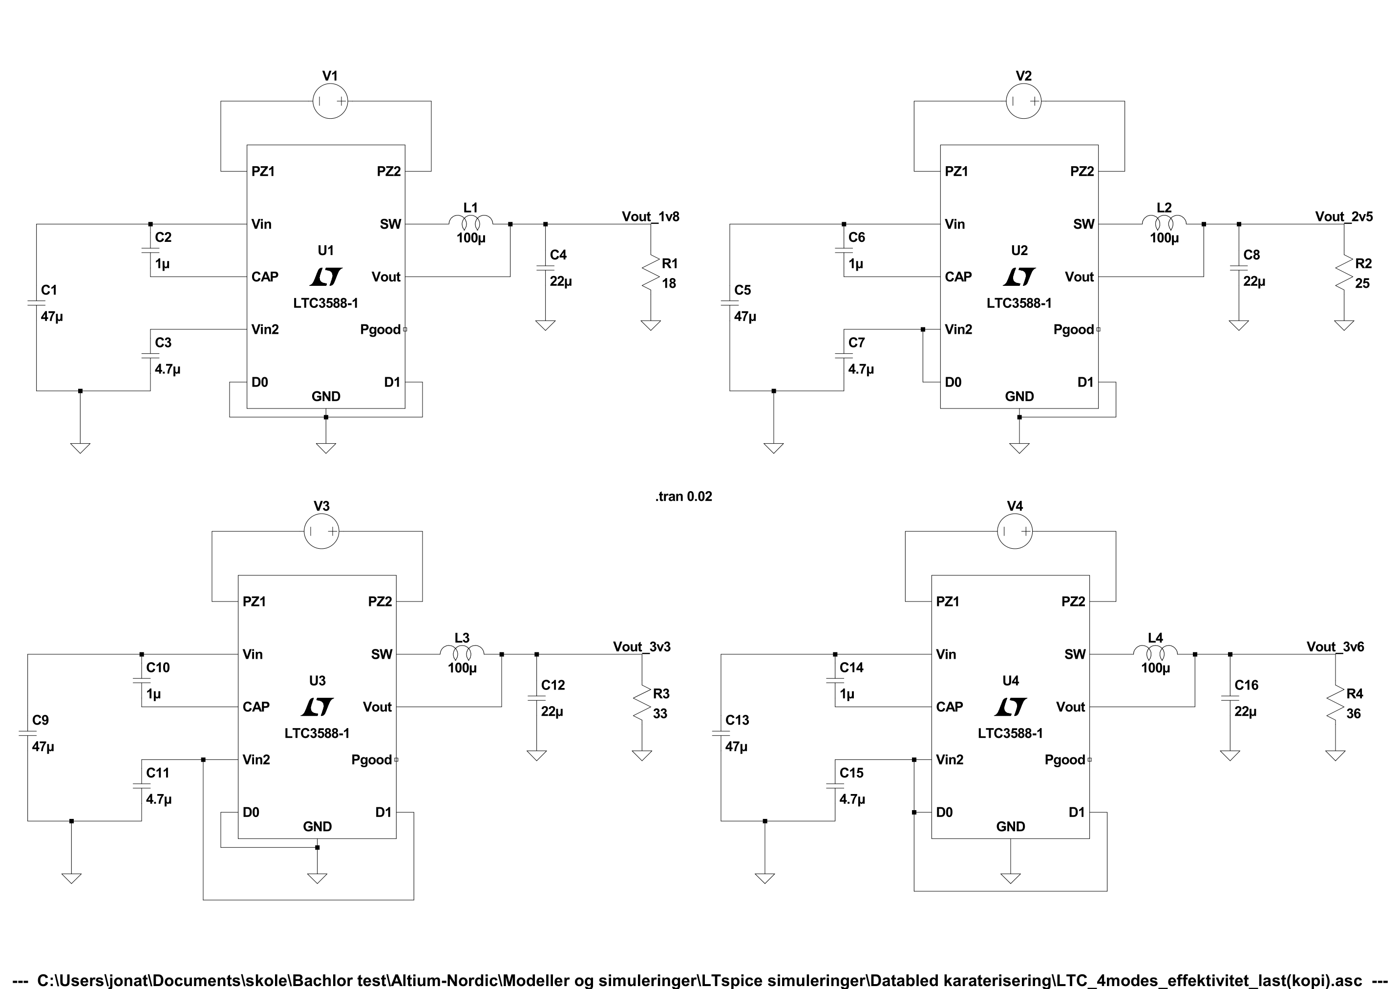
Hardware/simulations/cuircuit components measurments/Electro Mecanical Generaor/singel puls/2k6 ohm/LTC_Pz cuircuit sim/one puls/LTC-cuircuit_test_1V8_2V5_3V3_3V6_from one puls-1.png
