simenrostad/Bachelor-Nordic_Semi/Hardware/simulations/cuircuit components measurments/Electro Mecanical Generaor/singel puls/2k6 ohm/comperig cuircuits/1v8_samenligning.pdf

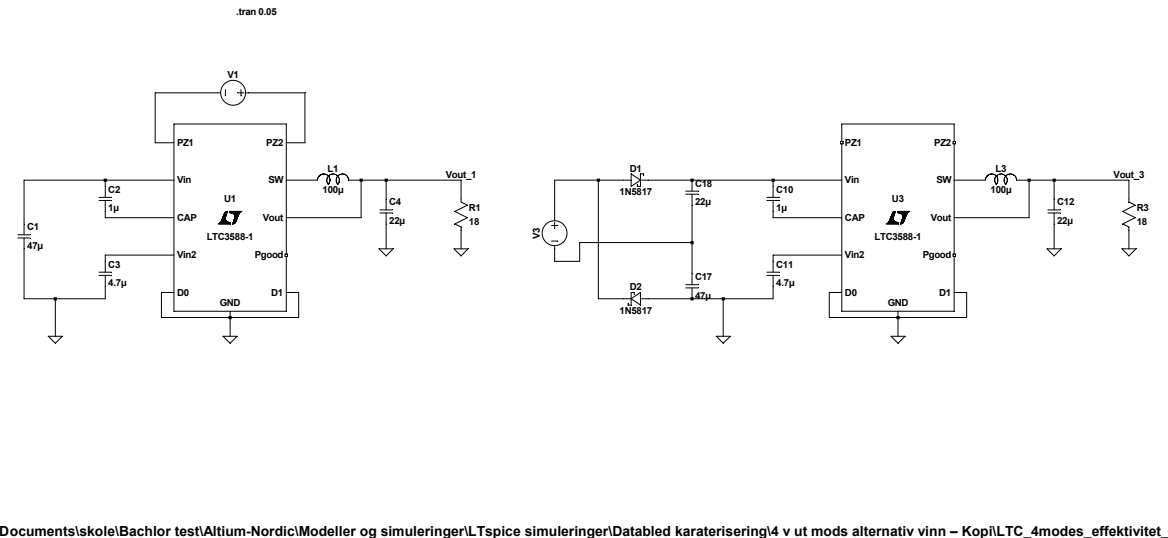
[picture p136: page 1]

--- C:\Users\jonat\Documents\skole\Bachlor test\Altium-Nordic\Modeller og simuleringer\LTspice simuleringer\Databled karaterisering\4 v ut mods alternativ vinn – Kopi\LTC_4modes_effektivitet_last(kopi)2.asc ---
