simenrostad/Bachelor-Nordic_Semi/Hardware/Litteratur/mini_drone.pdf

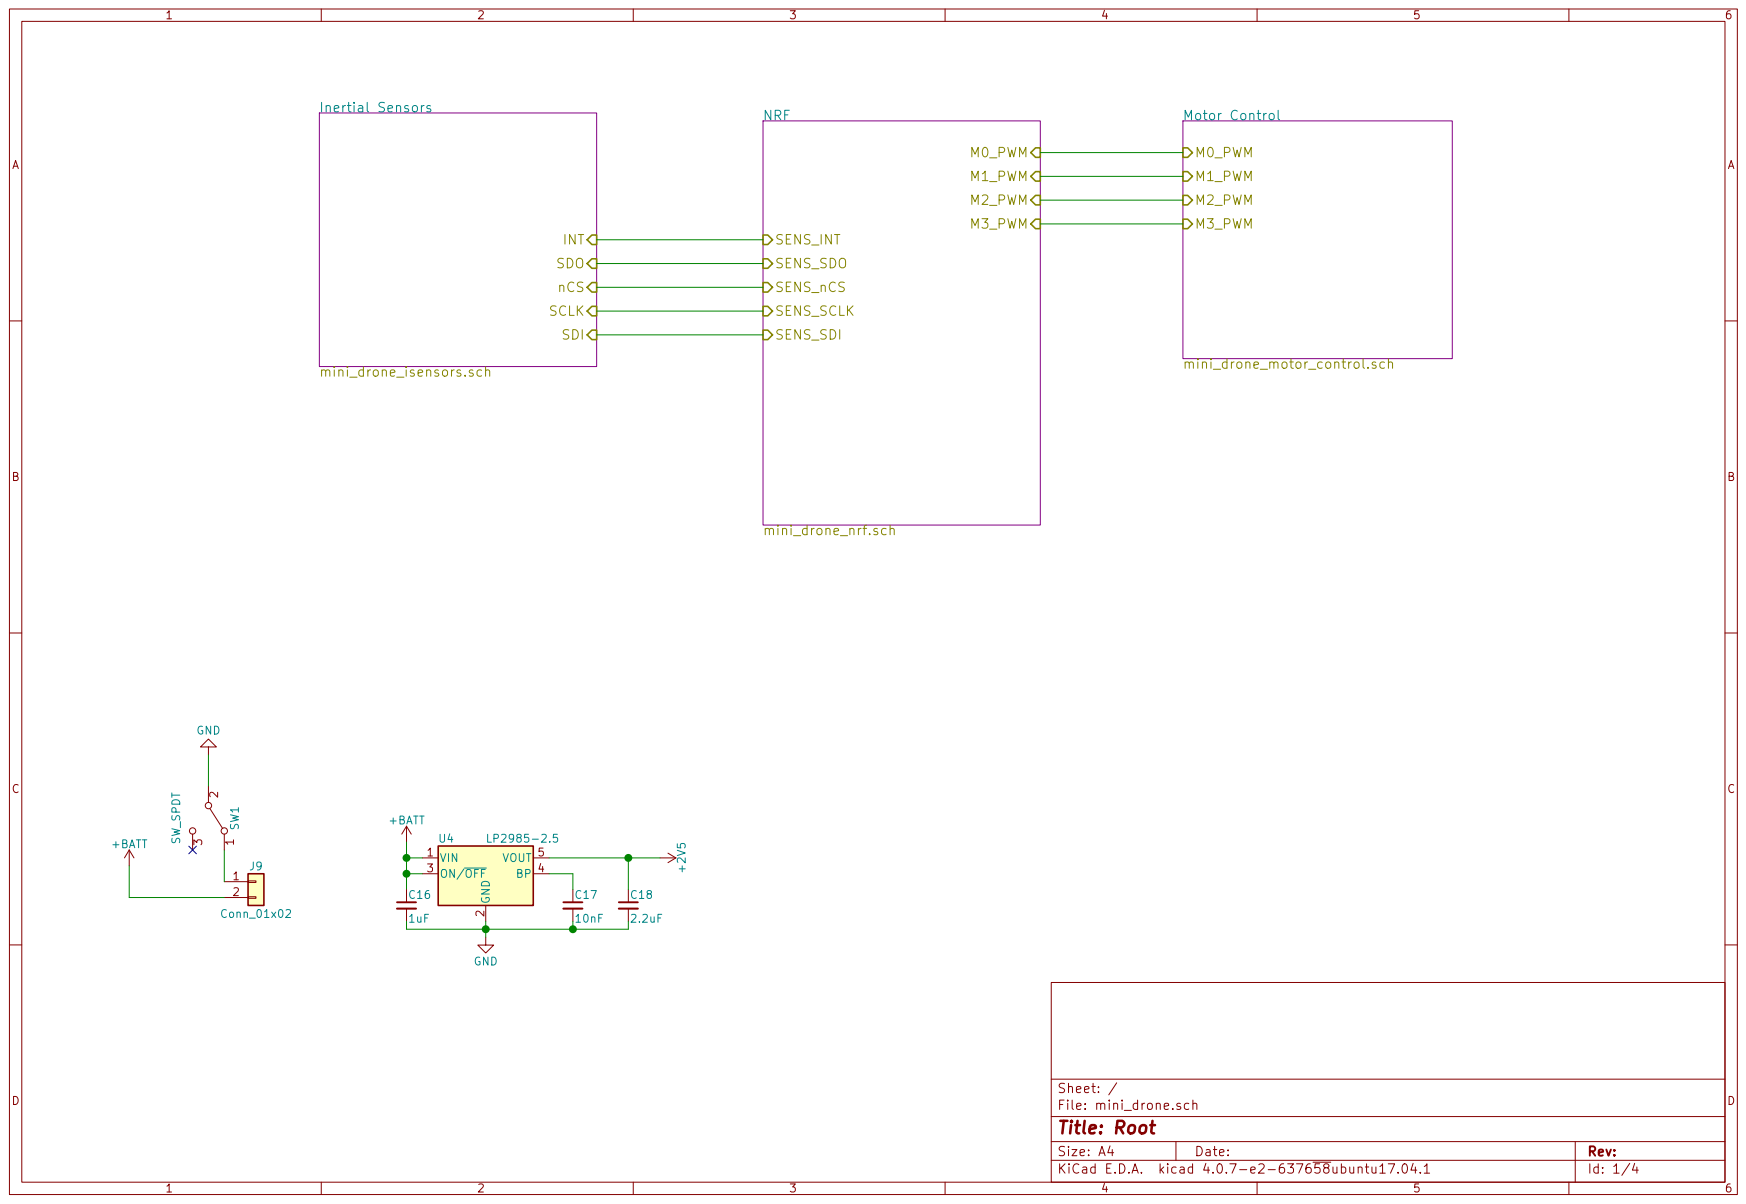
[picture p137: page 1]

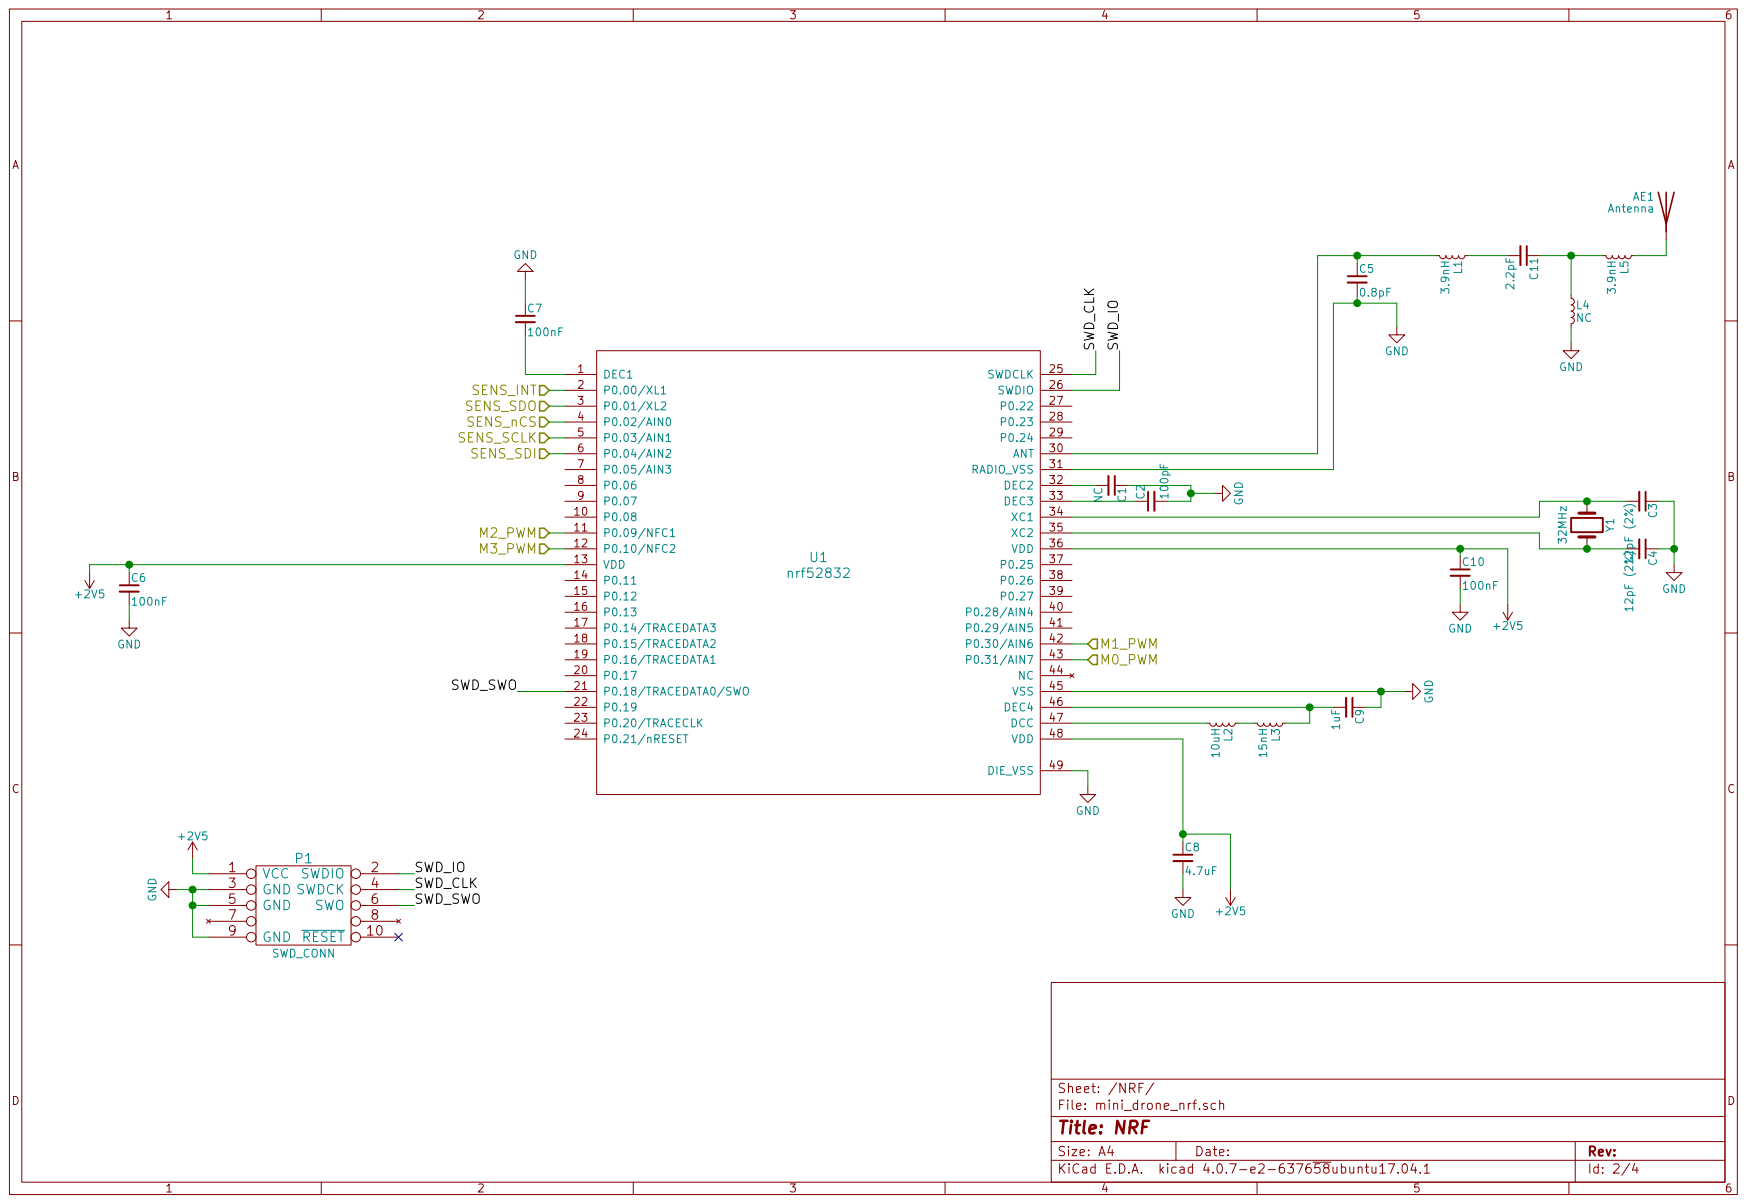
[picture p138: page 2]

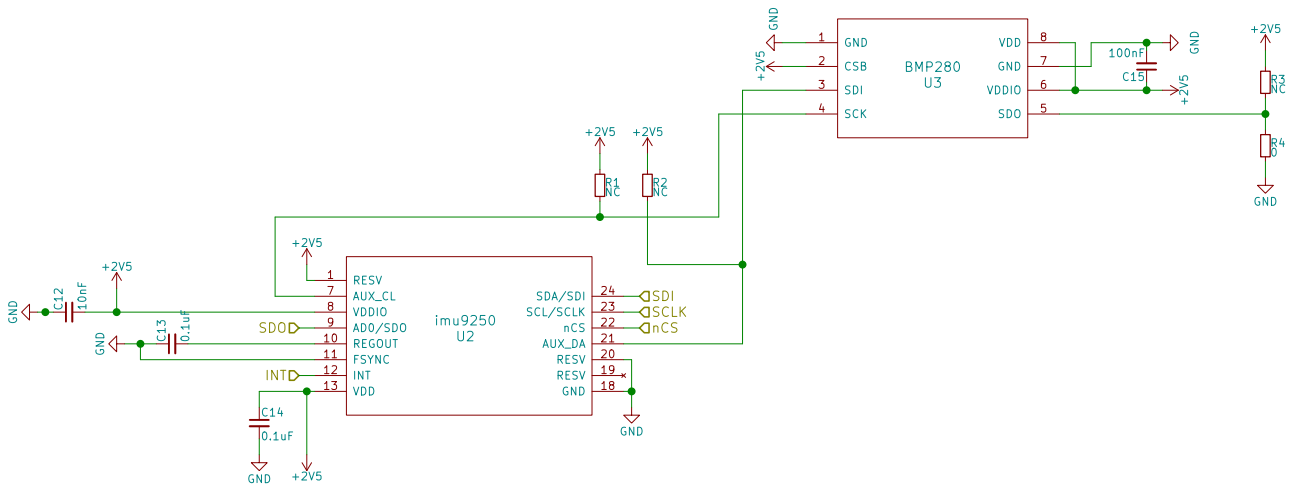
[picture p139: page 3]

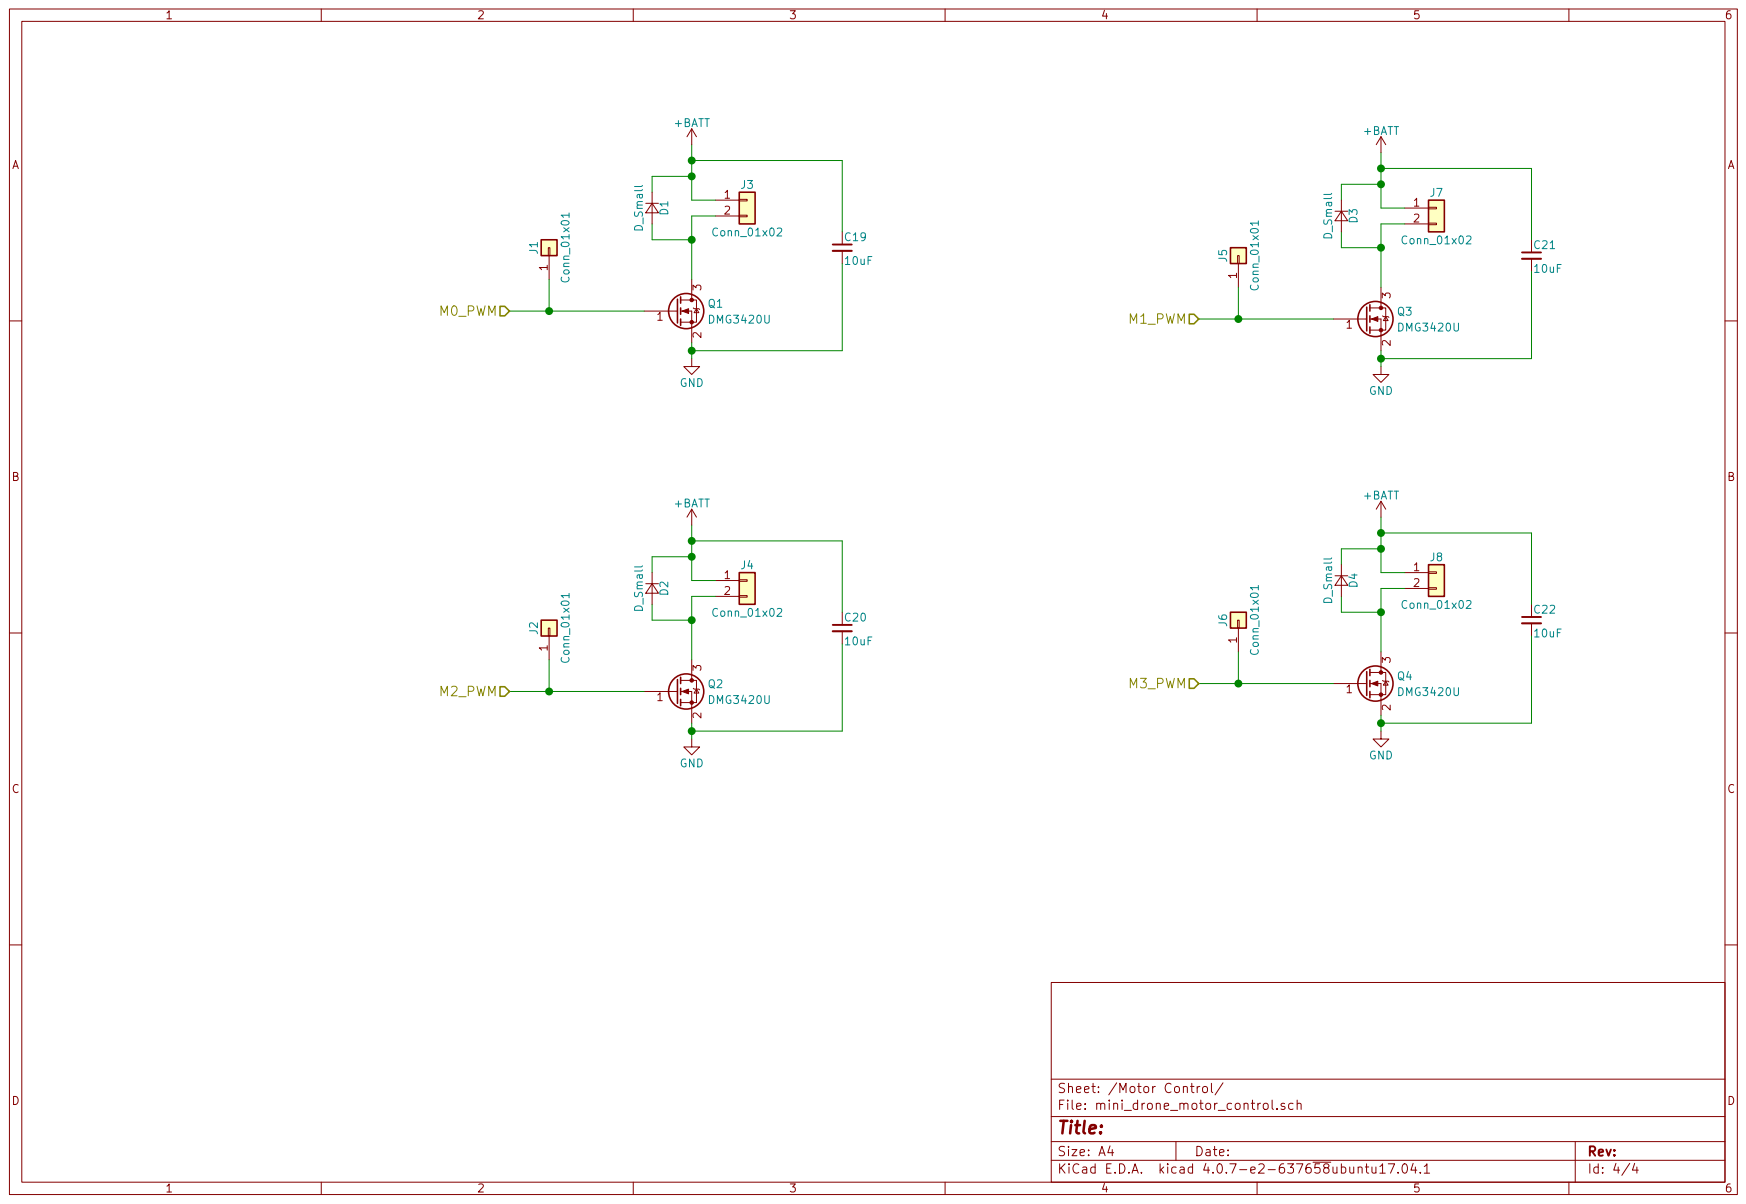
[picture p140: page 4]
