simenrostad/Bachelor-Nordic_Semi/Hardware/simulations/cuircuit components measurments/Electro Mecanical Generaor/singel puls/2k6 ohm/LTC_altsolution_Vinn sim/out.pdf

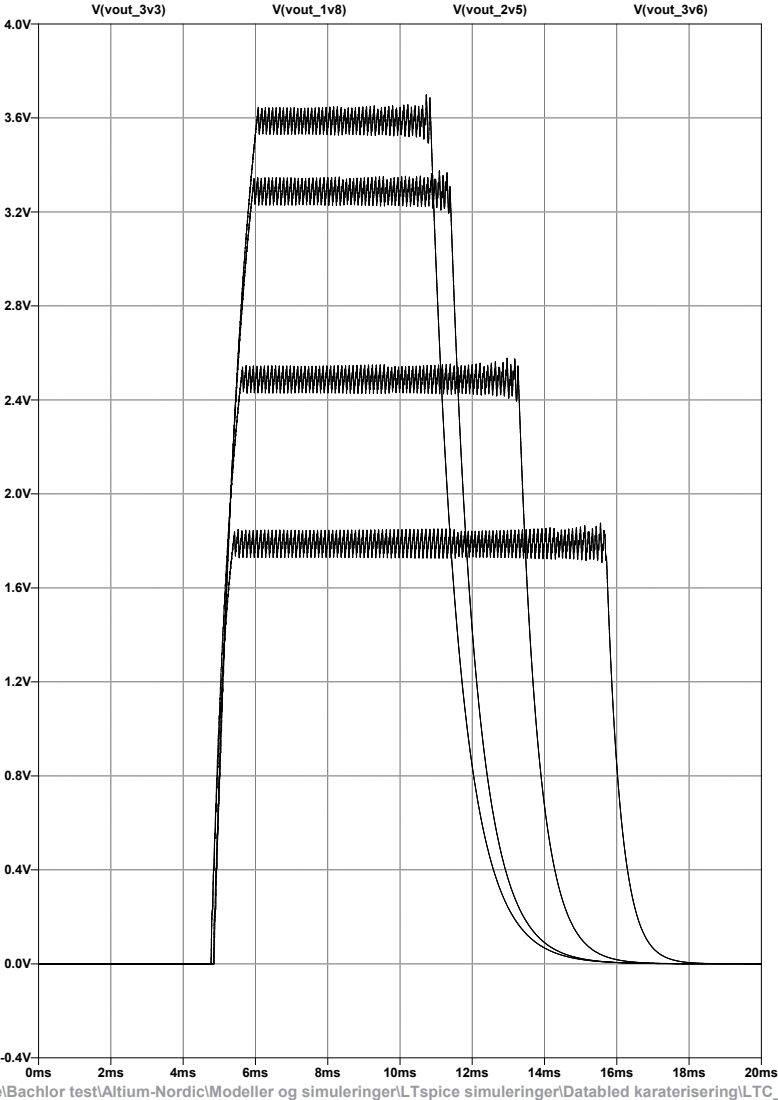
[picture p141: page 1]
V(vout_3v3); V(vout_1v8); V(vout_2v5); V(vout_3v6)

--- C:\Users\jonat\Documents\skole\Bachlor test\Altium-Nordic\Modeller og simuleringer\LTspice simuleringer\Databled karaterisering\LTC_4modes_effektivitet_last(kopi).raw ---
