simenrostad/Bachelor-Nordic_Semi/Hardware/simulations/cuircuit components measurments/Electro Mecanical Generaor/singel puls/2k6 ohm/Komponent testing/1v8_LTC_spool/Spoole_test_LTC_1v8.pdf

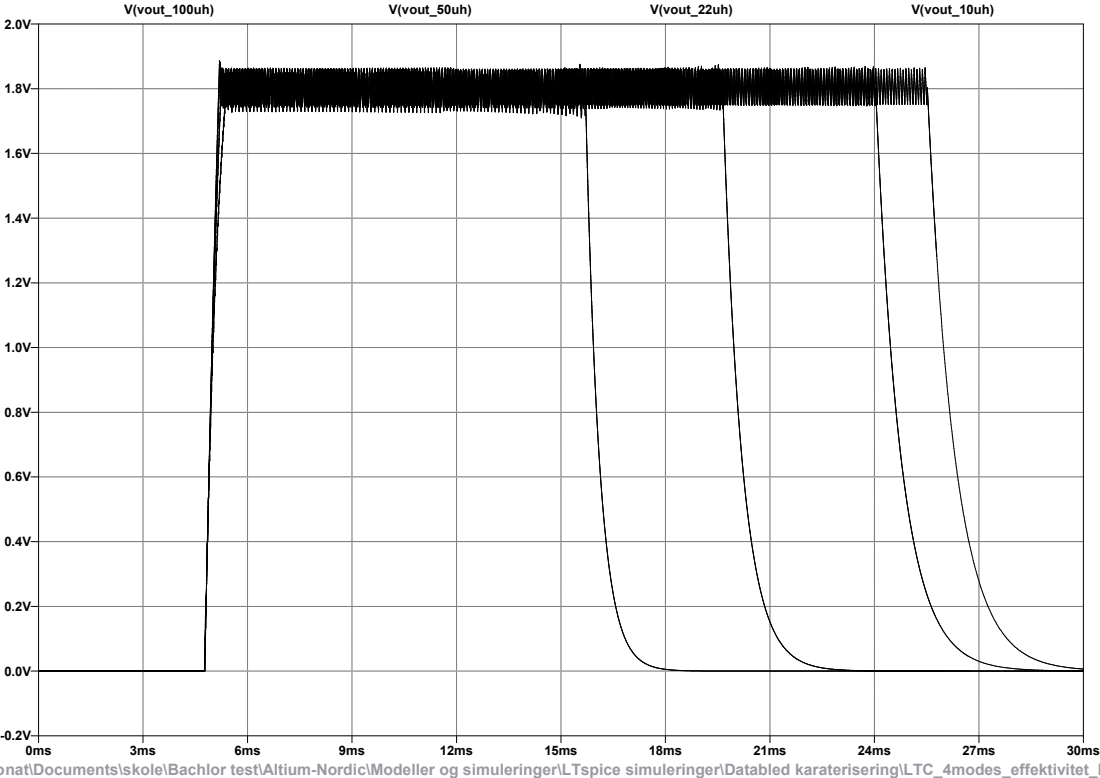
[picture p142: page 1]
V(vout_100uh); V(vout_50uh); V(vout_22uh); V(vout_10uh)

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
