simenrostad/Bachelor-Nordic_Semi/Hardware/simulations/cuircuit components measurments/Electro Mecanical Generaor/singel puls/2k6 ohm/LTC_Pz cuircuit sim/one puls/LTC_test_1V8_2V5_3V3_3V6_from one puls.pdf

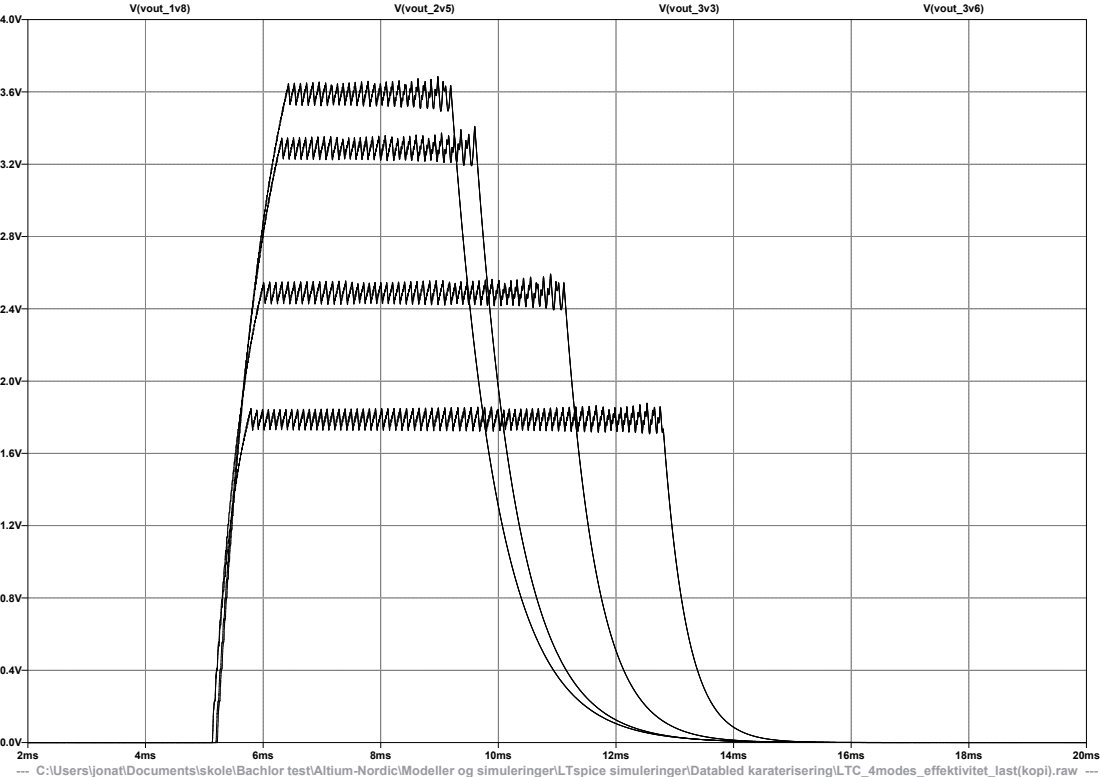
[picture p143: page 1]
V(vout_1v8); V(vout_2v5); V(vout_3v3); V(vout_3v6)

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
