simenrostad/Bachelor-Nordic_Semi/(list of files, drawings)

Other design files:
Hardware/Altium/Schematichs and Project files/Drafts for final/Final_1_Board.PcbDoc
Hardware/Altium/Schematichs and Project files/Drafts for final/Final_1_Board.PrjPCB
Hardware/Altium/Schematichs and Project files/Drafts for final/Final_1_Board.SchDoc
Hardware/Components/Simulations and tests/3 cuiruit test.ms14
