simenrostad/Bachelor-Nordic_Semi/(commit log)

2018-02-14 Added bachelor folder
    [config.txt]
2018-02-14 Fikset problem ved LED stuck ved funn av UUID
    [main.c]
2018-02-14 Added test folder for to connect RELAYER to CENTRAL OBS
2018-02-14 Cleaned example folder, easier access
    [config.txt]
2018-02-14 Konsept flow chart.xml
2018-02-14 Endret plassering flow chart
2018-03-01 more hardware info
    [Komponent liste (undersøk).xlsx]
2018-03-05 measurments and simulations
    [3 cuiruit test.ms14]
2018-03-05 comm with relayer
2018-03-06 Measurment data and simulations
    [3 cuiruit test.ms14, fwrb.csv, fwvd1.csv, hwvd.csv, mg1.csv, scope_0.csv, scope_6.csv, scope_7.csv]
2018-03-06 Connection and communication between central and relayer
2018-03-06 added measurements PPK
    [Results initial ppk measurements.xlsx]
2018-03-06 componet updates
    [Komponent liste (undersøk).xlsx]
2018-03-07 central - with connection and communication to relayer
2018-03-07 updated parts list
    [Komponent liste (undersøk).xlsx]
2018-03-14 exel test
    [Design spesification 1.1.xlsx]
2018-03-14 mod design spec
    [Design spesification 1.1.xlsx]
2018-03-14 replaced files under ble_periph
    [main.c, sdk_config.h]
2018-03-19 added RC clock to design spesification
    [Design spesification 1.1.xlsx]
2018-03-20 trying to transfer whitelist entries to relayer
2018-03-21 Relayer passes unknown UUID to central
2018-03-22 fixed so no longer possible to add same button several times
    [main.c]
2018-03-23 Add files via upload
    Breakout circuits for rectifiers and the LTC regulator.
2018-03-23 bug fixes relayer central connection
2018-03-28 Updated flowchart
2018-04-04 moved the projects back - did not work out
    [main.c, sdk_config.h]
2018-04-04 updated code flow chart
2018-04-05 Trying to limit number of sent packages from button for fieldtesting
2018-04-06 Modified the button code to stop advertising after 5 adv events
2018-04-06 copied relayer from master
2018-04-10 Updated design spesification
    [Design spesification and energy budget 1.2.xlsx]
2018-04-10 Updated design spec
    [redundancy in bus initial.xlsx]
2018-04-12 cleaned up project folders
    [Design spesification 1.1.xlsx]
2018-04-14 simulations dokumentation
    [LTC_simulerings_data.xlsx]
2018-04-17 all buttons now go in the "whitelist"
2018-04-19 progga beacon og relayer
2018-04-25 data for masuring
    [LTC_simulerings_data.xlsx, funk_2_1.csv, funk_3.csv, funk_4_1.csv, fwrb.csv, fwvd1.csv, genknap_2 separert2colon.xlsx, genknap_2 – Kopi.csv]
2018-04-26 relayer acting strange. Trying to figure out why
2018-05-02 trying to get relayer o respect set intervals
2018-05-10 feil lsit for 12 uF opdater til rikgit
    [Handle og komponent liste til pcb.xlsx]
2018-05-28 3d model coulor
    [casing relayer farg.obj]
2018-05-28 more models whith coulour
    [casing central farg.obj, casing central lid farg.obj, casing relayer lid farge.obj]
2018-05-28 one more tim for th elid of central
    [casing central lid FARGFUI.obj]
