simenrostad/Bachelor-Nordic_Semi/(notices)

Notices in the files:
Misc/3D-models/casing central farg.obj:
Exported from SketchUp, (c) 2000-2012 Trimble Navigation Limited
